Tinkerforge/kicad-libraries/3d/Batteries/battery_retainer_small.fcstd

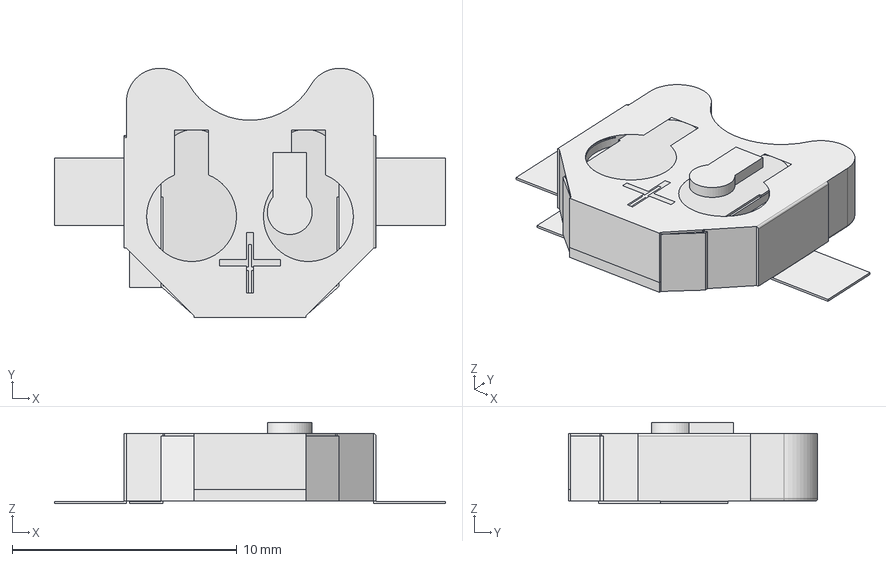
[picture p1: CAD file, 2018-07-31]
3d/Batteries/battery_retainer_small.fcstd
17.4 x 11.1 x 3.62 mm
battery
battery001
