Tinkerforge/kicad-libraries/3d/Buttons_Switches/DIP_SW_2LPST.step

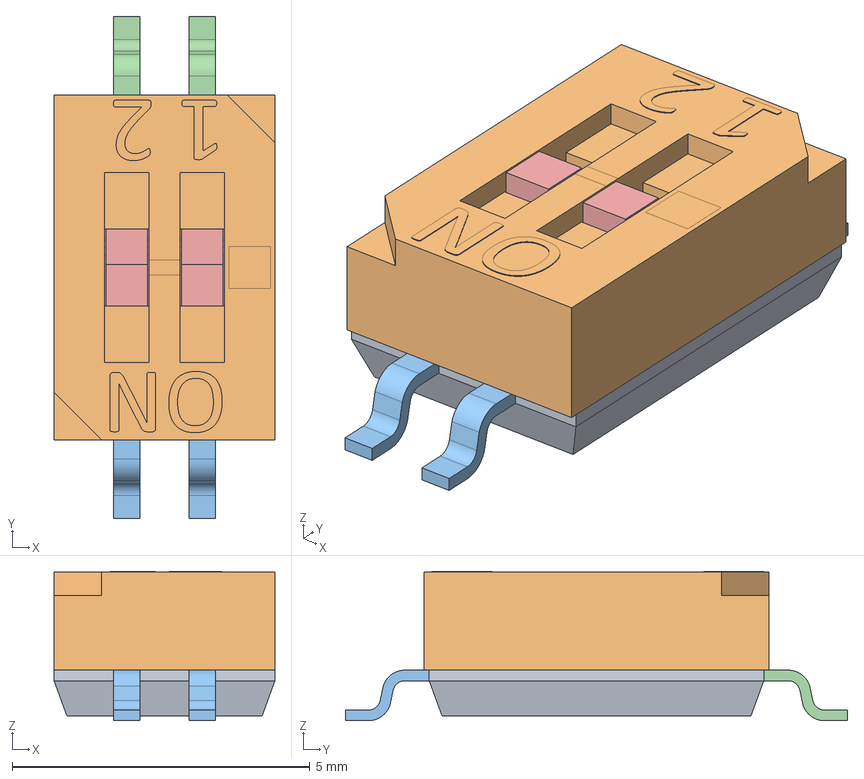
[picture p2: CAD file, 2025-08-05]
3d/Buttons_Switches/DIP_SW_2LPST.step
3.71 x 8.43 x 2.51 mm
