Tinkerforge/kicad-libraries/3d/Capacitors_SMD/ELNA_DSK.step

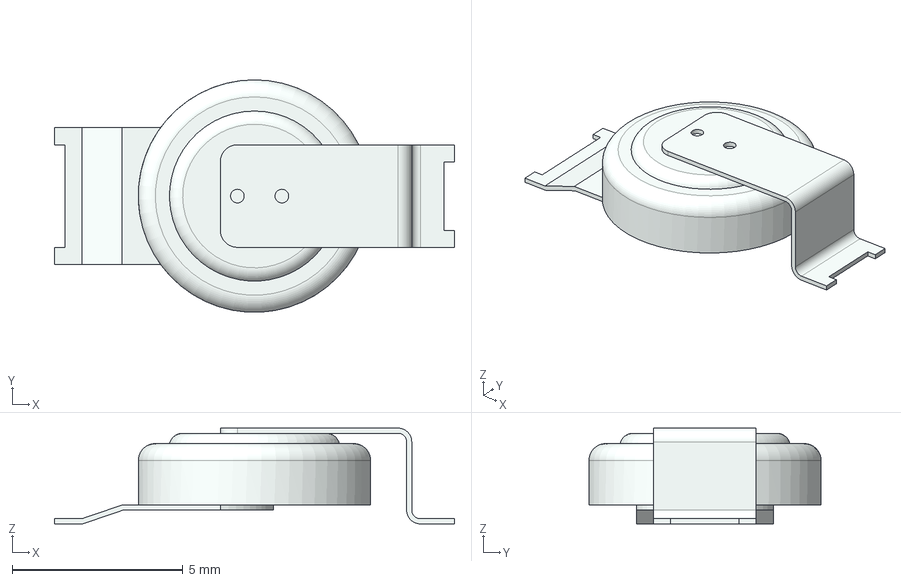
[picture p3: CAD file, 2019-04-26]
3d/Capacitors_SMD/ELNA_DSK.step
11.7 x 6.80 x 2.80 mm
