Tinkerforge/kicad-libraries/3d/Capacitors_Tantalum_SMD/Tantalum_Case-T_EIA-3528-12.step

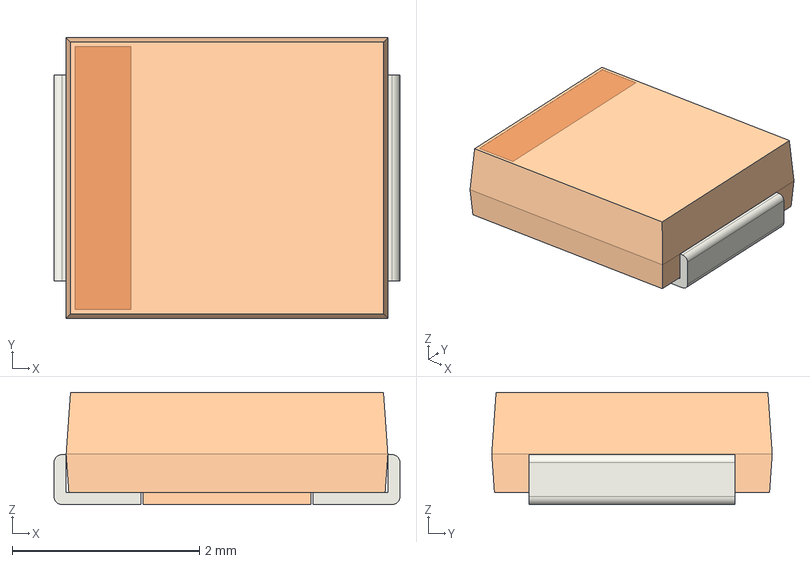
[picture p4: CAD file, 2017-03-24]
3d/Capacitors_Tantalum_SMD/Tantalum_Case-T_EIA-3528-12.step
3.70 x 3.00 x 1.20 mm
