Tinkerforge/kicad-libraries/3d/Connectors/TBLH10_350_05.step

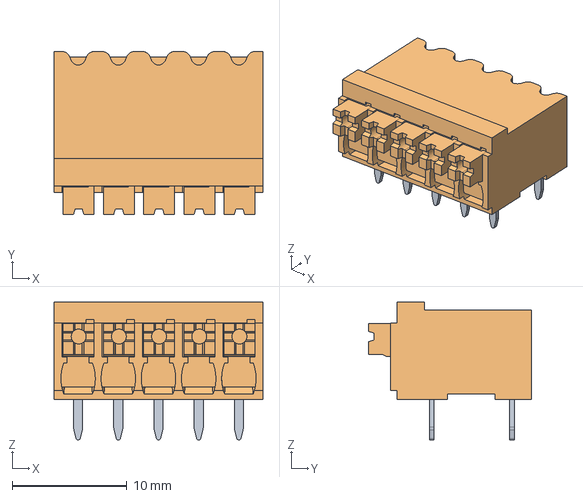
[picture p5: CAD file, 2025-08-05]
3d/Connectors/TBLH10_350_05.step
18.2 x 14.2 x 12.0 mm
