Tinkerforge/kicad-libraries/3d/Fuses/Fuse_Holder_5x20_HOR.step

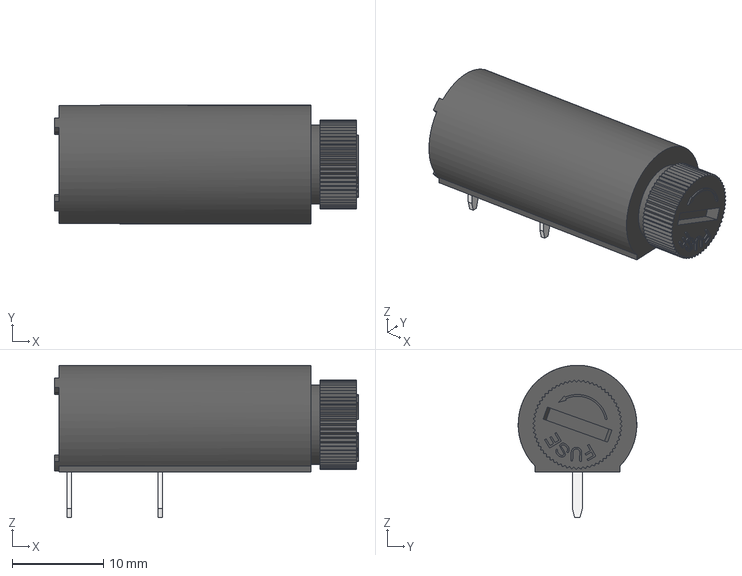
[picture p6: CAD file, 2023-06-30]
3d/Fuses/Fuse_Holder_5x20_HOR.step
33.3 x 13.0 x 16.7 mm
