Tinkerforge/kicad-libraries/3d/Housing_BGA/TFBGA-336_14x14mm.step

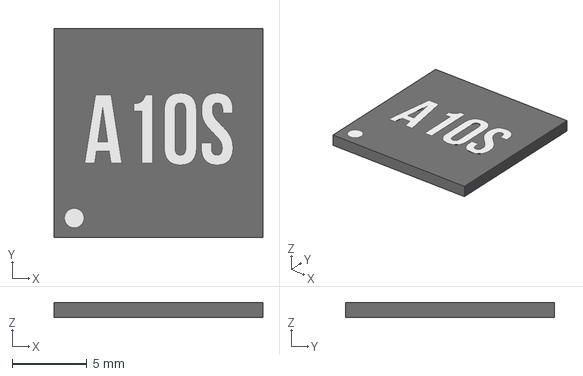
[picture p7: CAD file, 2017-07-27]
3d/Housing_BGA/TFBGA-336_14x14mm.step
14.0 x 14.0 x 1.01 mm
