Tinkerforge/kicad-libraries/3d/Housing_SO/SOP4.step

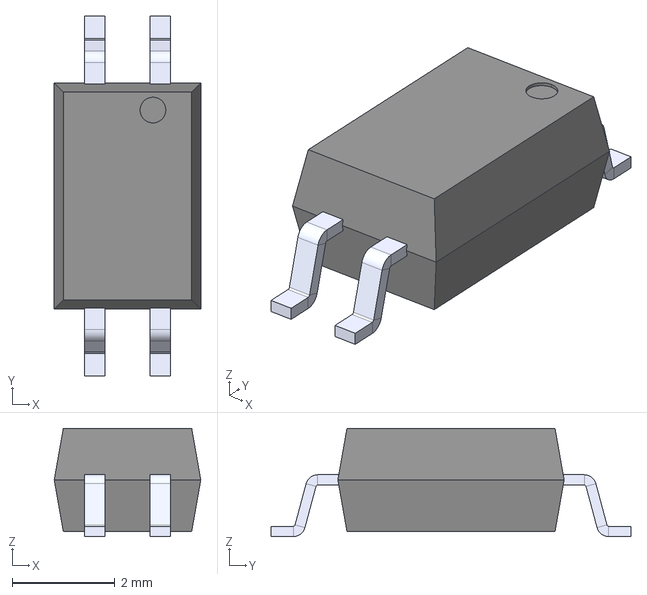
[picture p8: CAD file, 2023-06-30]
3d/Housing_SO/SOP4.step
2.85 x 7.00 x 2.10 mm
