Tinkerforge/kicad-libraries/3d/Housing_SOT_SOD/SSOT-6.step

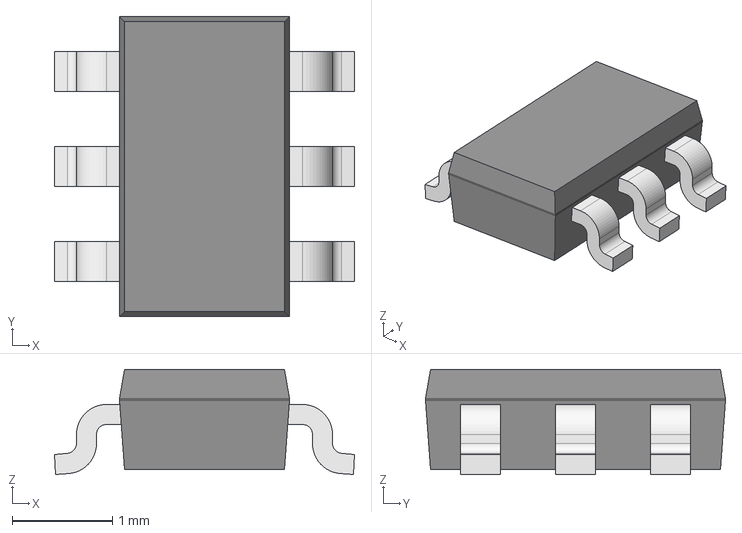
[picture p9: CAD file, 2017-08-04]
3d/Housing_SOT_SOD/SSOT-6.step
3.00 x 3.00 x 1.05 mm
