Tinkerforge/kicad-libraries/3d/Housing_special/ESP32-WROVER-E.step

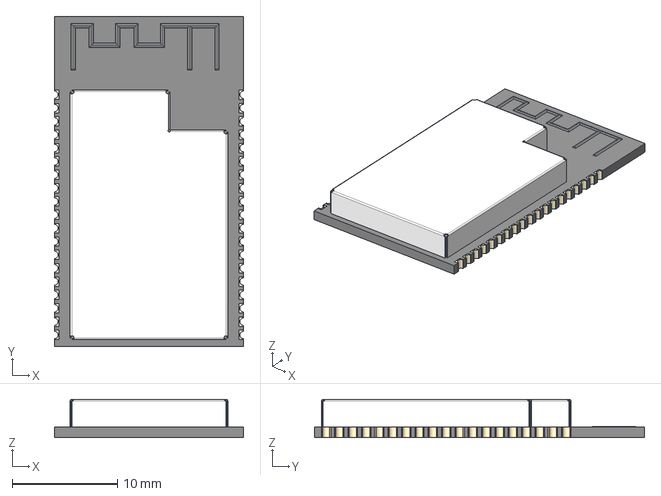
[picture p10: CAD file, 2022-04-01]
3d/Housing_special/ESP32-WROVER-E.step
18.0 x 31.4 x 3.65 mm
