Tinkerforge/kicad-libraries/3d/Housing_SSOP/SSO-8.step

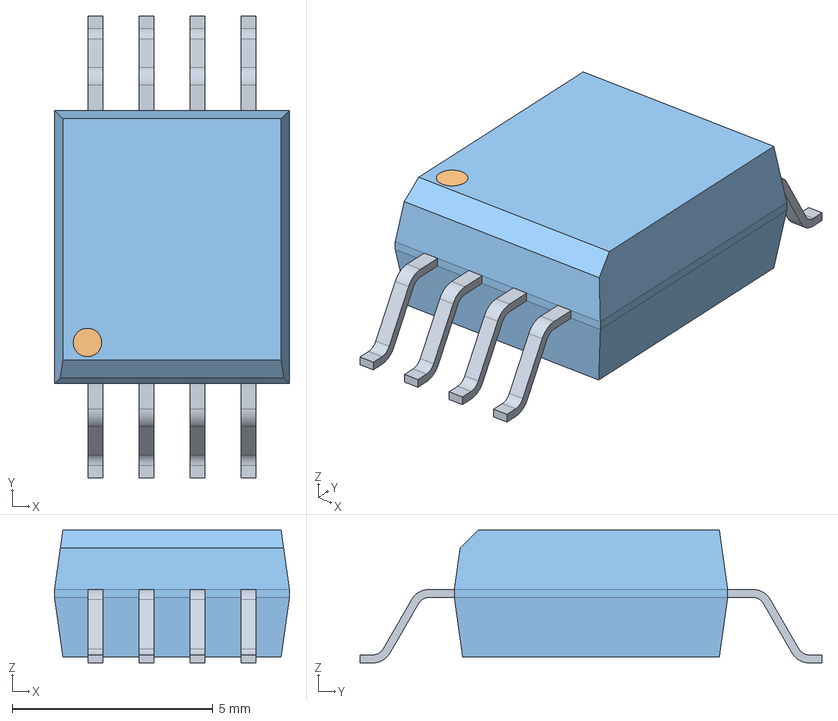
[picture p11: CAD file, 2026-03-05]
3d/Housing_SSOP/SSO-8.step
5.85 x 11.5 x 3.31 mm
