Tinkerforge/kicad-libraries/3d/Housings_DFN_QFN/LFCS8-3x3.step

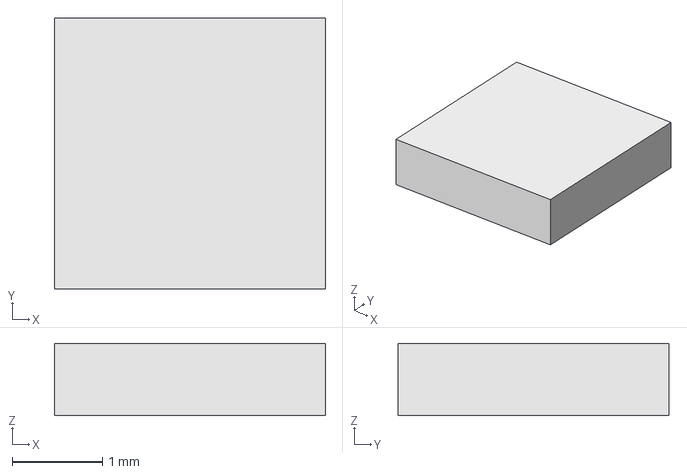
[picture p12: CAD file, 2019-11-07]
3d/Housings_DFN_QFN/LFCS8-3x3.step
3.00 x 3.00 x 0.8 mm
