Tinkerforge/kicad-libraries/3d/Housings_DIP/PDIP-8.step

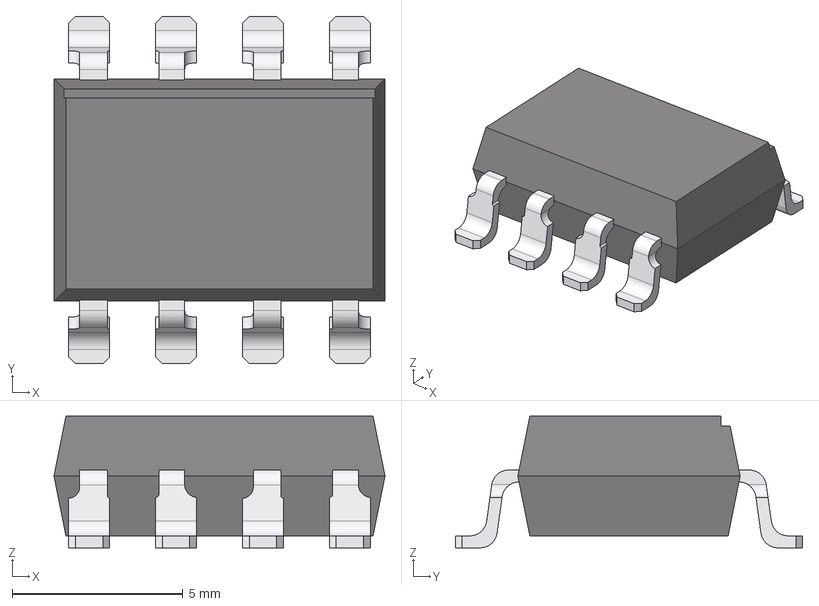
[picture p13: CAD file, 2023-02-17]
3d/Housings_DIP/PDIP-8.step
9.68 x 10.2 x 3.85 mm
