Tinkerforge/kicad-libraries/3d/Housings_DO/SMB.step

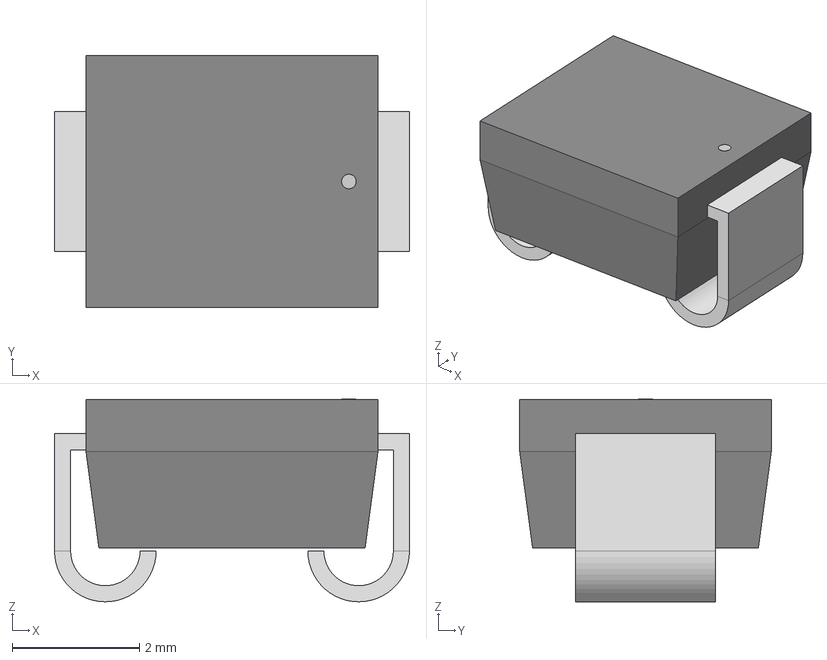
[picture p14: CAD file, 2019-11-05]
3d/Housings_DO/SMB.step
5.59 x 3.96 x 3.19 mm
