Tinkerforge/kicad-libraries/3d/Housings_QFP/LQFP-52-1EP_10x10mm_Pitch0.65mm.step

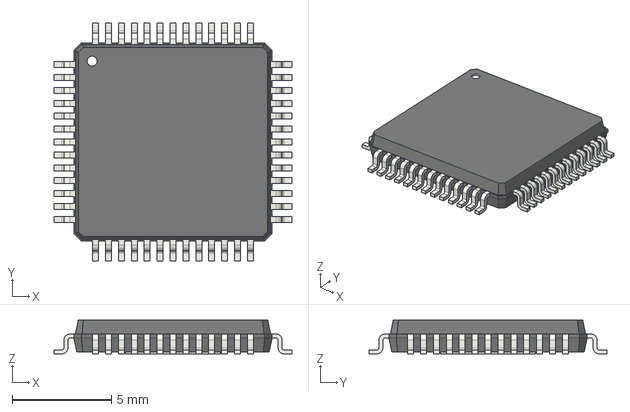
[picture p15: CAD file, 2017-03-24]
3d/Housings_QFP/LQFP-52-1EP_10x10mm_Pitch0.65mm.step
12.0 x 12.0 x 1.70 mm
