Tinkerforge/kicad-libraries/3d/Housings_SC/SC-70-5.step

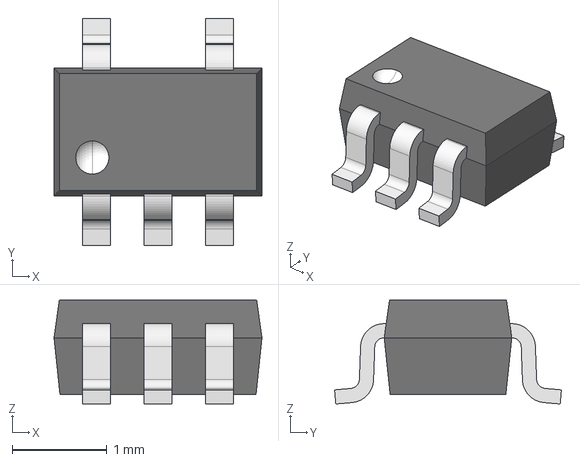
[picture p16: CAD file, 2017-10-23]
3d/Housings_SC/SC-70-5.step
2.20 x 2.40 x 1.10 mm
