Tinkerforge/kicad-libraries/3d/Housings_SOIC/SOIC-16_7.5x10.3mm_Pitch1.27mm.step

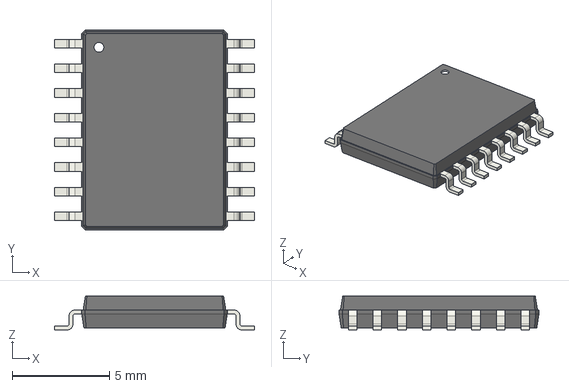
[picture p17: CAD file, 2017-03-24]
3d/Housings_SOIC/SOIC-16_7.5x10.3mm_Pitch1.27mm.step
10.3 x 10.3 x 1.75 mm
