Tinkerforge/kicad-libraries/3d/Housings_TO/TO-220AC.step

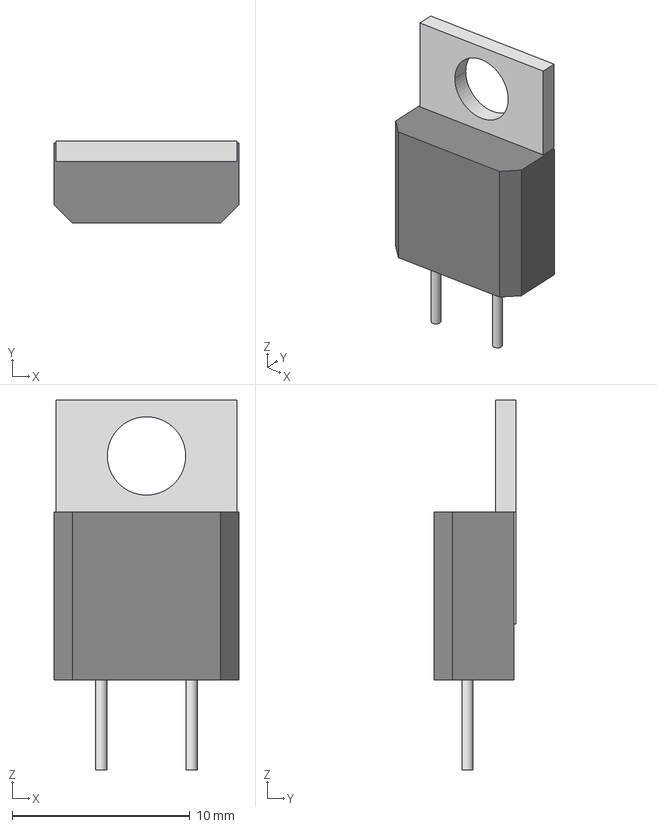
[picture p18: CAD file, 2024-02-02]
3d/Housings_TO/TO-220AC.step
10.4 x 4.60 x 20.8 mm
