Tinkerforge/kicad-libraries/3d/Inductors/WE-TFC.step

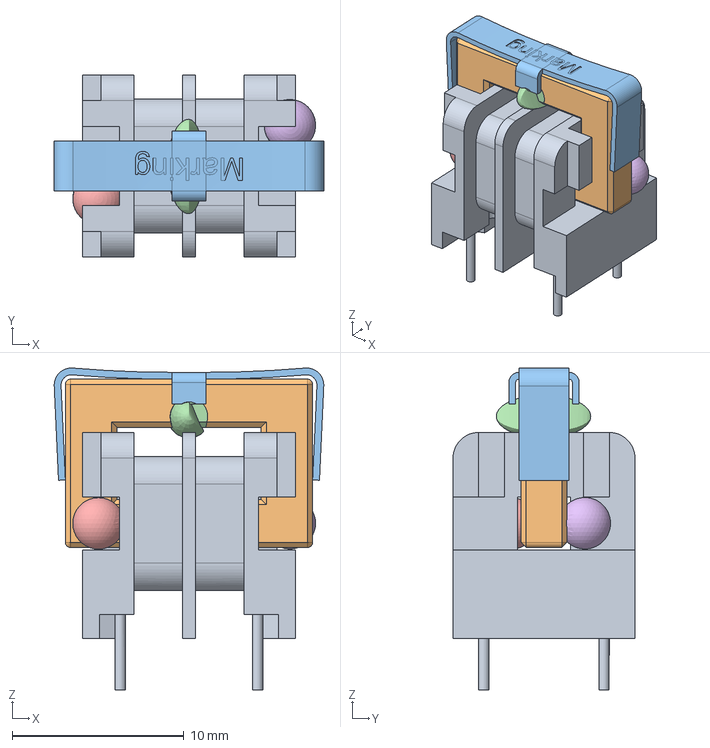
[picture p19: CAD file, 2026-10-27]
3d/Inductors/WE-TFC.step
15.7 x 10.6 x 18.8 mm
