Tinkerforge/kicad-libraries/3d/LED_SMD/LED-C-XR2S1.step

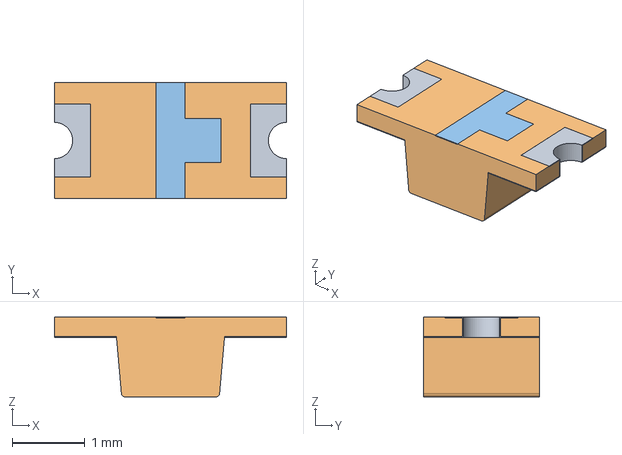
[picture p20: CAD file, 2026-03-06]
3d/LED_SMD/LED-C-XR2S1.step
3.20 x 1.60 x 1.10 mm
