Tinkerforge/kicad-libraries/3d/Oscillators_SMD/AB26TRQ.step

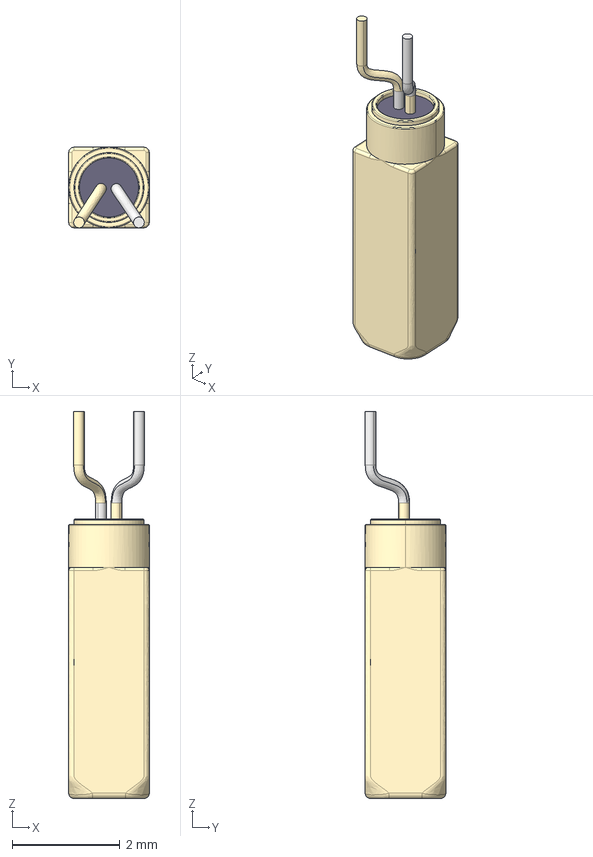
[picture p21: CAD file, 2018-01-22]
3d/Oscillators_SMD/AB26TRQ.step
1.50 x 1.50 x 7.20 mm
