Tinkerforge/kicad-libraries/3d/PG-USON-10-2.step

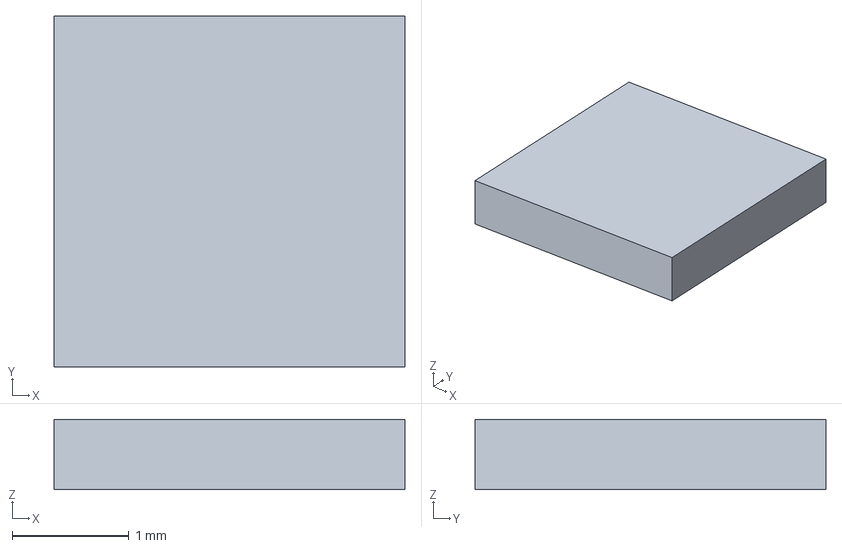
[picture p22: CAD file, 2026-03-05]
3d/PG-USON-10-2.step
3.00 x 3.00 x 0.6 mm
