Tinkerforge/kicad-libraries/3d/Pin_Header/pin-array_3x5.step

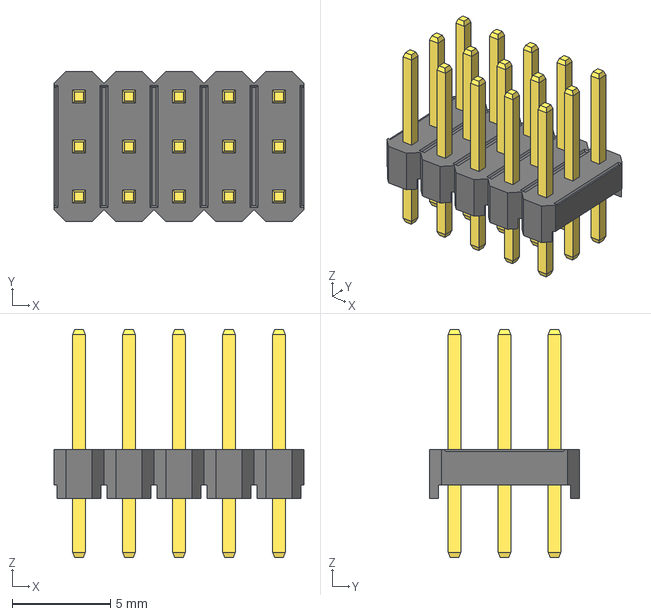
[picture p23: CAD file, 2021-03-15]
3d/Pin_Header/pin-array_3x5.step
12.7 x 7.62 x 11.6 mm
