Tinkerforge/kicad-libraries/3d/Potentiometers/F6005N.step

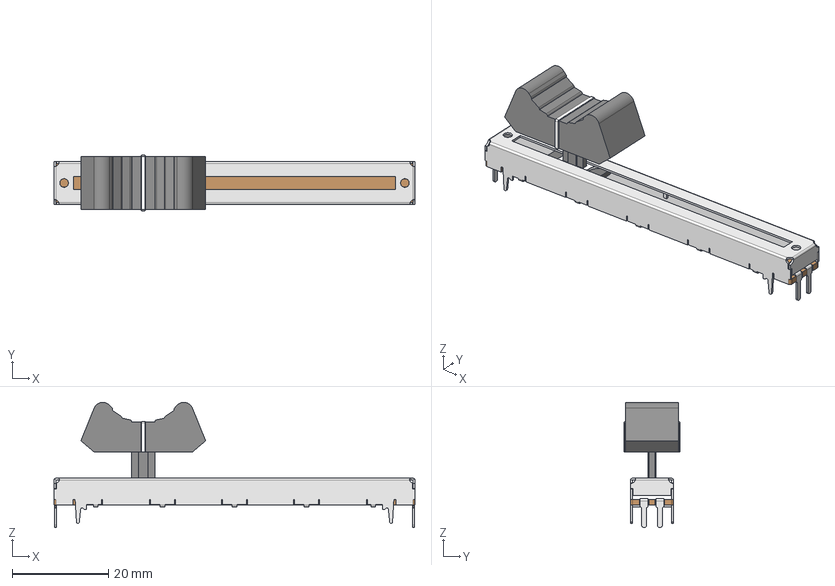
[picture p24: CAD file, 2019-05-09]
3d/Potentiometers/F6005N.step
75.2 x 11.6 x 26.1 mm
