Tinkerforge/kicad-libraries/3d/Resistors_SMD/R_4x1206.step

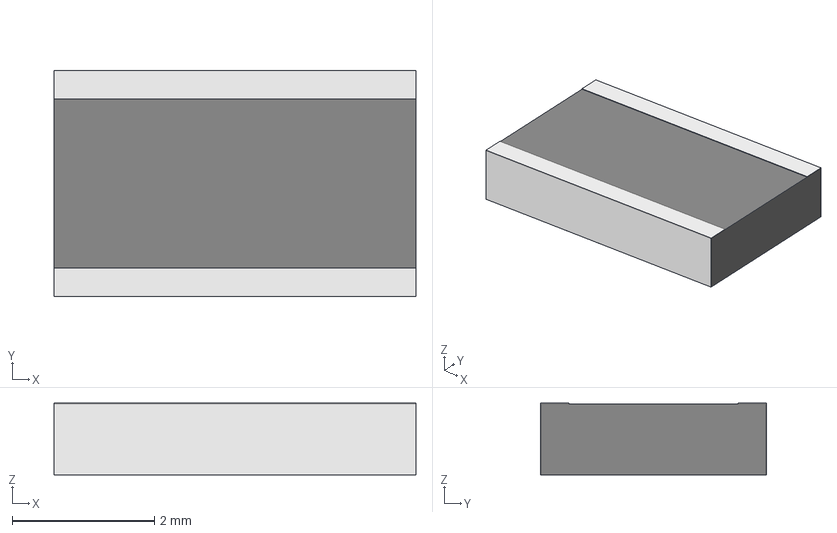
[picture p25: CAD file, 2017-07-31]
3d/Resistors_SMD/R_4x1206.step
5.10 x 3.18 x 1.01 mm
