Tinkerforge/kicad-libraries/3d/Sensors_Detectors/PA1616D.step

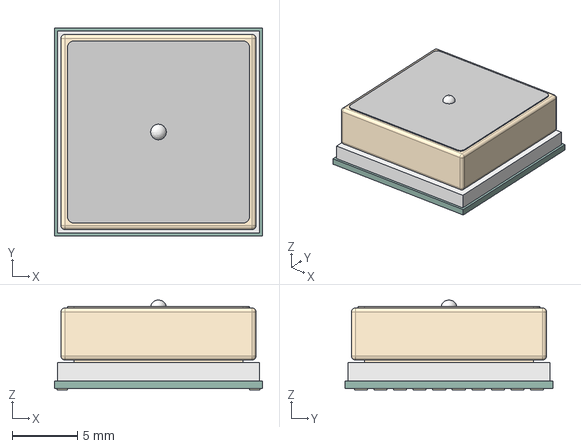
[picture p26: CAD file, 2022-07-01]
3d/Sensors_Detectors/PA1616D.step
16.0 x 16.0 x 6.90 mm
