Tinkerforge/kicad-libraries/3d/unsorted/MYBSP_PoE.step

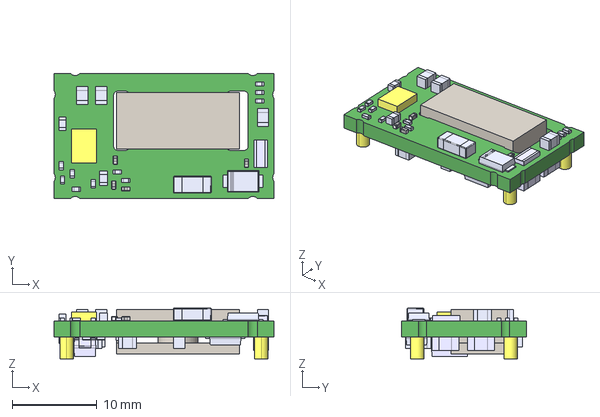
[picture p27: CAD file, 2026-10-27]
3d/unsorted/MYBSP_PoE.step
26.0 x 14.8 x 6.00 mm
