Tinkerforge/kicad-libraries/3d/Batteries/battery_retainer_2998.step

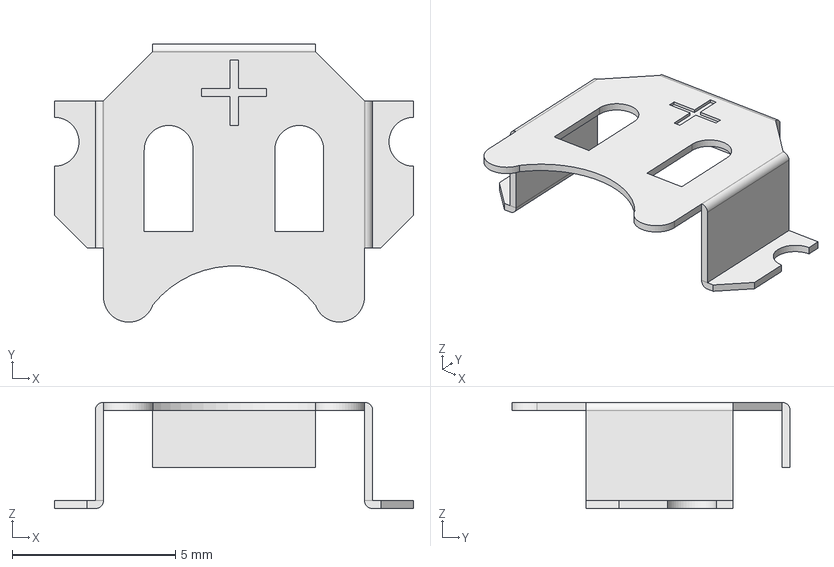
[picture p28: CAD file, 2018-01-30]
3d/Batteries/battery_retainer_2998.step
11.0 x 8.53 x 3.25 mm
