Tinkerforge/kicad-libraries/3d/Buttons_Switches/SW_DIP_5_THT_90.step

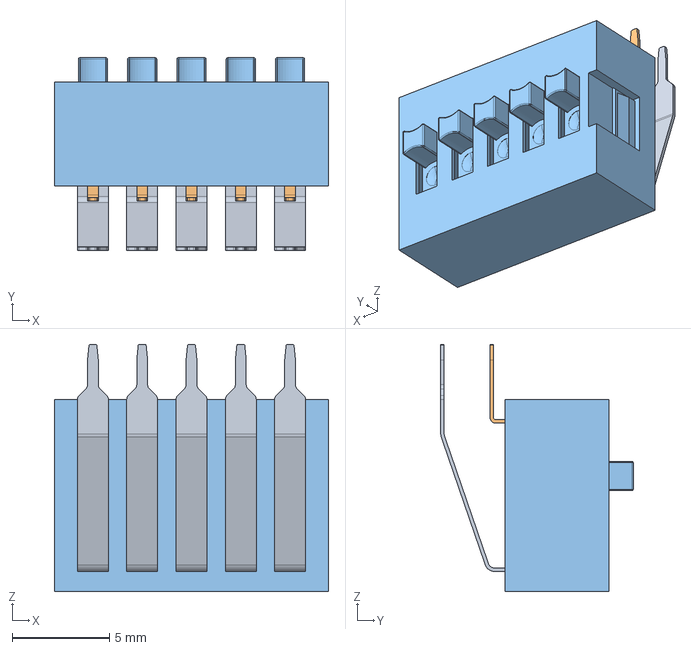
[picture p29: CAD file, 2025-07-31]
3d/Buttons_Switches/SW_DIP_5_THT_90.step
14.1 x 9.92 x 12.7 mm
