Tinkerforge/kicad-libraries/3d/Capacitors_SMD/C_0805P.step

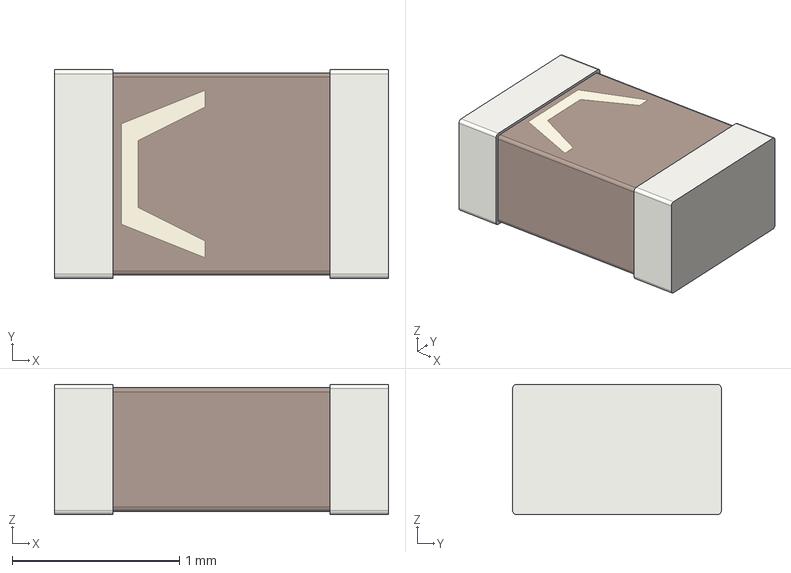
[picture p30: CAD file, 2017-08-03]
3d/Capacitors_SMD/C_0805P.step
2.00 x 1.25 x 0.78 mm
