Tinkerforge/kicad-libraries/3d/Capacitors_Tantalum_SMD/Tantalum_Case-E_EIA-7260-38.step

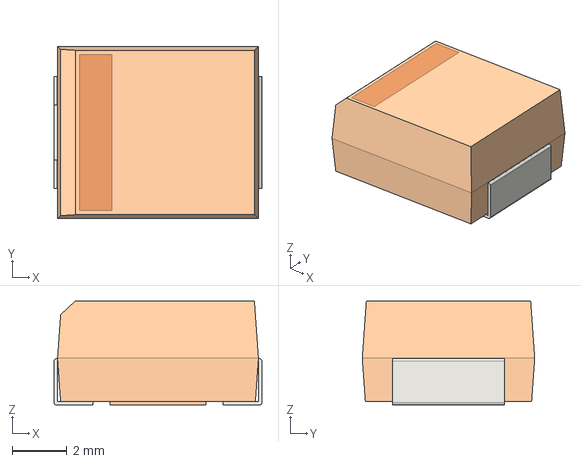
[picture p31: CAD file, 2017-03-24]
3d/Capacitors_Tantalum_SMD/Tantalum_Case-E_EIA-7260-38.step
7.60 x 6.30 x 3.80 mm
