Tinkerforge/kicad-libraries/3d/Connectors/BH06B-PASK.step

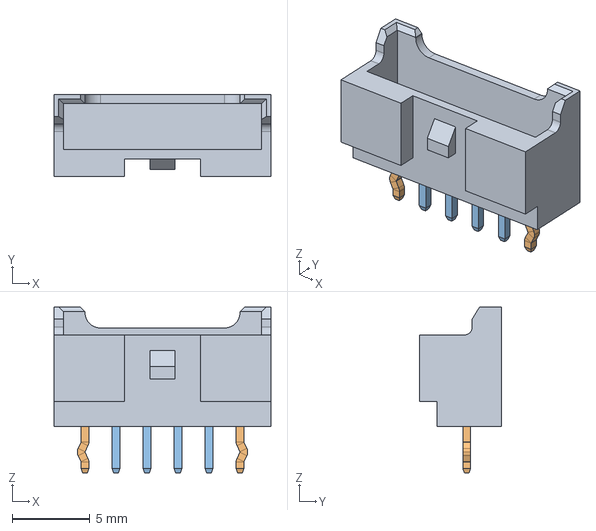
[picture p32: CAD file, 2025-04-14]
3d/Connectors/BH06B-PASK.step
14.0 x 5.30 x 10.7 mm
