Tinkerforge/kicad-libraries/3d/Fuses/0PTF0078P.step

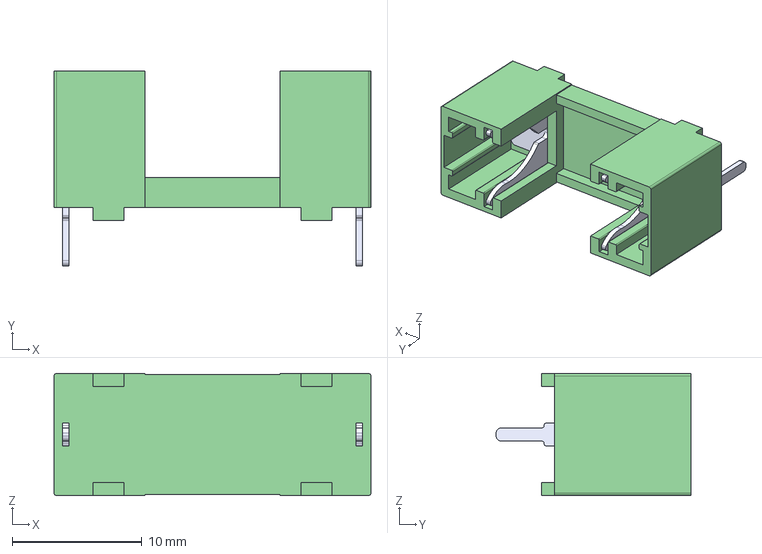
[picture p33: CAD file, 2023-02-17]
3d/Fuses/0PTF0078P.step
24.4 x 15.0 x 9.40 mm
