Tinkerforge/kicad-libraries/3d/Housing_BGA/FBGA-96_14x9mm.step

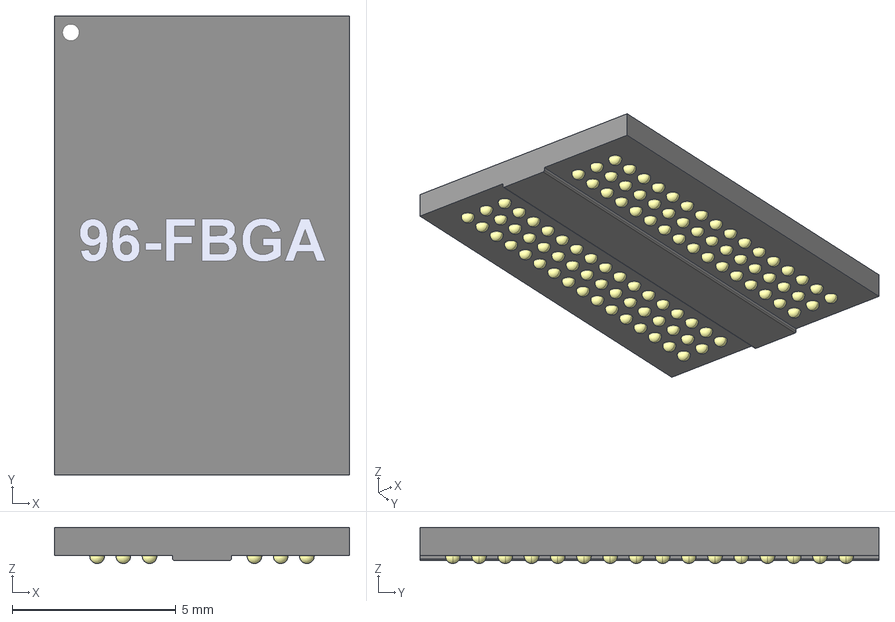
[picture p34: CAD file, 2017-07-11]
3d/Housing_BGA/FBGA-96_14x9mm.step
9.00 x 14.0 x 1.10 mm
