Tinkerforge/kicad-libraries/3d/Housing_SO/SON_5x6mm.step

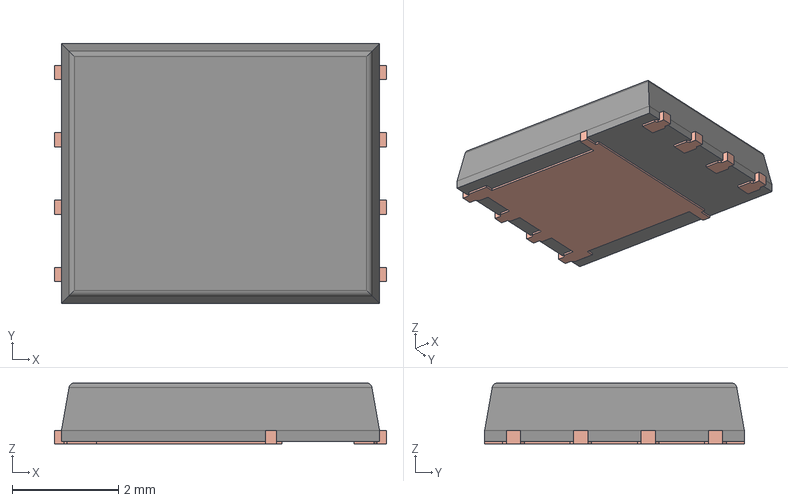
[picture p35: CAD file, 2020-01-24]
3d/Housing_SO/SON_5x6mm.step
6.26 x 4.90 x 1.15 mm
