Tinkerforge/kicad-libraries/3d/Housing_SOT_SOD/SOT-363.step

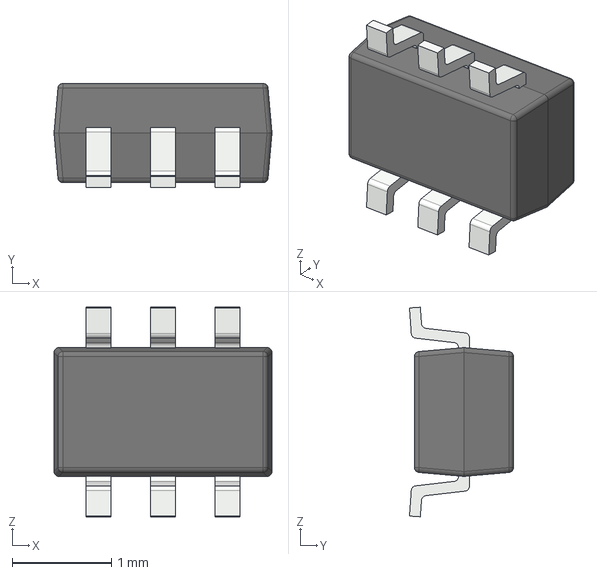
[picture p36: CAD file, 2017-07-11]
3d/Housing_SOT_SOD/SOT-363.step
2.20 x 1.05 x 2.12 mm
