Tinkerforge/kicad-libraries/3d/Housing_special/BL654.step

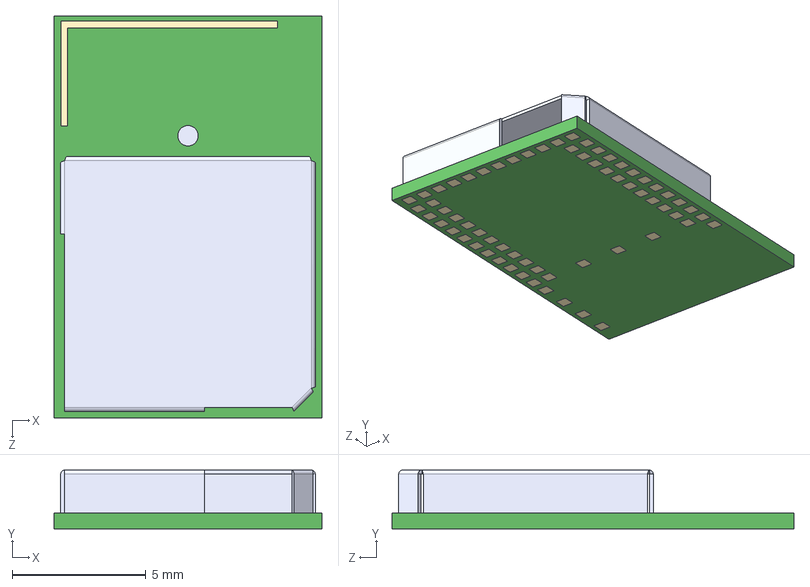
[picture p37: CAD file, 2021-01-25]
3d/Housing_special/BL654.step
10.0 x 2.20 x 15.0 mm
