Tinkerforge/kicad-libraries/3d/Housing_SSOP/HTSSOP28-DRV.step

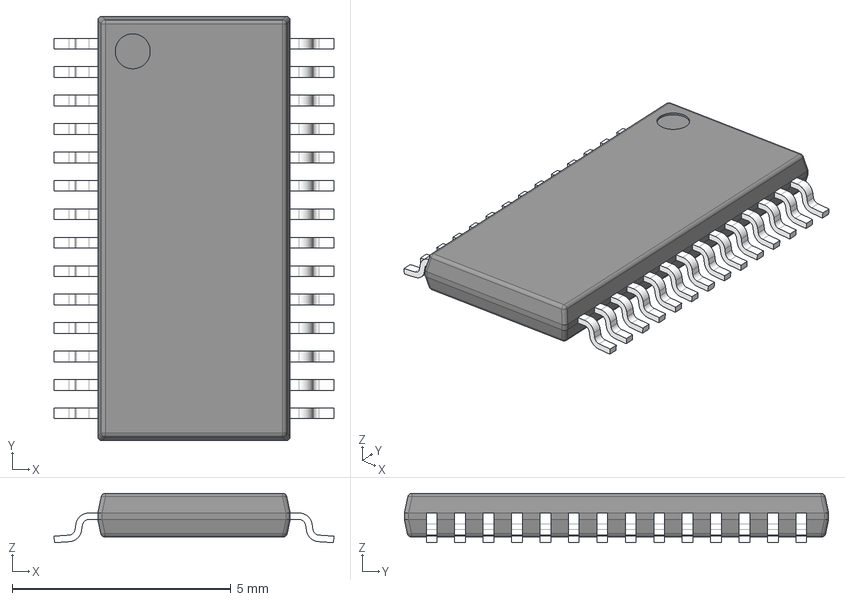
[picture p38: CAD file, 2023-02-17]
3d/Housing_SSOP/HTSSOP28-DRV.step
6.40 x 9.70 x 1.13 mm
BODY-TSSOP
LEAD-TSSOP x 28
PIN1
DAP
