Tinkerforge/kicad-libraries/3d/Housings_DFN_QFN/SIM-CHIP.step

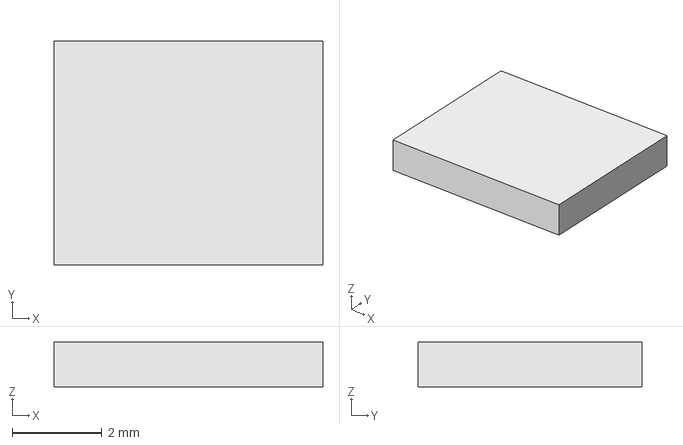
[picture p39: CAD file, 2019-11-07]
3d/Housings_DFN_QFN/SIM-CHIP.step
6.00 x 5.00 x 1.00 mm
