Tinkerforge/kicad-libraries/3d/Housings_DIP/DIP-4-AD_SMD.step

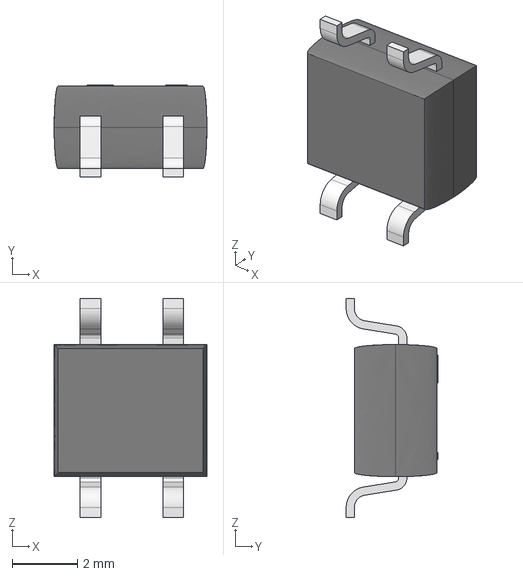
[picture p40: CAD file, 2017-08-04]
3d/Housings_DIP/DIP-4-AD_SMD.step
4.70 x 2.82 x 6.73 mm
