Tinkerforge/kicad-libraries/3d/Housings_DO/SMC.step

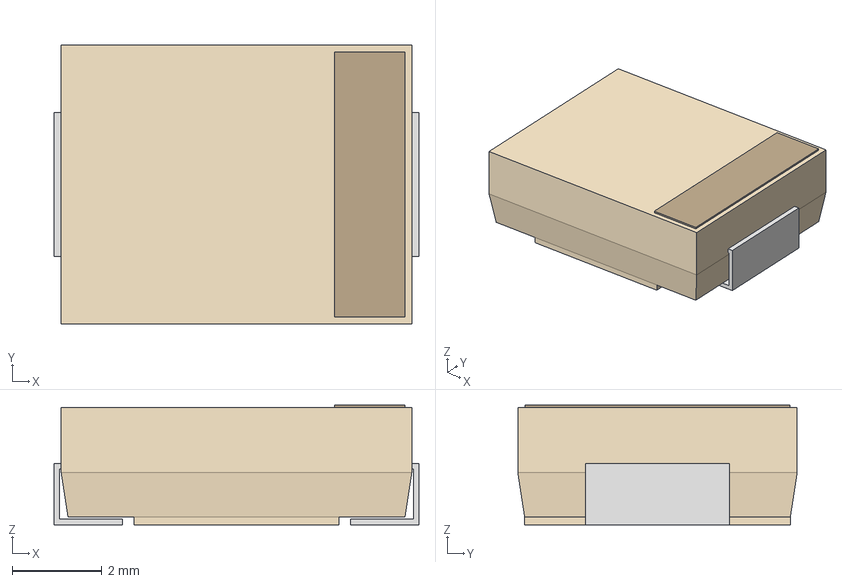
[picture p41: CAD file, 2019-11-05]
3d/Housings_DO/SMC.step
8.13 x 6.22 x 2.67 mm
