Tinkerforge/kicad-libraries/3d/Housings_QFP/LQFP-48_7x7mm_Pitch0.5mm.step

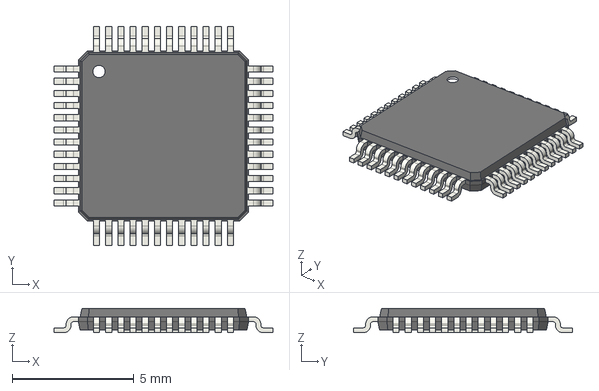
[picture p42: CAD file, 2017-03-24]
3d/Housings_QFP/LQFP-48_7x7mm_Pitch0.5mm.step
9.00 x 9.00 x 1.00 mm
