Tinkerforge/kicad-libraries/3d/Housings_TO/TO263-7.step

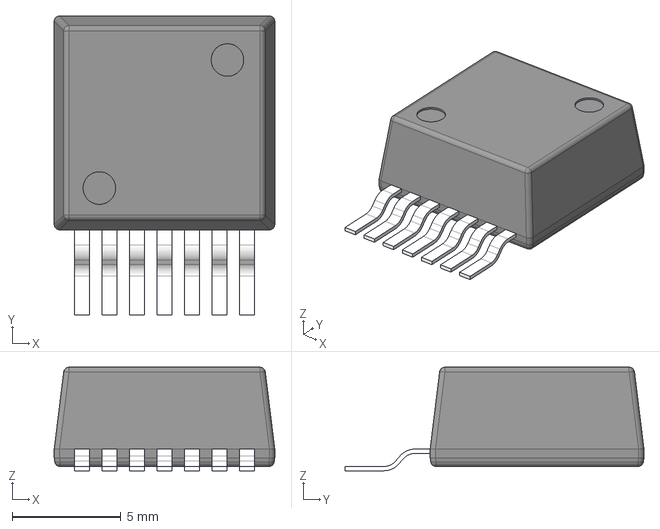
[picture p45: CAD file, 2019-11-05]
3d/Housings_TO/TO263-7.step
10.2 x 13.8 x 4.77 mm
