Tinkerforge/kicad-libraries/3d/Inductors/WE-PD.step

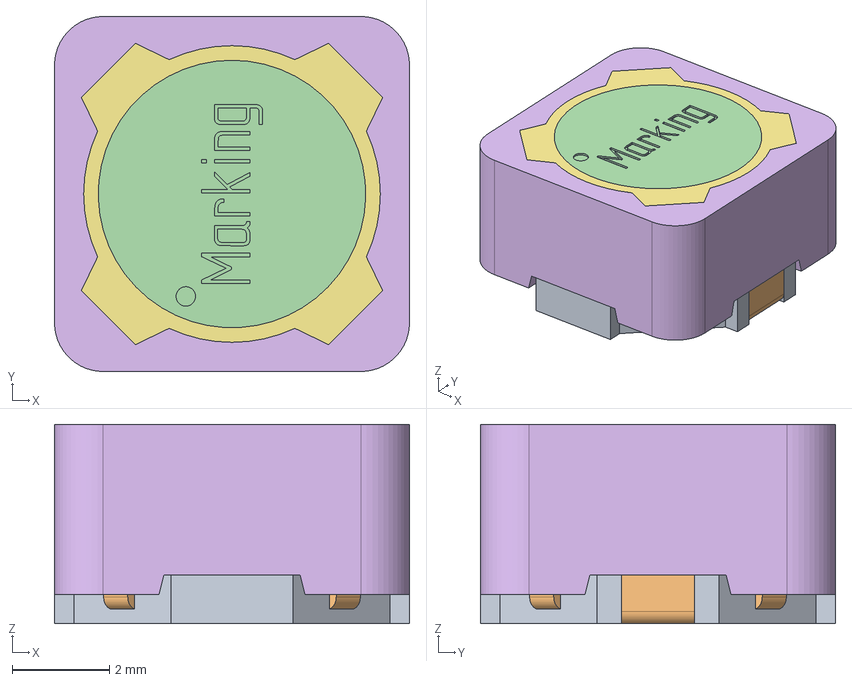
[picture p46: CAD file, 2025-07-31]
3d/Inductors/WE-PD.step
7.30 x 7.30 x 4.10 mm
