Tinkerforge/kicad-libraries/3d/LED_SMD/RGB-LED-EVL-23-23B.step

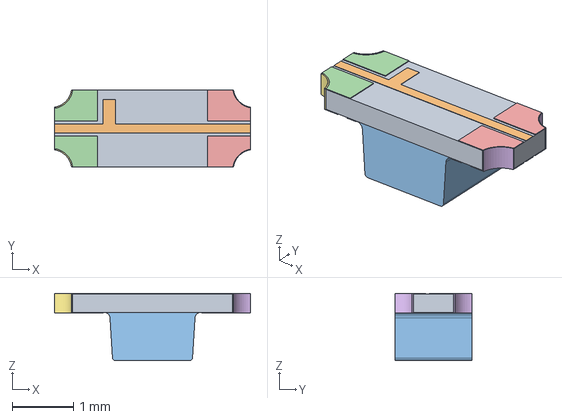
[picture p47: CAD file, 2021-01-29]
3d/LED_SMD/RGB-LED-EVL-23-23B.step
3.20 x 1.25 x 1.10 mm
