Tinkerforge/kicad-libraries/3d/MTJ_88ARX1_FSM_LG.step

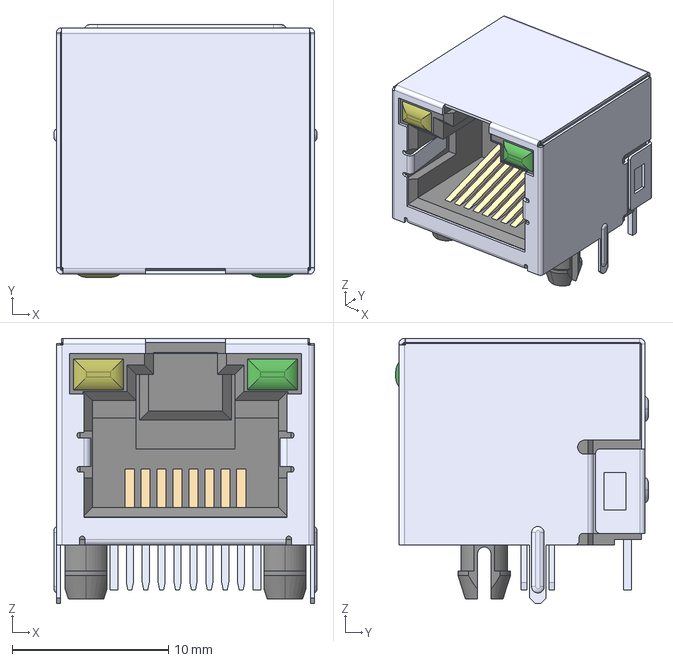
[picture p48: CAD file, 2024-09-24]
3d/MTJ_88ARX1_FSM_LG.step
16.8 x 16.1 x 16.9 mm
