Tinkerforge/kicad-libraries/3d/Oscillators_SMD/5032.step

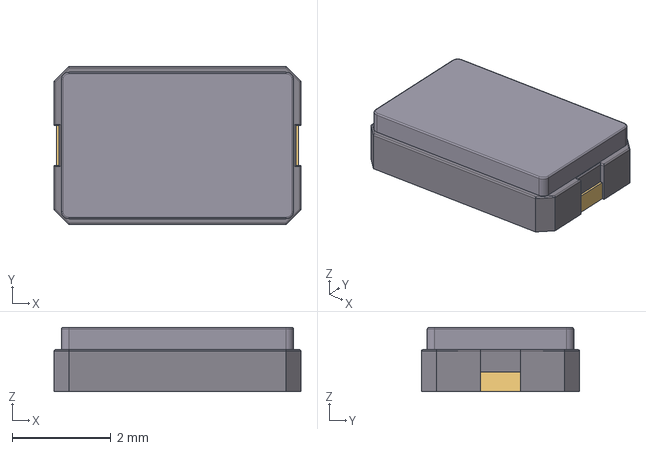
[picture p49: CAD file, 2017-11-06]
3d/Oscillators_SMD/5032.step
5.00 x 3.20 x 1.30 mm
