Tinkerforge/kicad-libraries/3d/Pin_Header/Pin_Header_Straight_2x05_Pitch1.27mm.step

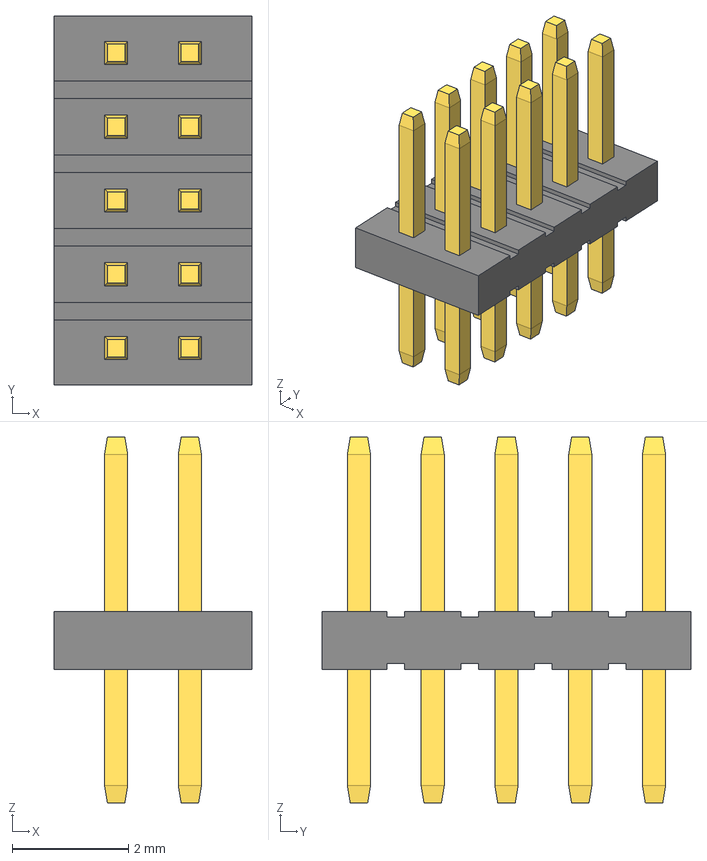
[picture p50: CAD file, 2020-01-29]
3d/Pin_Header/Pin_Header_Straight_2x05_Pitch1.27mm.step
3.40 x 6.35 x 6.30 mm
