Tinkerforge/kicad-libraries/3d/Potentiometers/F6005N Knop.fcstd

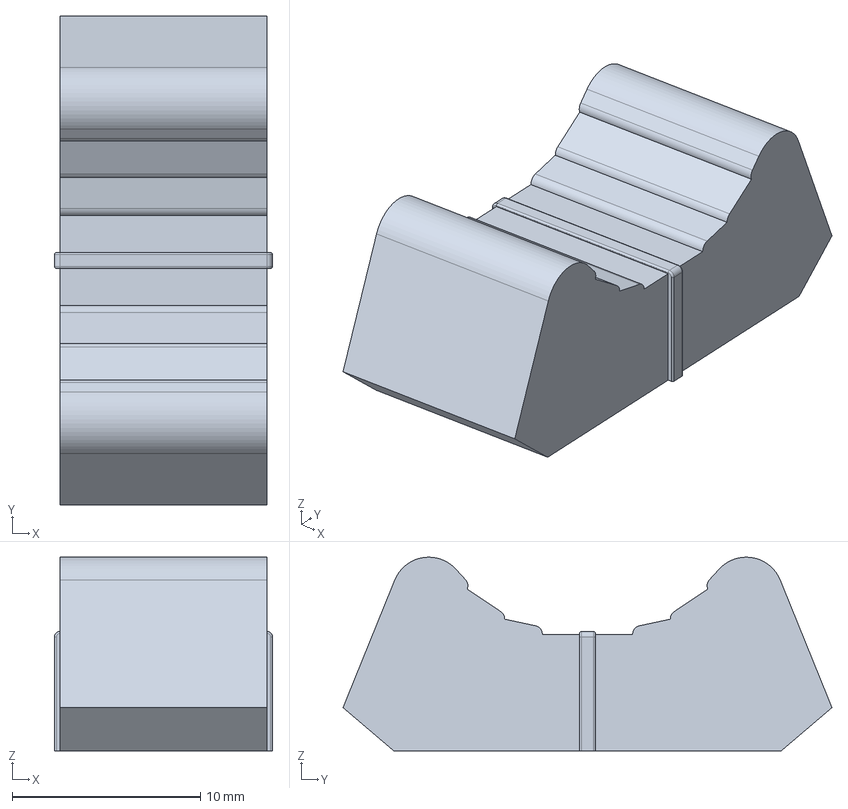
[picture p51: CAD file, 2018-07-31]
3d/Potentiometers/F6005N Knop.fcstd
11.6 x 26.0 x 10.3 mm
