Tinkerforge/kicad-libraries/3d/Resistors_SMD/R_4x0402_2.fcstd

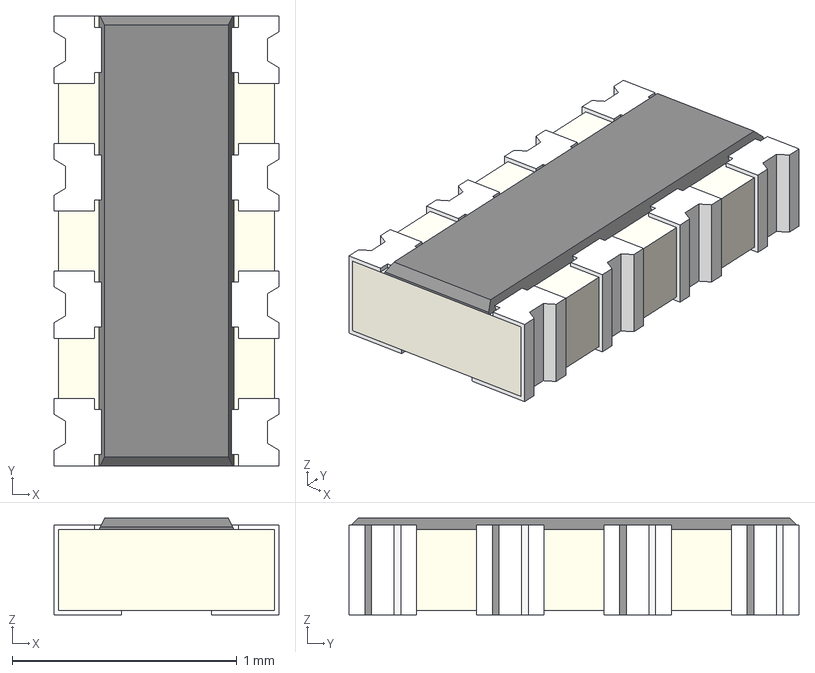
[picture p52: CAD file, 2017-06-16]
3d/Resistors_SMD/R_4x0402_2.fcstd
1.00 x 2.00 x 0.43 mm
