Tinkerforge/kicad-libraries/3d/Sensors_Detectors/4641-X900.step

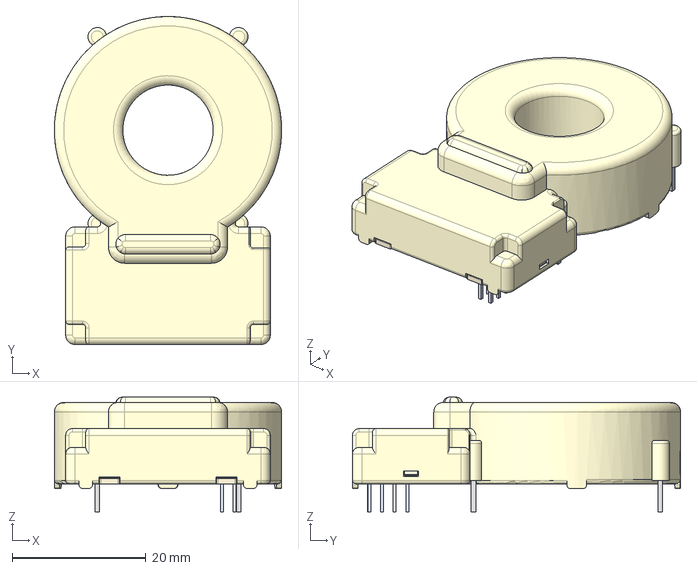
[picture p53: CAD file, 2021-02-23]
3d/Sensors_Detectors/4641-X900.step
34.0 x 49.0 x 17.2 mm
