Tinkerforge/kicad-libraries/3d/unsorted/TPSM84209.step

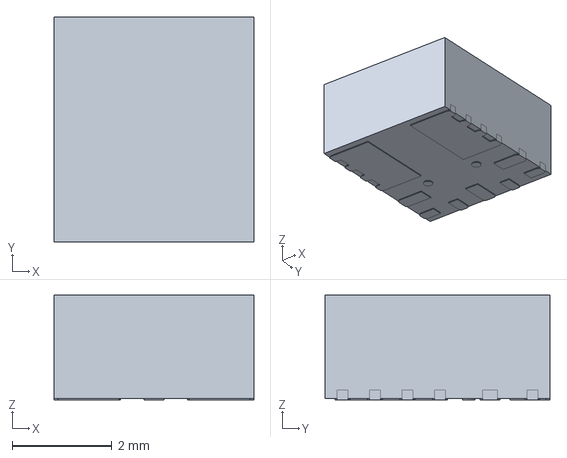
[picture p54: CAD file, 2026-03-05]
3d/unsorted/TPSM84209.step
4.00 x 4.50 x 2.10 mm
