Tinkerforge/kicad-libraries/3d/Batteries/battery_retainer.step

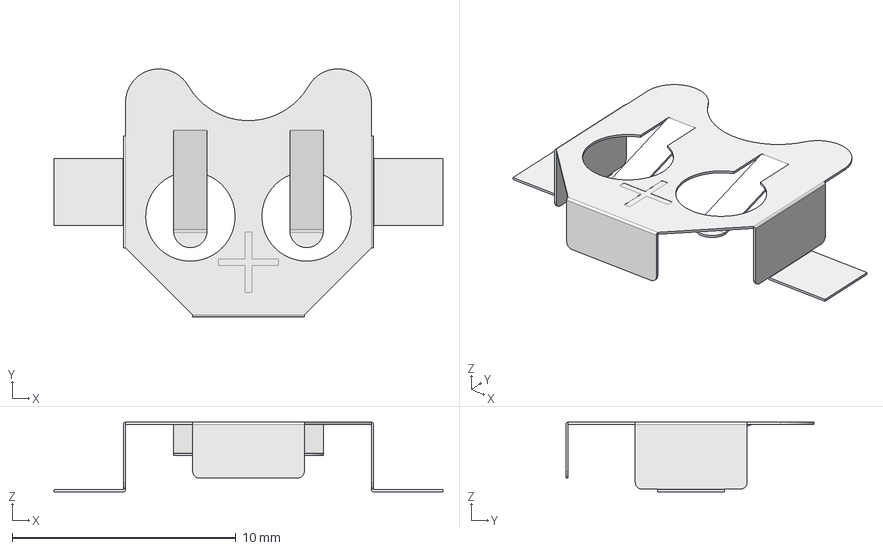
[picture p55: CAD file, 2017-04-28]
3d/Batteries/battery_retainer.step
17.4 x 11.1 x 3.12 mm
