Tinkerforge/kicad-libraries/3d/Buttons_Switches/SW_DIP_4_THT_90.step

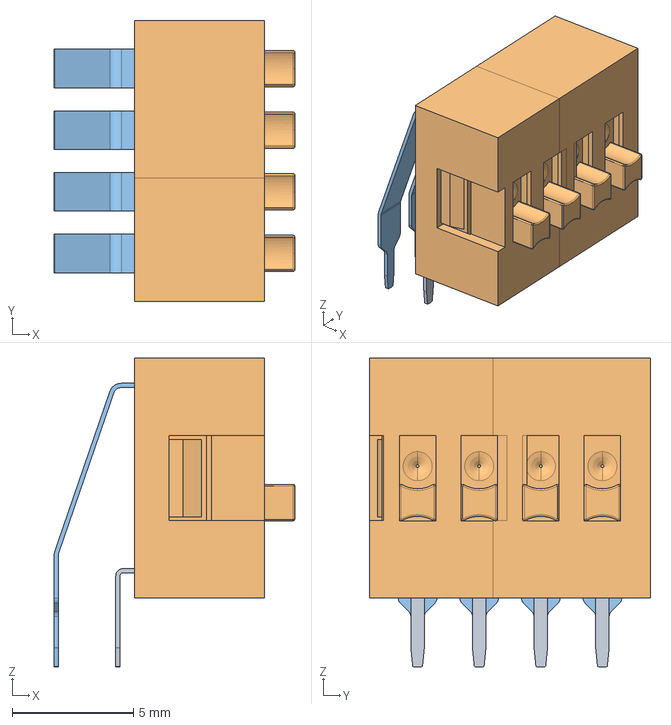
[picture p56: CAD file, 2023-06-30]
3d/Buttons_Switches/SW_DIP_4_THT_90.step
9.92 x 11.6 x 12.7 mm
DIP1
DIP002
