Tinkerforge/kicad-libraries/3d/Capacitors_SMD/ELKO 330.fcstd

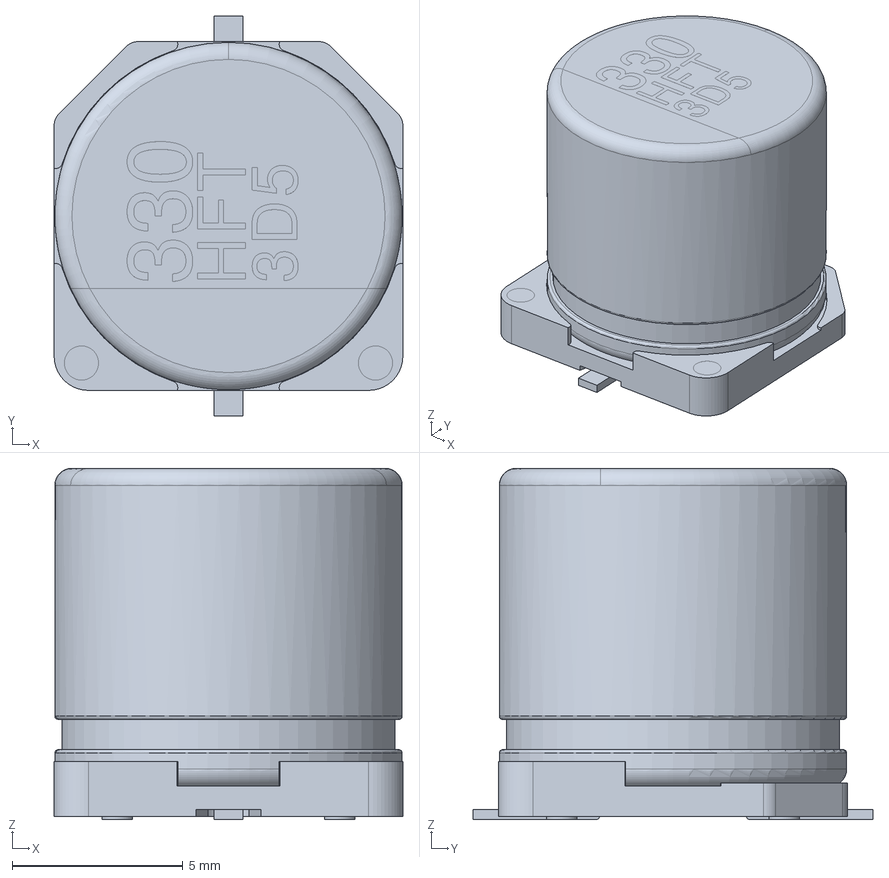
[picture p57: CAD file, 2017-07-11]
3d/Capacitors_SMD/ELKO 330.fcstd
10.2 x 11.7 x 10.3 mm
