Tinkerforge/kicad-libraries/3d/Capacitors_Tantalum_SMD/Tantalum_Case-X_EIA-7343-43.step

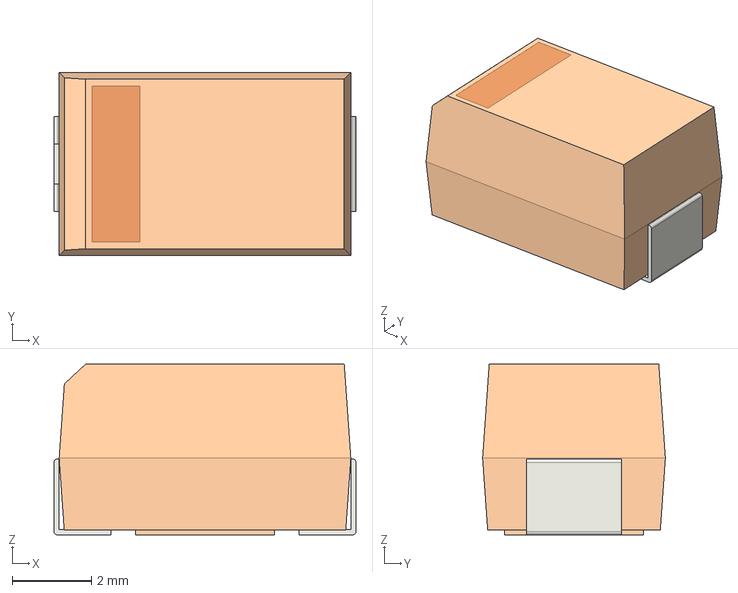
[picture p58: CAD file, 2017-03-24]
3d/Capacitors_Tantalum_SMD/Tantalum_Case-X_EIA-7343-43.step
7.60 x 4.60 x 4.30 mm
