Tinkerforge/kicad-libraries/3d/Capacitors_wired/WE-WCAP-WTX2-P15-1.step

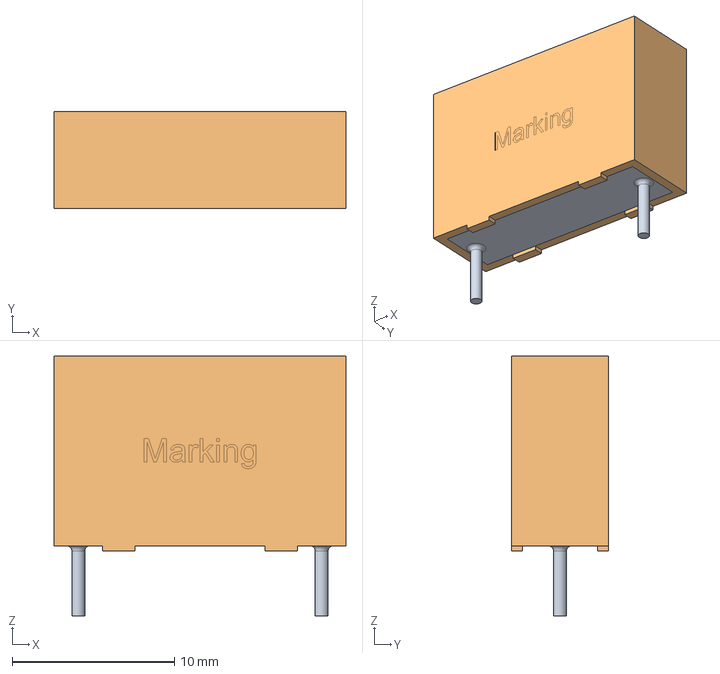
[picture p59: CAD file, 2023-12-01]
3d/Capacitors_wired/WE-WCAP-WTX2-P15-1.step
18.0 x 6.00 x 16.0 mm
