Tinkerforge/kicad-libraries/3d/Connectors/JST-PH-6-THT.step

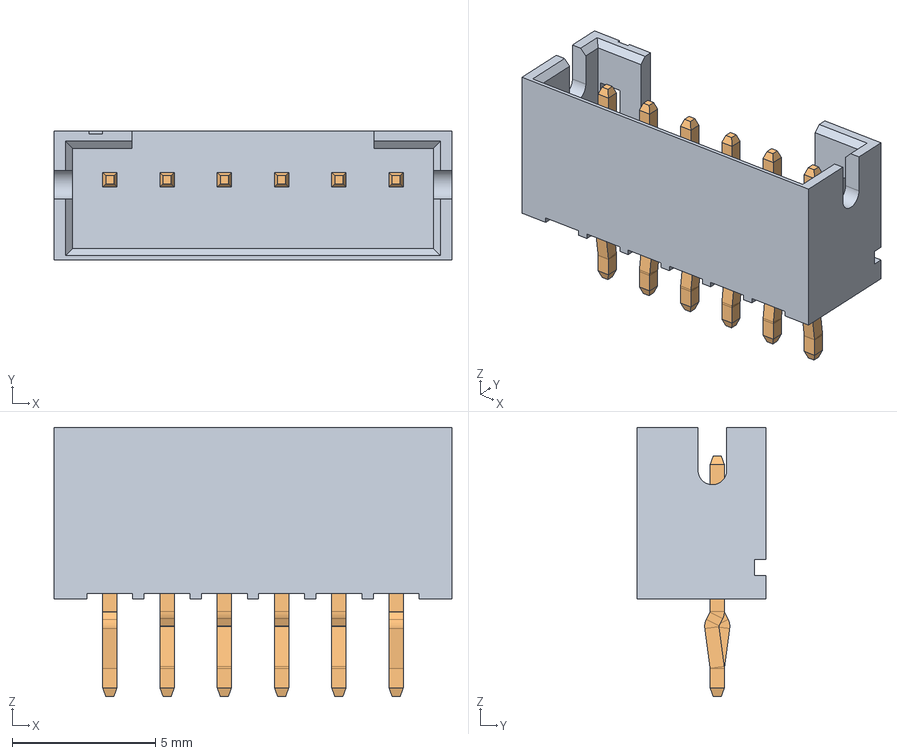
[picture p60: CAD file, 2025-01-22]
3d/Connectors/JST-PH-6-THT.step
13.9 x 4.50 x 9.40 mm
