Tinkerforge/kicad-libraries/3d/Connectors_TF/PE_Hook.step

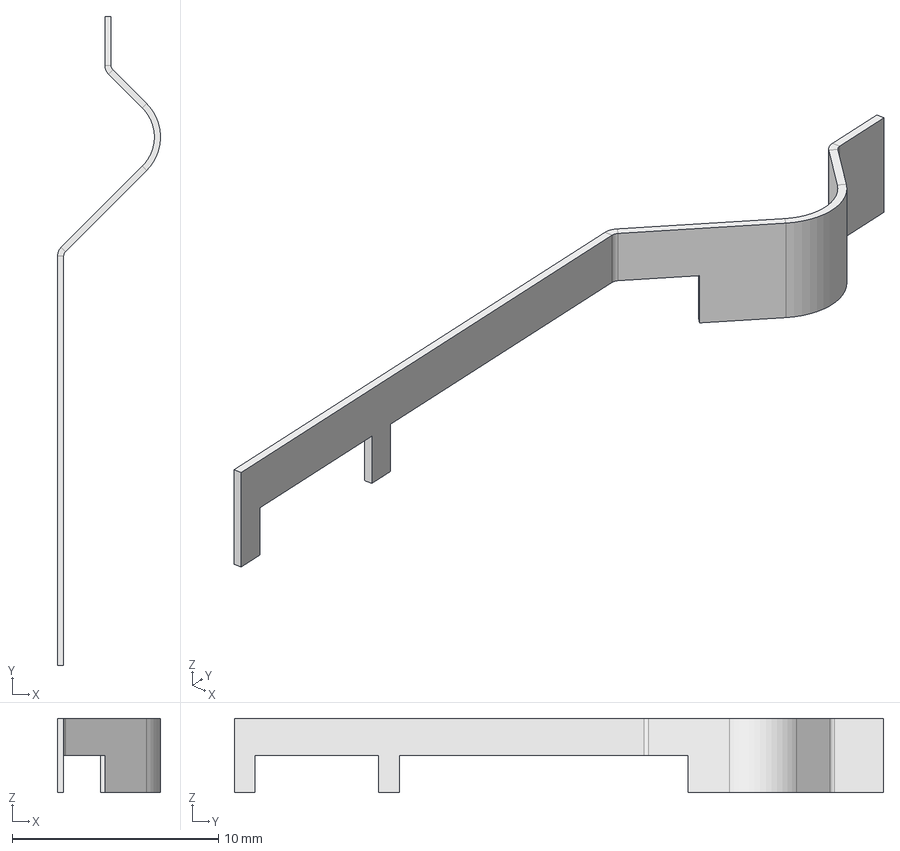
[picture p61: CAD file, 2020-03-11]
3d/Connectors_TF/PE_Hook.step
5.00 x 31.5 x 3.60 mm
