Tinkerforge/kicad-libraries/3d/Fuses/MRF.step

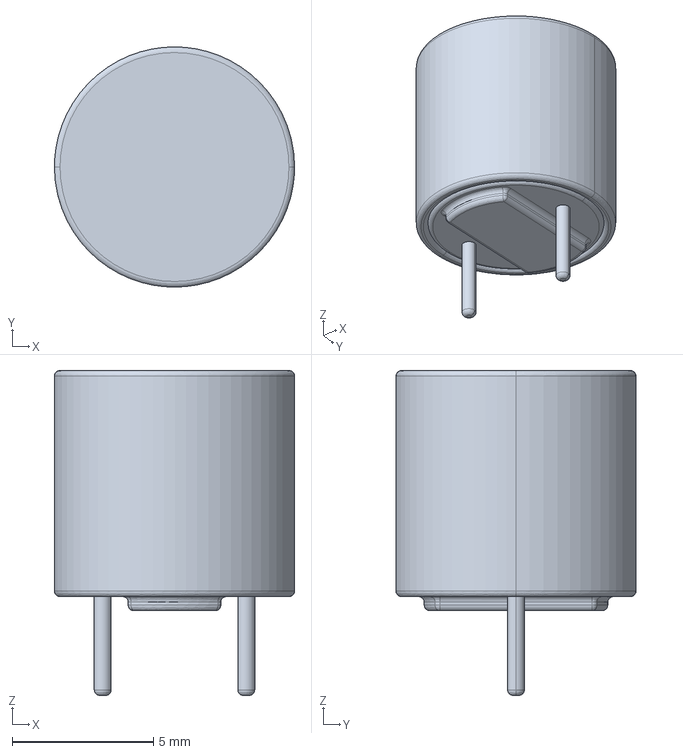
[picture p62: CAD file, 2020-08-06]
3d/Fuses/MRF.step
8.50 x 8.50 x 11.5 mm
