Tinkerforge/kicad-libraries/3d/Housing_SO/CPC1907B.step

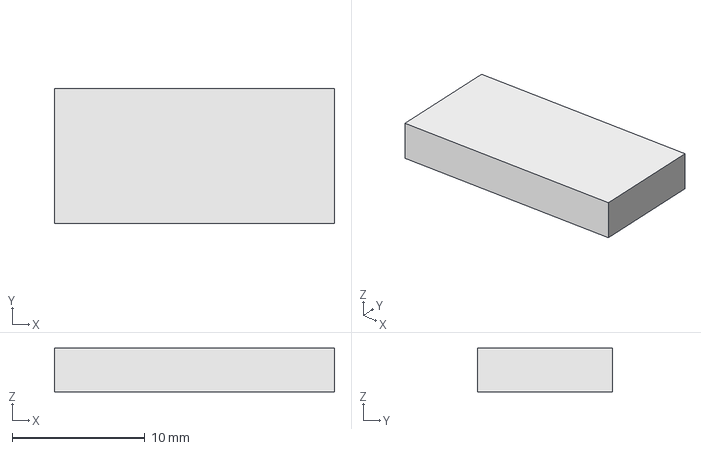
[picture p63: CAD file, 2019-11-05]
3d/Housing_SO/CPC1907B.step
21.1 x 10.2 x 3.30 mm
