Tinkerforge/kicad-libraries/3d/Housing_SOT_SOD/SOT-23.step

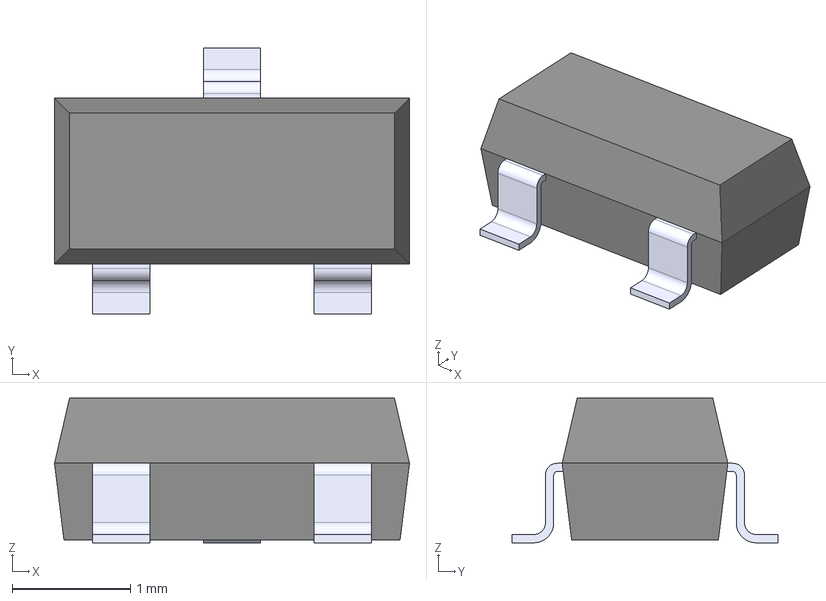
[picture p64: CAD file, 2017-04-19]
3d/Housing_SOT_SOD/SOT-23.step
3.00 x 2.25 x 1.22 mm
