Tinkerforge/kicad-libraries/3d/Housing_special/PEM1S.step

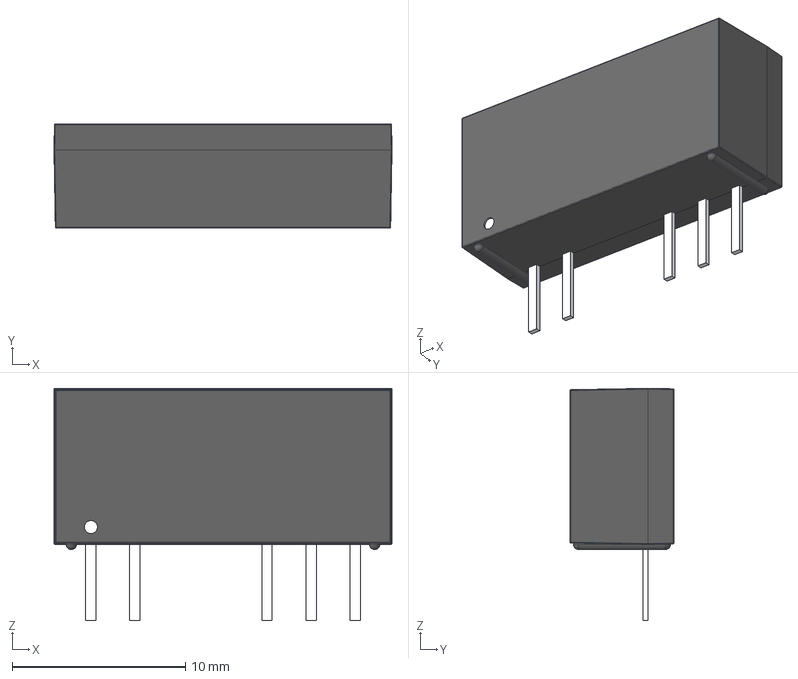
[picture p65: CAD file, 2020-04-03]
3d/Housing_special/PEM1S.step
19.5 x 6.00 x 13.4 mm
