Tinkerforge/kicad-libraries/3d/Housing_SSOP/VSSOP-10.step

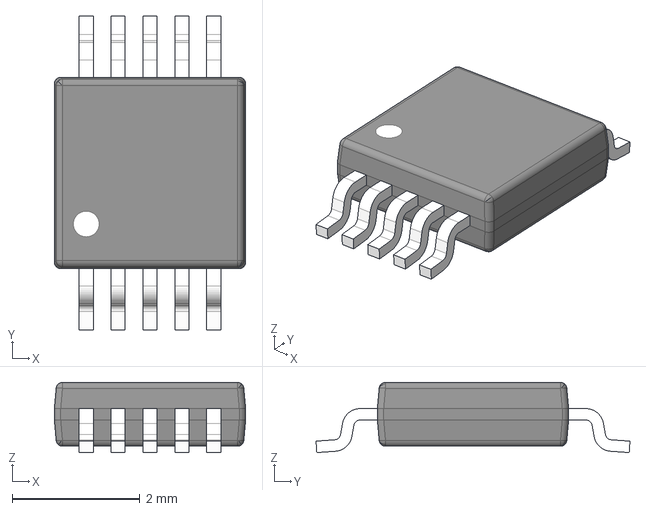
[picture p66: CAD file, 2018-05-28]
3d/Housing_SSOP/VSSOP-10.step
3.00 x 4.93 x 1.10 mm
