Tinkerforge/kicad-libraries/3d/Housings_DFN_QFN/XMC 1300.step

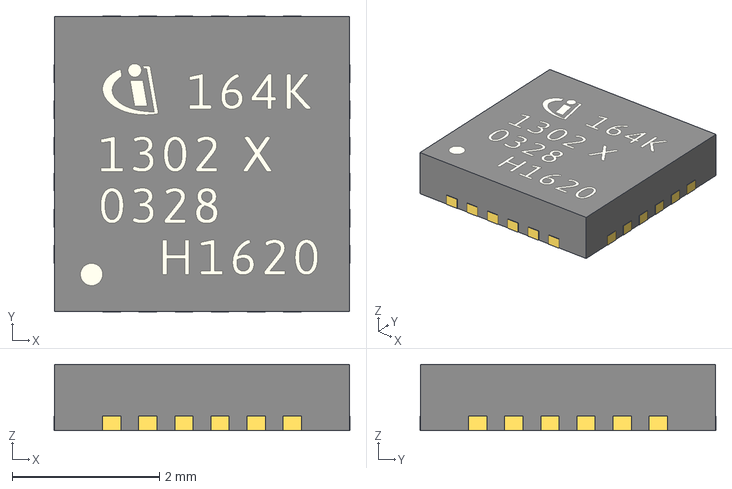
[picture p67: CAD file, 2019-05-13]
3d/Housings_DFN_QFN/XMC 1300.step
4.02 x 4.02 x 0.901 mm
