Tinkerforge/kicad-libraries/3d/Housings_DIP/DIP-16_SMD.step

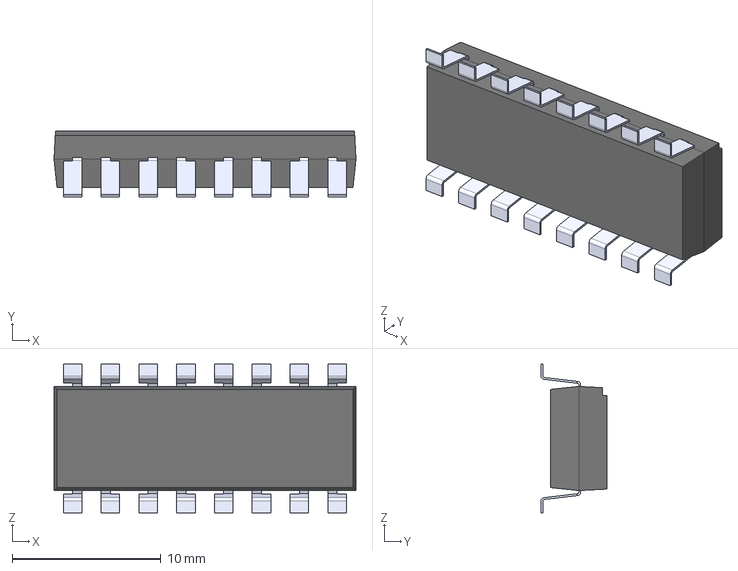
[picture p68: CAD file, 2017-07-28]
3d/Housings_DIP/DIP-16_SMD.step
20.3 x 4.45 x 10.0 mm
