Tinkerforge/kicad-libraries/3d/Housings_DO/DO-214AC.step

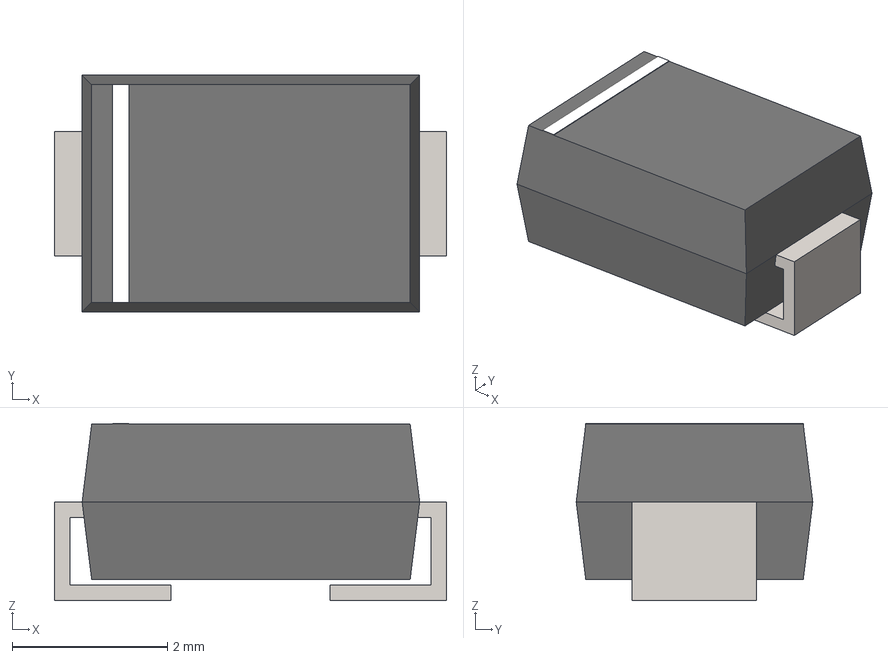
[picture p69: CAD file, 2017-05-05]
3d/Housings_DO/DO-214AC.step
5.05 x 3.05 x 2.28 mm
