Tinkerforge/kicad-libraries/3d/Housings_LGA/NRF9160-SIBA-R.FCStd

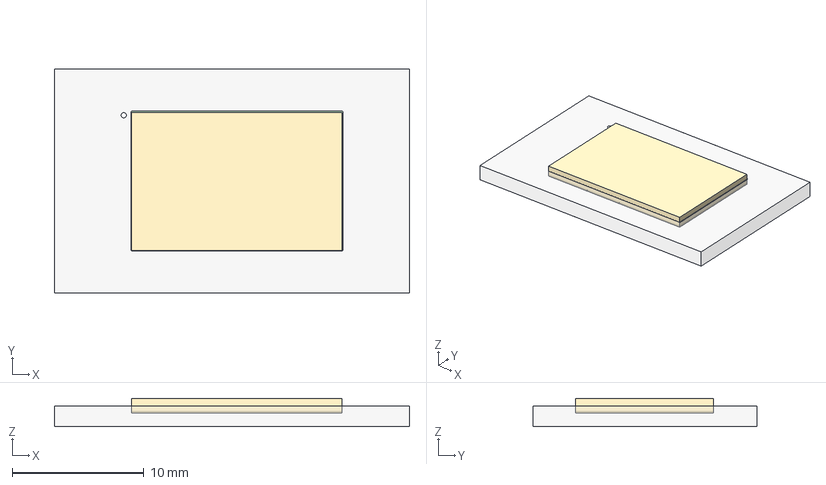
[picture p70: CAD file, 2019-08-30]
3d/Housings_LGA/NRF9160-SIBA-R.FCStd
27.0 x 17.0 x 2.14 mm
FFab
FrontSilk
TopPads
Pcb
NRF9160-SIBA-R
