Tinkerforge/kicad-libraries/3d/Housings_QFP/LQFP-32_7x7mm_Pitch0.8mm.step

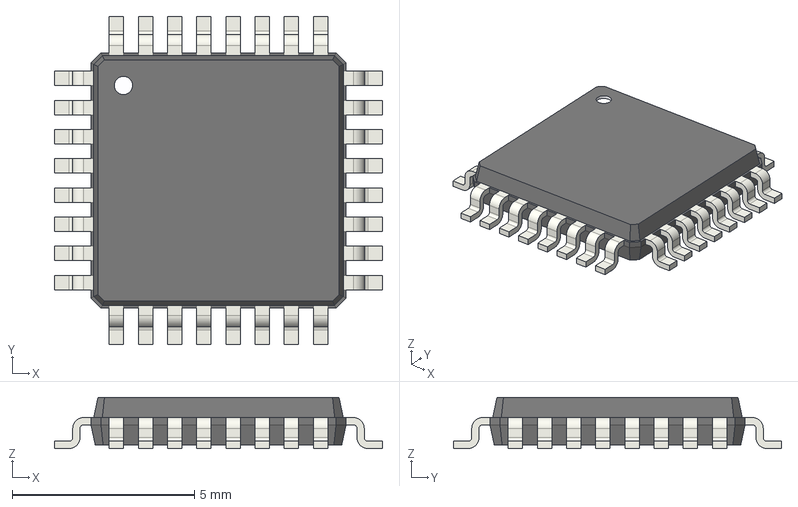
[picture p71: CAD file, 2017-03-24]
3d/Housings_QFP/LQFP-32_7x7mm_Pitch0.8mm.step
9.00 x 9.00 x 1.40 mm
