Tinkerforge/kicad-libraries/3d/Housings_SC/SC-70.step

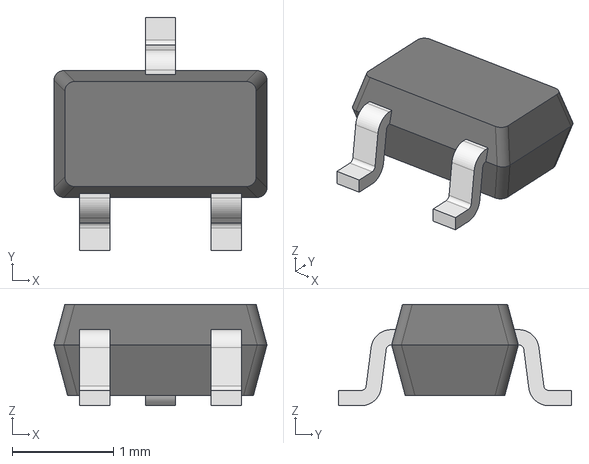
[picture p72: CAD file, 2017-10-23]
3d/Housings_SC/SC-70.step
2.10 x 2.30 x 1.00 mm
