Tinkerforge/kicad-libraries/3d/Housings_SOIC/SOIC-14_3.9x8.7mm_Pitch1.27mm.step

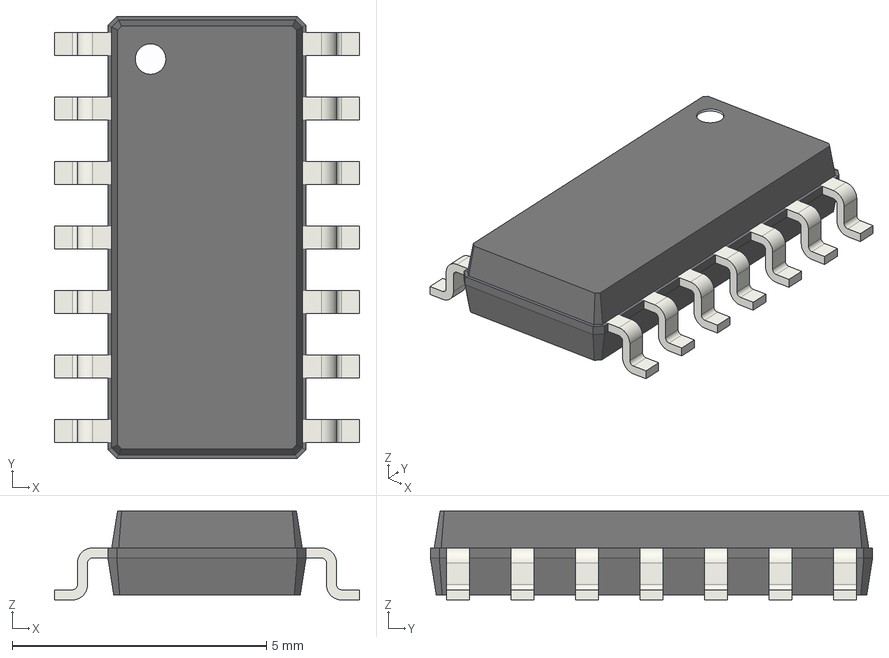
[picture p73: CAD file, 2017-03-24]
3d/Housings_SOIC/SOIC-14_3.9x8.7mm_Pitch1.27mm.step
6.00 x 8.70 x 1.75 mm
