Tinkerforge/kicad-libraries/3d/Inductors/WE-6065.step

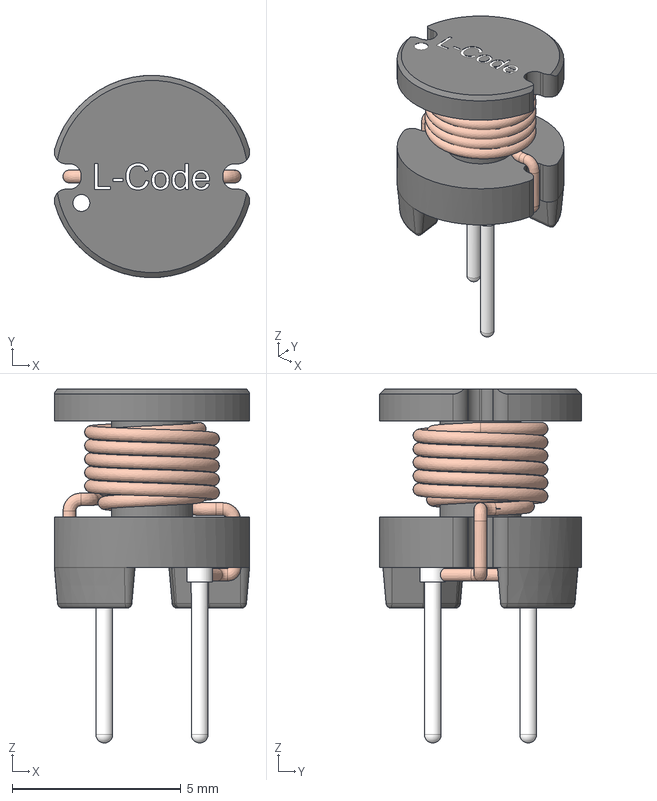
[picture p74: CAD file, 2023-10-27]
3d/Inductors/WE-6065.step
5.80 x 6.00 x 10.5 mm
