Tinkerforge/kicad-libraries/3d/LED_SMD/LED_RGB_LP.step

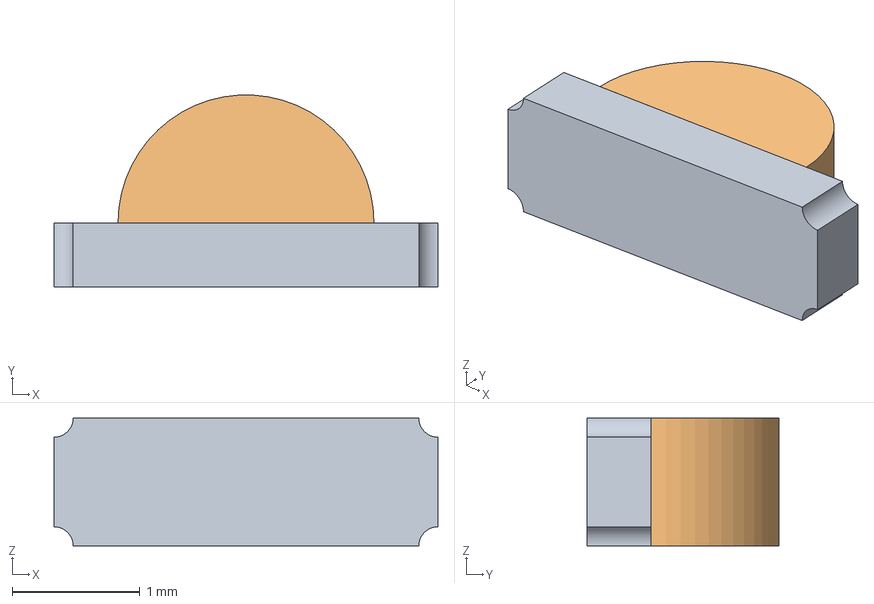
[picture p75: CAD file, 2019-12-23]
3d/LED_SMD/LED_RGB_LP.step
3.00 x 1.50 x 1.00 mm
