Tinkerforge/kicad-libraries/3d/Oscillators_SMD/HC49_US.step

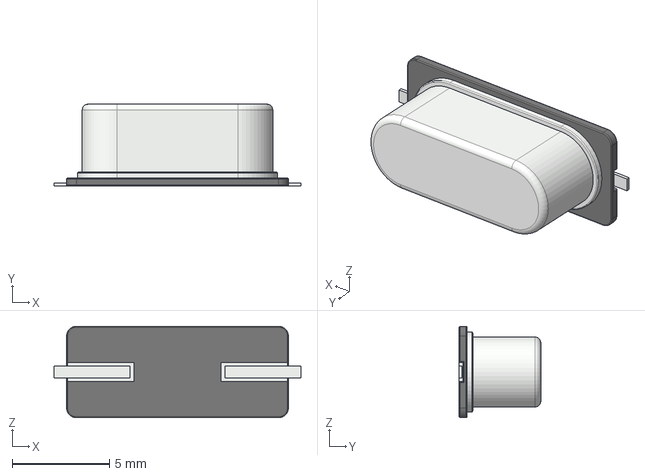
[picture p76: CAD file, 2017-07-31]
3d/Oscillators_SMD/HC49_US.step
12.7 x 4.20 x 4.70 mm
