Tinkerforge/kicad-libraries/3d/Potentiometers/cap_rotary_encoder.step

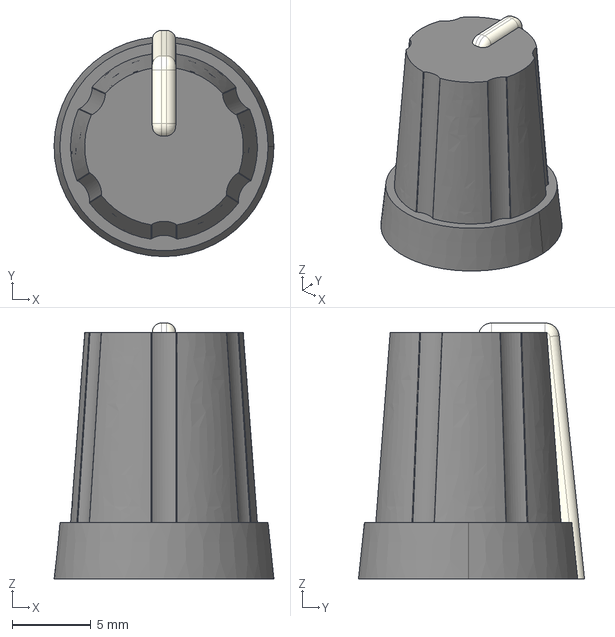
[picture p77: CAD file, 2018-07-06]
3d/Potentiometers/cap_rotary_encoder.step
14.0 x 14.4 x 16.3 mm
