Tinkerforge/kicad-libraries/3d/Resistors_SMD/R_4x0402.step

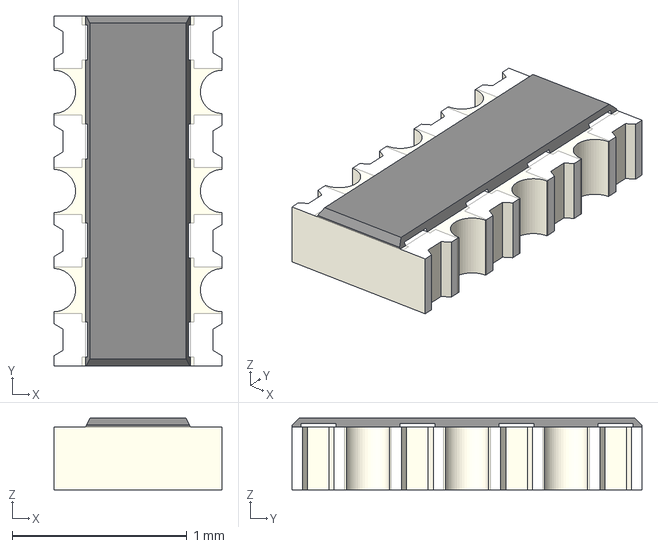
[picture p78: CAD file, 2017-06-16]
3d/Resistors_SMD/R_4x0402.step
0.96 x 2.00 x 0.41 mm
