Tinkerforge/kicad-libraries/3d/Sensors_Detectors/VL53L1.step

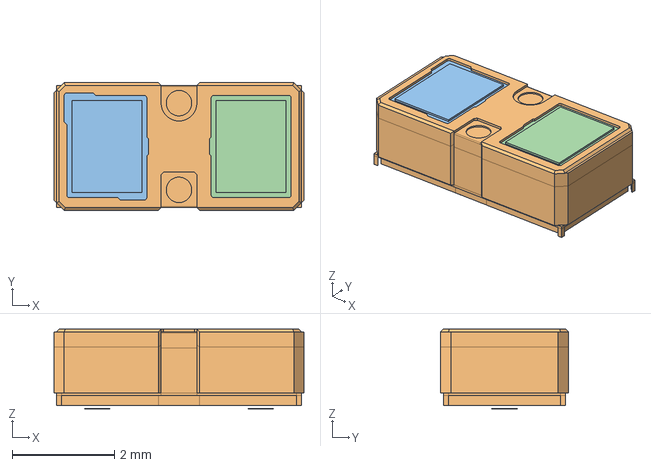
[picture p79: CAD file, 2020-06-22]
3d/Sensors_Detectors/VL53L1.step
4.90 x 2.50 x 1.56 mm
