Tinkerforge/kicad-libraries/3d/unsorted/DSK.step

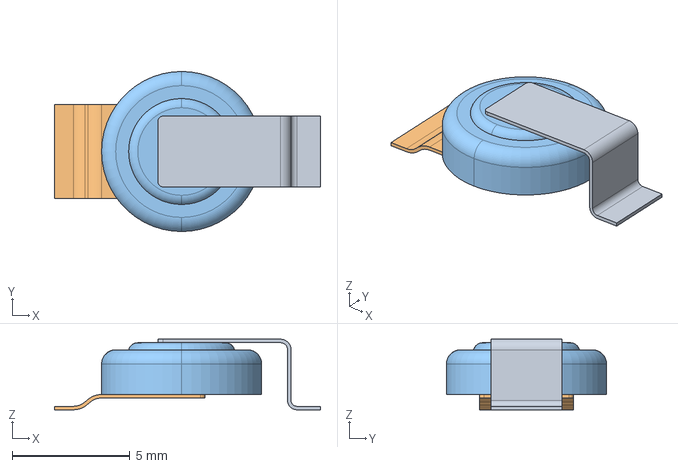
[picture p80: CAD file, 2026-03-05]
3d/unsorted/DSK.step
11.3 x 6.80 x 3.00 mm
