Tinkerforge/kicad-libraries/3d/Buttons_Switches/CS_4_22YA.step

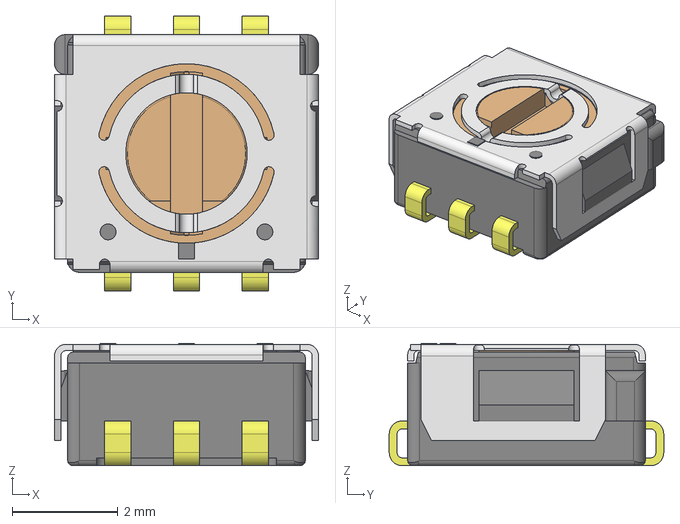
[picture p81: CAD file, 2021-01-07]
3d/Buttons_Switches/CS_4_22YA.step
5.00 x 5.20 x 2.32 mm
