Tinkerforge/kicad-libraries/3d/Capacitors_SMD/ELKO 220.fcstd

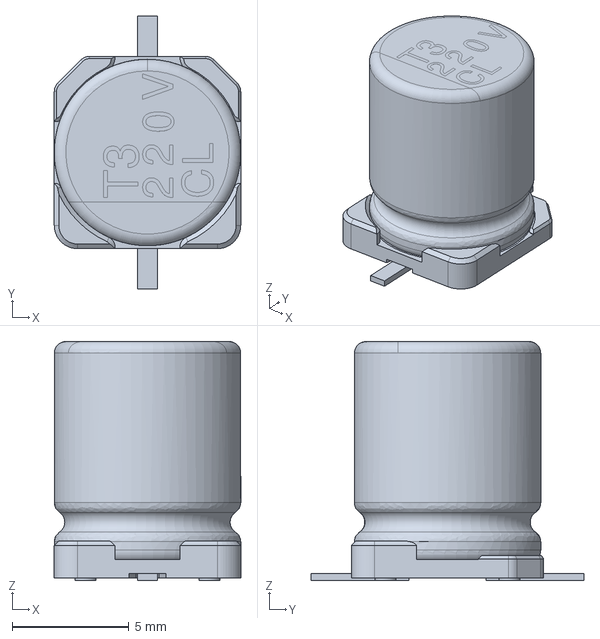
[picture p82: CAD file, 2017-07-11]
3d/Capacitors_SMD/ELKO 220.fcstd
8.00 x 11.7 x 10.3 mm
