Tinkerforge/kicad-libraries/3d/Capacitors_Tantalum_SMD/Tantalum_Case-A_EIA-3216-18.step

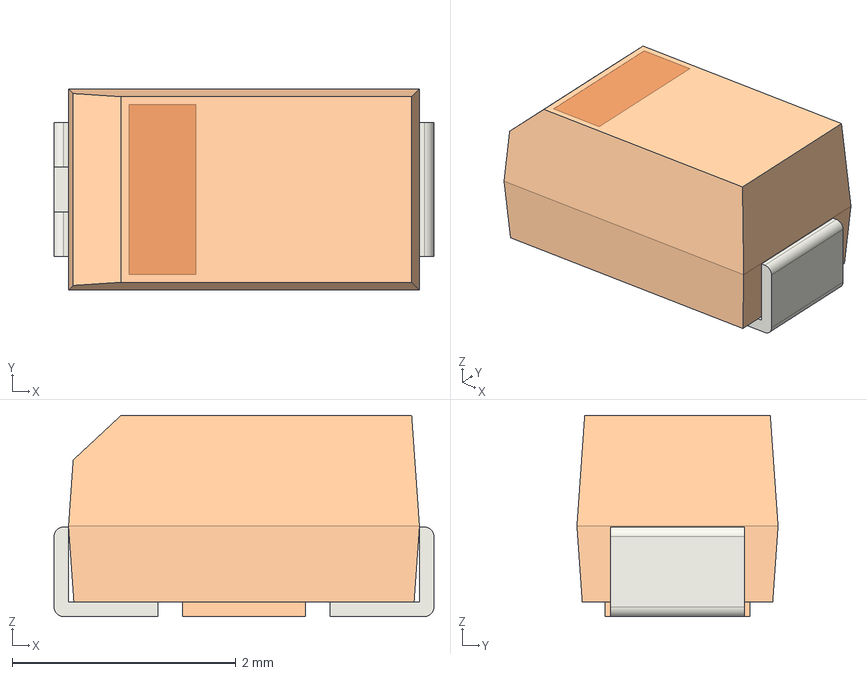
[picture p83: CAD file, 2017-03-24]
3d/Capacitors_Tantalum_SMD/Tantalum_Case-A_EIA-3216-18.step
3.40 x 1.80 x 1.80 mm
