Tinkerforge/kicad-libraries/3d/Capacitors_wired/WE-WCAP-WTX2-P15.FCStd

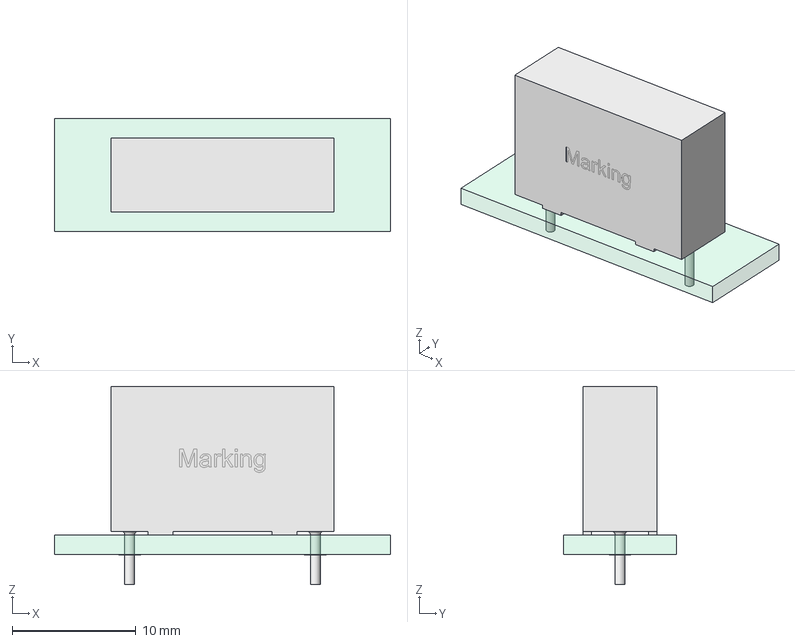
[picture p84: CAD file, 2023-12-01]
3d/Capacitors_wired/WE-WCAP-WTX2-P15.FCStd
27.2 x 9.15 x 16.0 mm
topPads
btmPads
TH-Drills
PCB
WE-WCAP-WTX2-P15-1
