Tinkerforge/kicad-libraries/3d/Connectors_TF/btb_btm.step

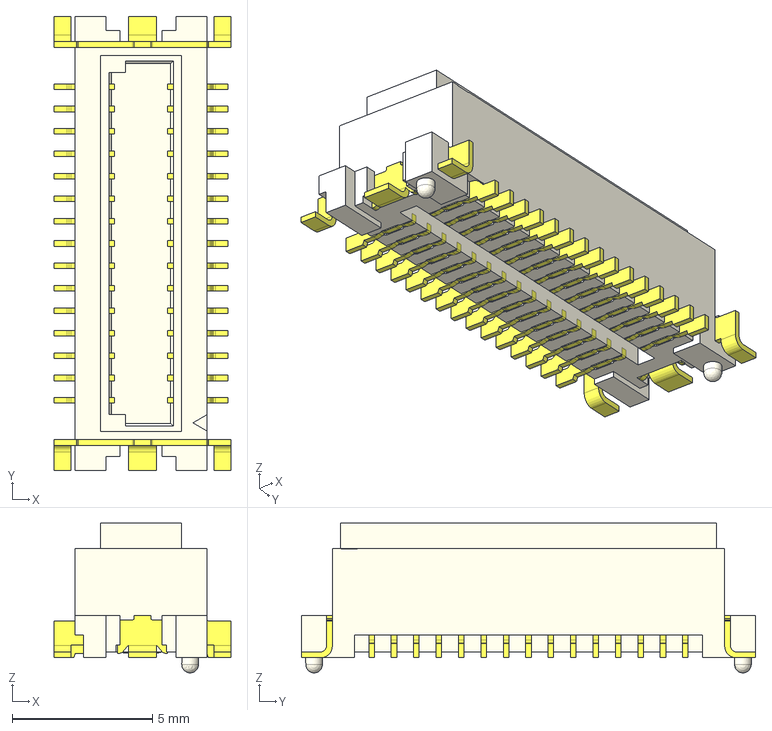
[picture p85: CAD file, 2019-04-24]
3d/Connectors_TF/btb_btm.step
6.30 x 16.2 x 5.35 mm
