Tinkerforge/kicad-libraries/3d/Fuses/OMNI-BLOK.step

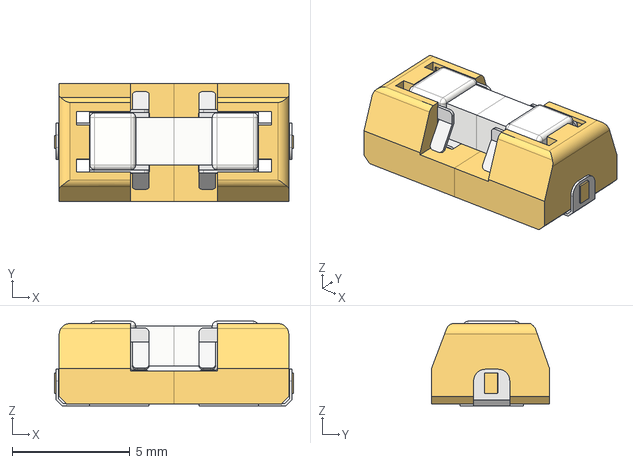
[picture p86: CAD file, 2020-07-30]
3d/Fuses/OMNI-BLOK.step
10.1 x 5.00 x 3.59 mm
