Tinkerforge/kicad-libraries/3d/Housing_SO/SO-16.step

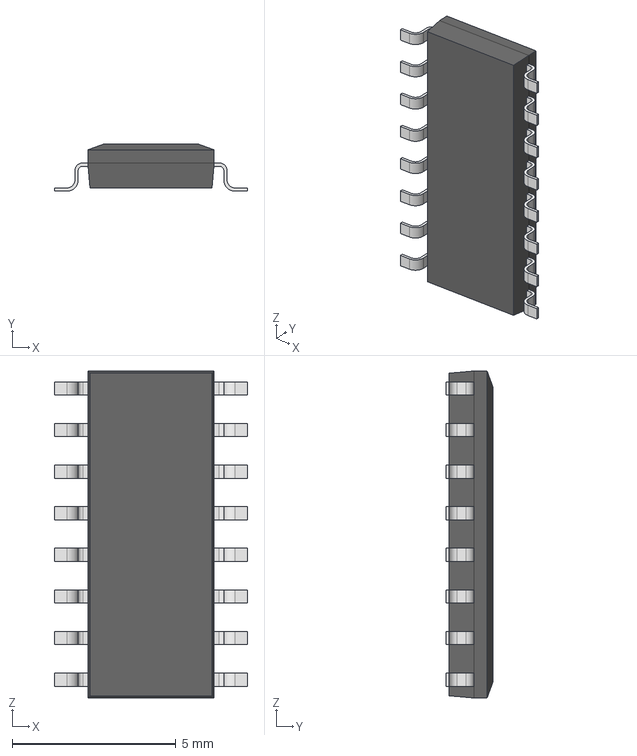
[picture p87: CAD file, 2018-05-28]
3d/Housing_SO/SO-16.step
5.91 x 1.45 x 9.98 mm
