Tinkerforge/kicad-libraries/3d/Housing_SOT_SOD/SOT-23-6.step

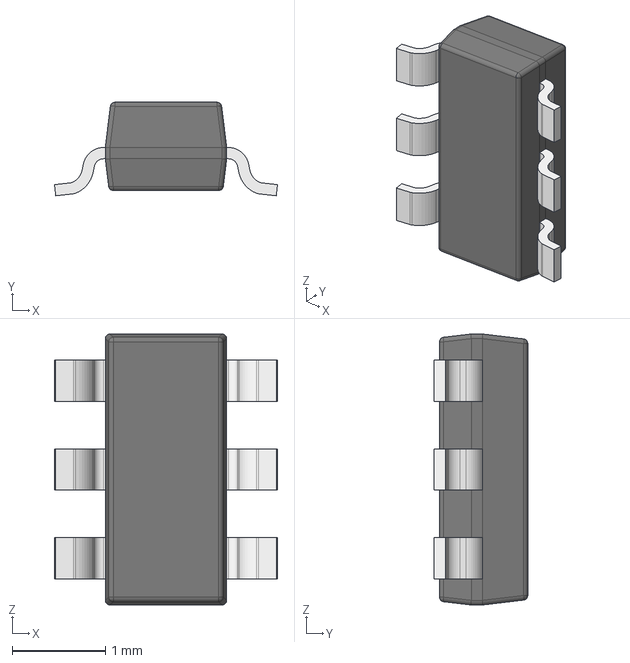
[picture p88: CAD file, 2017-04-19]
3d/Housing_SOT_SOD/SOT-23-6.step
2.39 x 1.00 x 2.90 mm
