Tinkerforge/kicad-libraries/3d/Housing_special/Atmel_ATSAM34C.fcstd

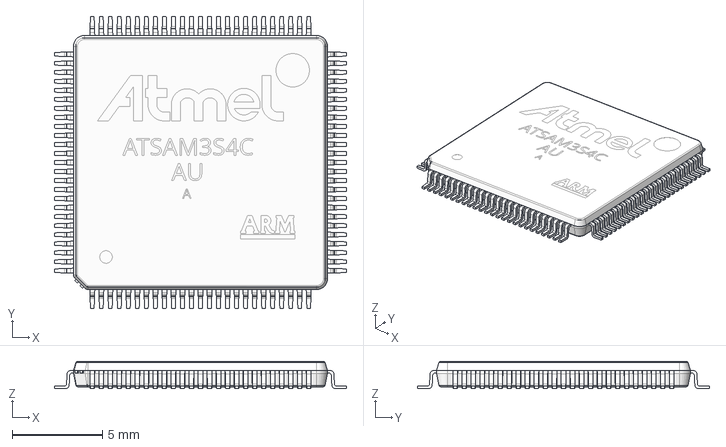
[picture p89: CAD file, 2017-08-02]
3d/Housing_special/Atmel_ATSAM34C.fcstd
16.1 x 16.1 x 1.50 mm
