Tinkerforge/kicad-libraries/3d/Housing_SSOP/SOP-20.step

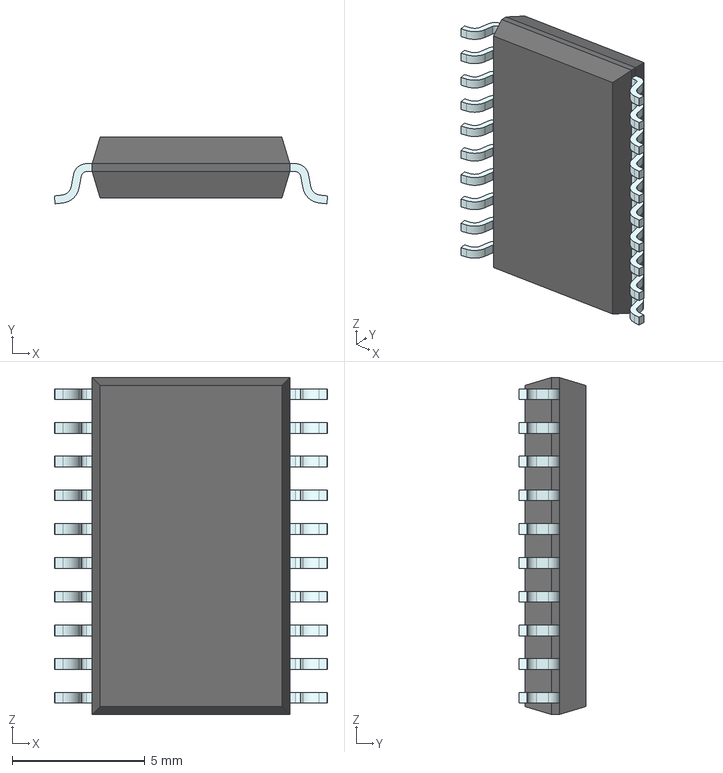
[picture p90: CAD file, 2017-11-06]
3d/Housing_SSOP/SOP-20.step
10.3 x 2.52 x 12.7 mm
