Tinkerforge/kicad-libraries/3d/Housings_LGA/LGA-12_2x2mm.step

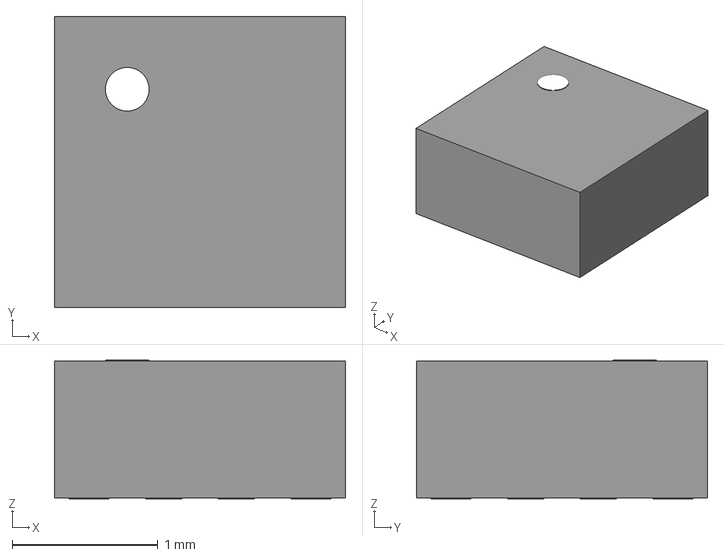
[picture p91: CAD file, 2018-06-25]
3d/Housings_LGA/LGA-12_2x2mm.step
2.00 x 2.00 x 0.955 mm
