Tinkerforge/kicad-libraries/3d/Housings_SC/SC-59.step

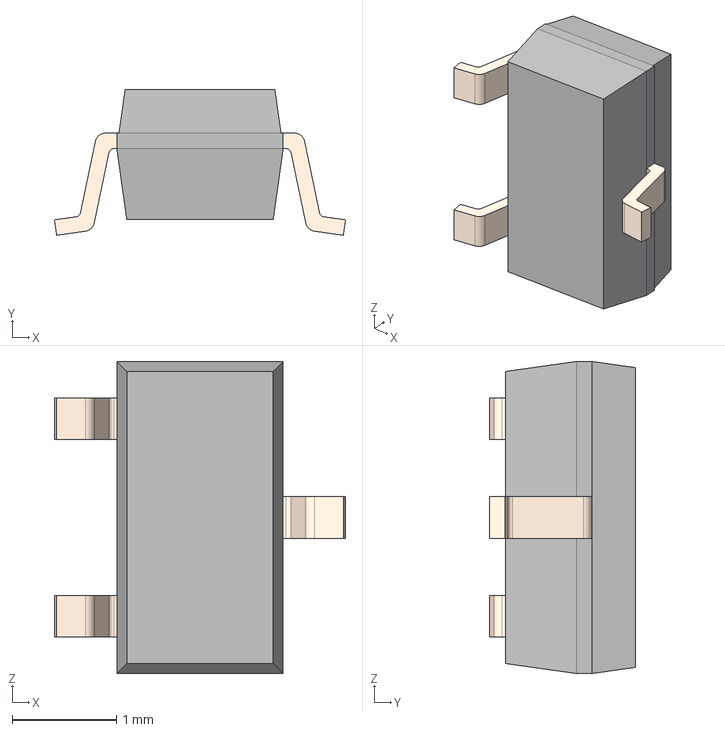
[picture p92: CAD file, 2017-08-01]
3d/Housings_SC/SC-59.step
2.80 x 1.40 x 3.00 mm
