Tinkerforge/kicad-libraries/3d/Housings_SOIC/SOIC-8_3.9x4.9mm_Pitch1.27mm.step

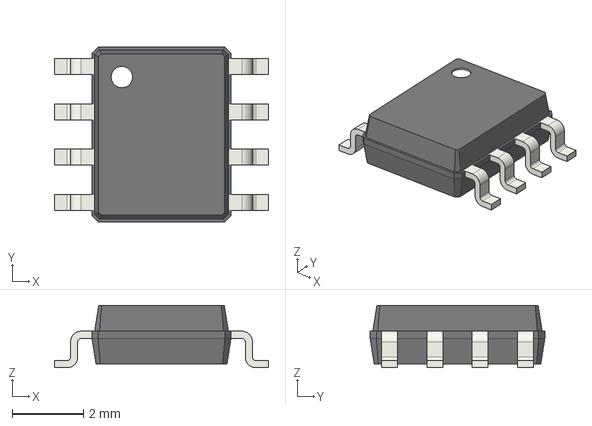
[picture p93: CAD file, 2017-03-24]
3d/Housings_SOIC/SOIC-8_3.9x4.9mm_Pitch1.27mm.step
6.00 x 4.90 x 1.75 mm
