Tinkerforge/kicad-libraries/3d/Oscillators_SMD/3225.step

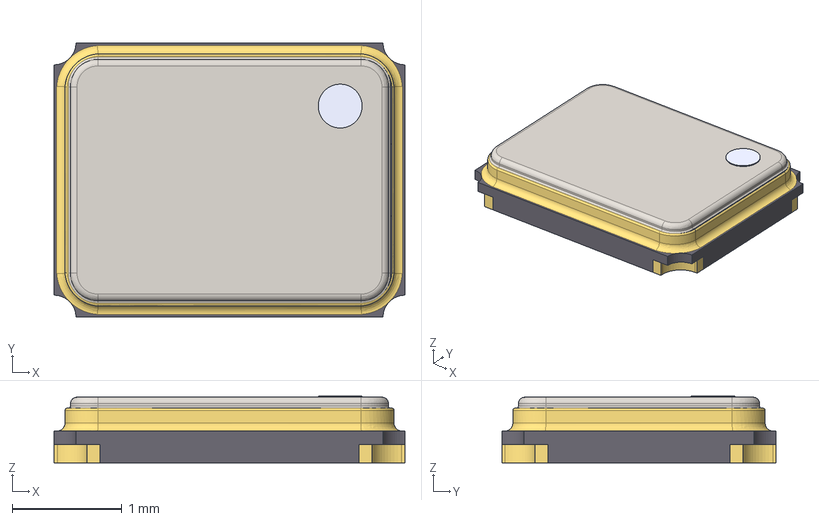
[picture p94: CAD file, 2017-03-24]
3d/Oscillators_SMD/3225.step
3.20 x 2.50 x 0.61 mm
