Tinkerforge/kicad-libraries/3d/Pin_Header/Pin_Header_Angled_2x6.step

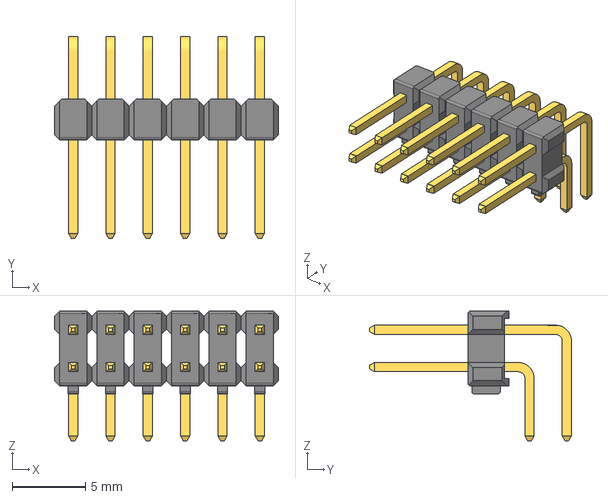
[picture p95: CAD file, 2018-07-06]
3d/Pin_Header/Pin_Header_Angled_2x6.step
15.2 x 13.7 x 8.83 mm
