Tinkerforge/kicad-libraries/3d/Potentiometers/RSA0N11M9A0J.step

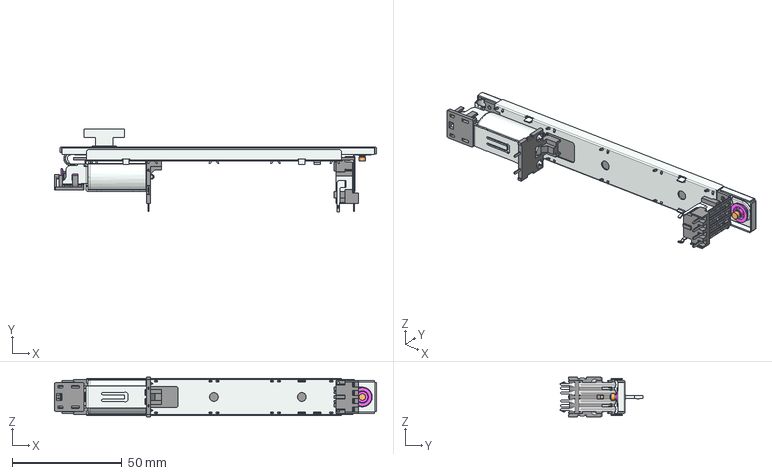
[picture p96: CAD file, 2017-11-15]
3d/Potentiometers/RSA0N11M9A0J.step
146.6 x 38.0 x 18.0 mm
