Tinkerforge/kicad-libraries/3d/Resistors_SMD/R_2512.step

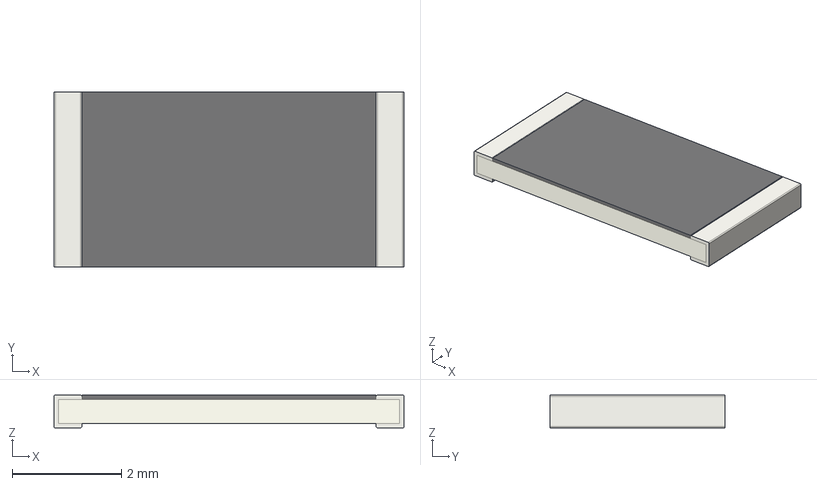
[picture p97: CAD file, 2017-03-24]
3d/Resistors_SMD/R_2512.step
6.40 x 3.20 x 0.6 mm
