Tinkerforge/kicad-libraries/3d/Sensors_Detectors/DLC-L05D-D4.step

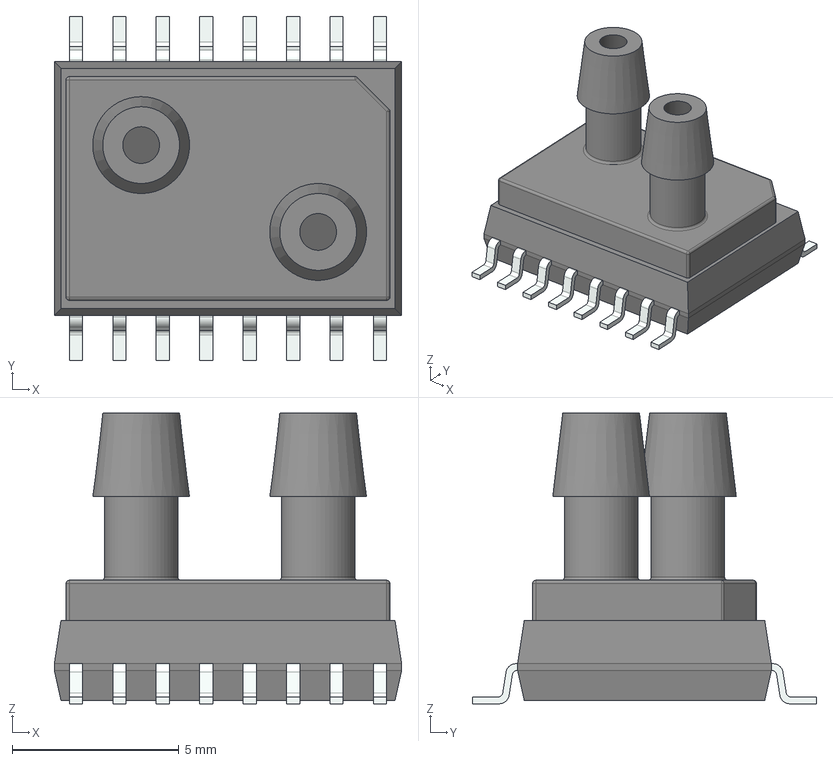
[picture p98: CAD file, 2020-01-29]
3d/Sensors_Detectors/DLC-L05D-D4.step
10.4 x 10.3 x 8.70 mm
