Tinkerforge/kicad-libraries/3d/unsorted/2036-XX-SM.step

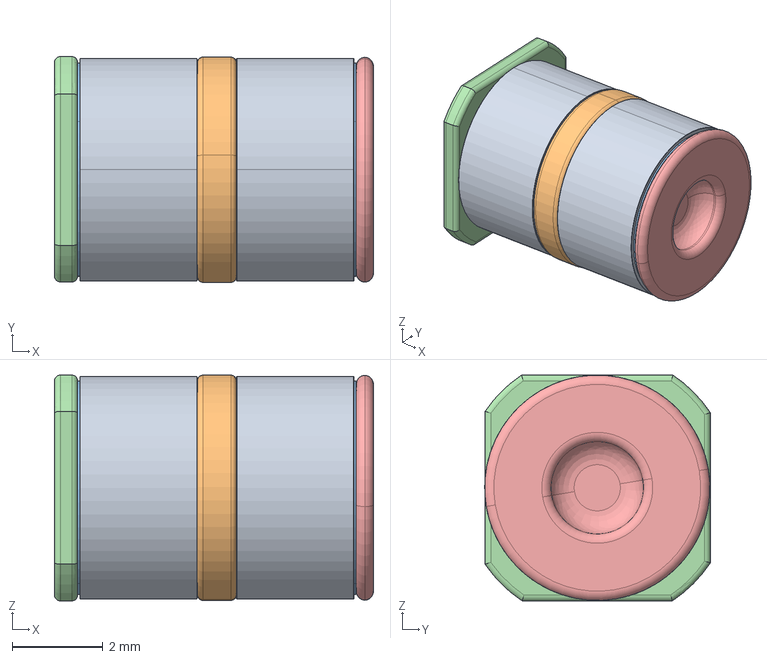
[picture p99: CAD file, 2025-04-14]
3d/unsorted/2036-XX-SM.step
7.01 x 4.96 x 4.96 mm
