Tinkerforge/kicad-libraries/3d/Capacitors_SMD/c_elec_4x5.3.step

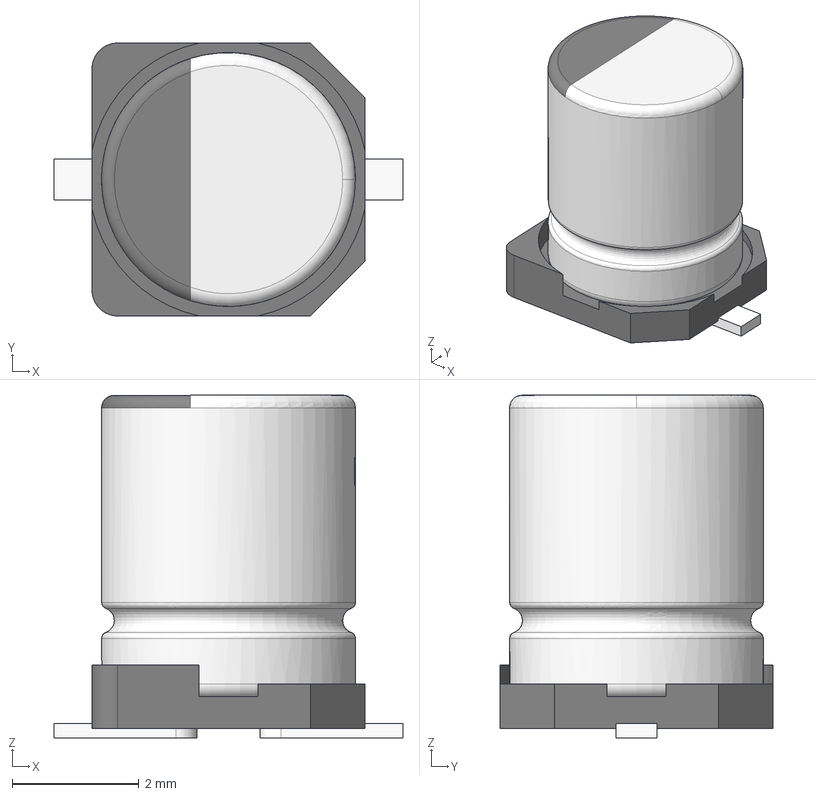
[picture p100: CAD file, 2017-04-28]
3d/Capacitors_SMD/c_elec_4x5.3.step
5.50 x 4.30 x 5.40 mm
