Tinkerforge/kicad-libraries/3d/Capacitors_Tantalum_SMD/Tantalum_Case-C_EIA-6032-28.step

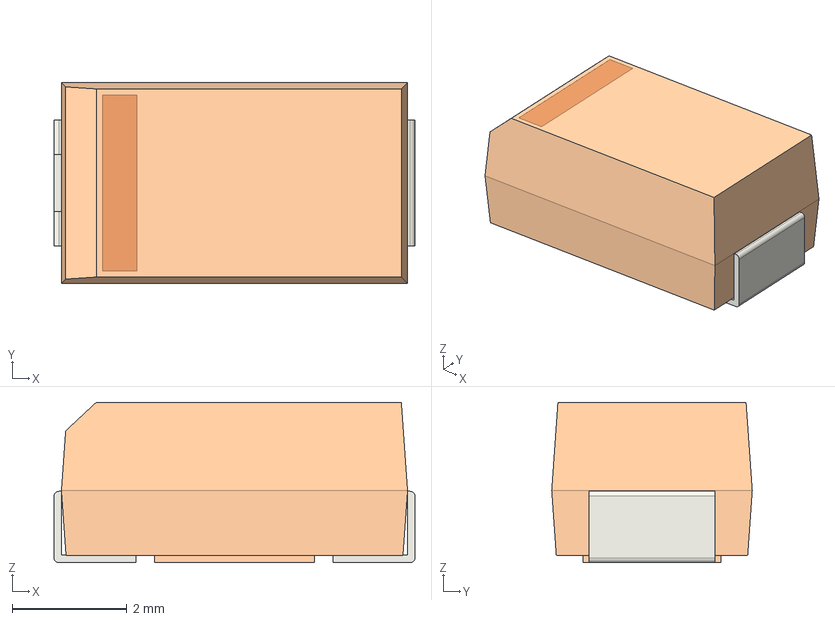
[picture p101: CAD file, 2017-03-24]
3d/Capacitors_Tantalum_SMD/Tantalum_Case-C_EIA-6032-28.step
6.30 x 3.50 x 2.80 mm
