Tinkerforge/kicad-libraries/3d/Capacitors_wired/c_elko_10x10.step

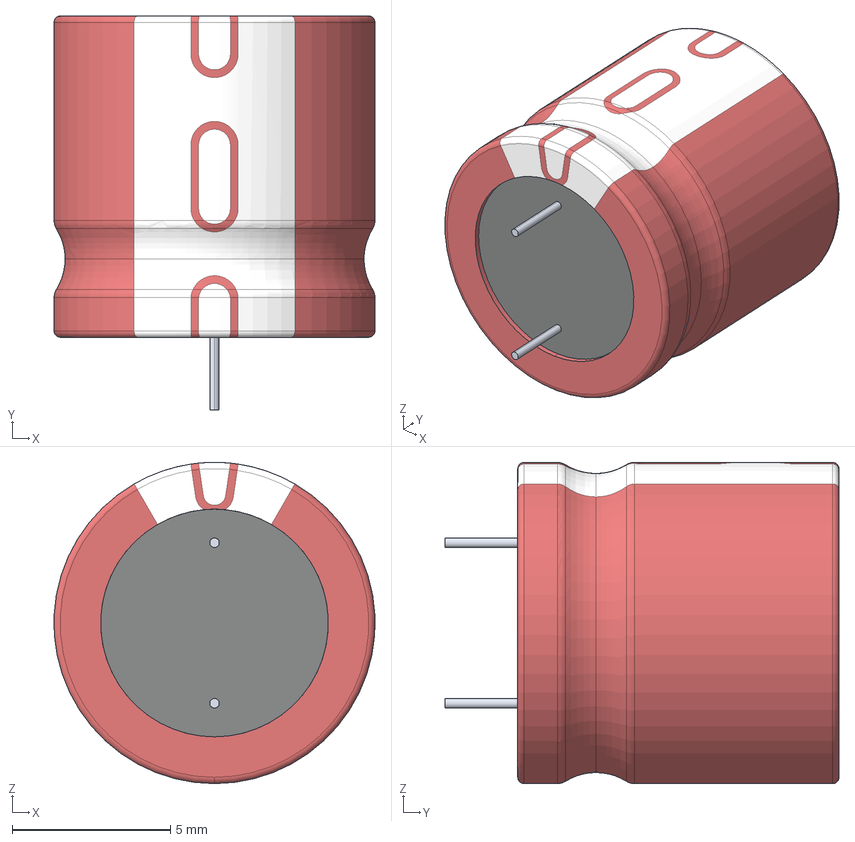
[picture p102: CAD file, 2018-05-28]
3d/Capacitors_wired/c_elko_10x10.step
10.1 x 12.5 x 10.2 mm
