Tinkerforge/kicad-libraries/3d/Connectors/OQ_2P_5mm_230V.step

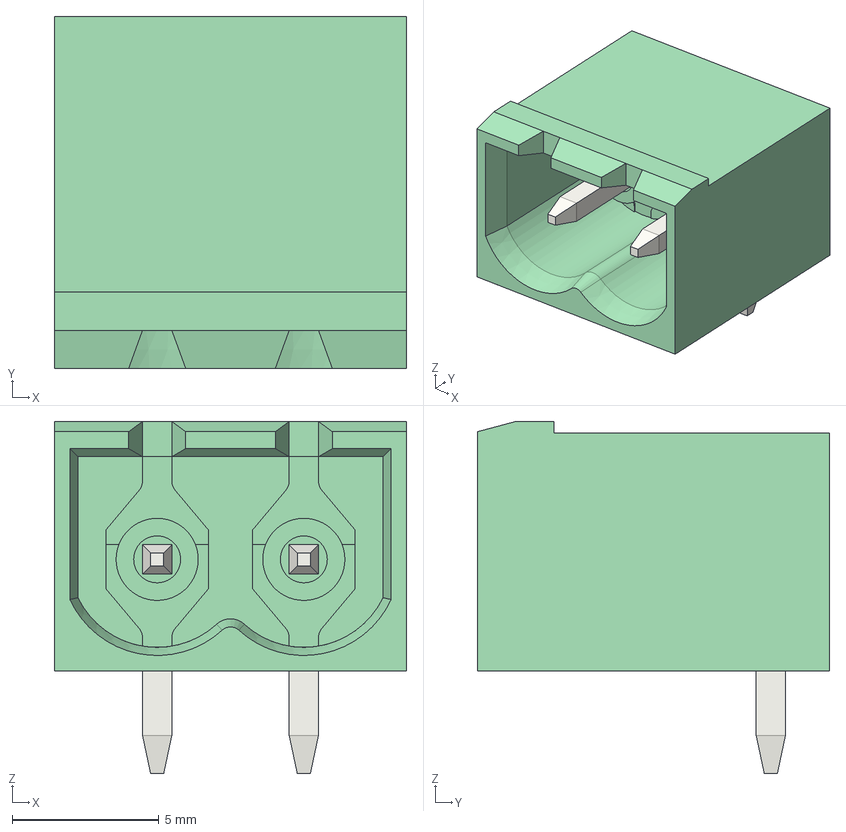
[picture p103: CAD file, 2024-06-24]
3d/Connectors/OQ_2P_5mm_230V.step
12.0 x 12.0 x 12.0 mm
