Tinkerforge/kicad-libraries/3d/Connectors_TF/btb_top.fcstd

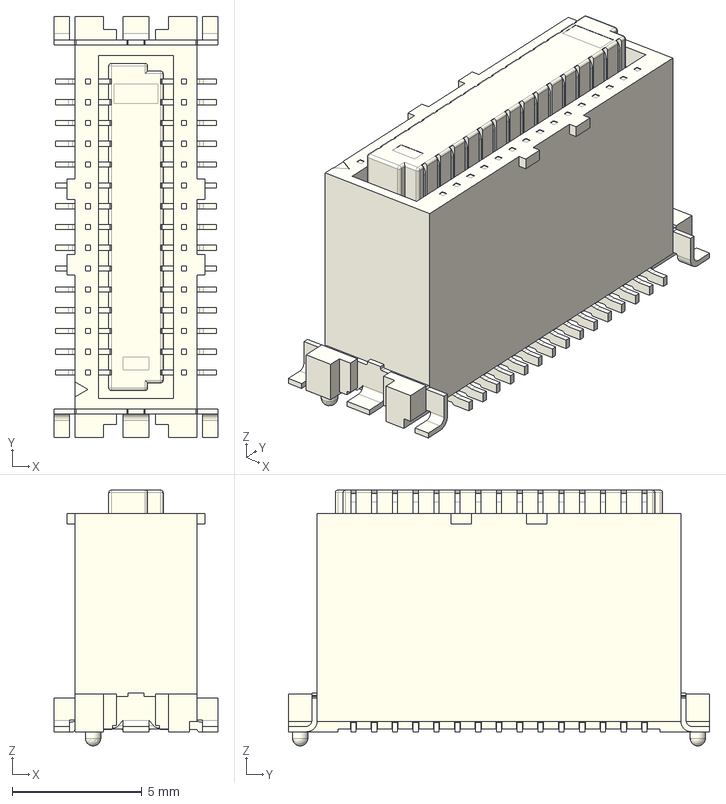
[picture p104: CAD file, 2018-07-20]
3d/Connectors_TF/btb_top.fcstd
6.30 x 16.2 x 9.85 mm
