Tinkerforge/kicad-libraries/3d/Fuses/2920-fuse.step

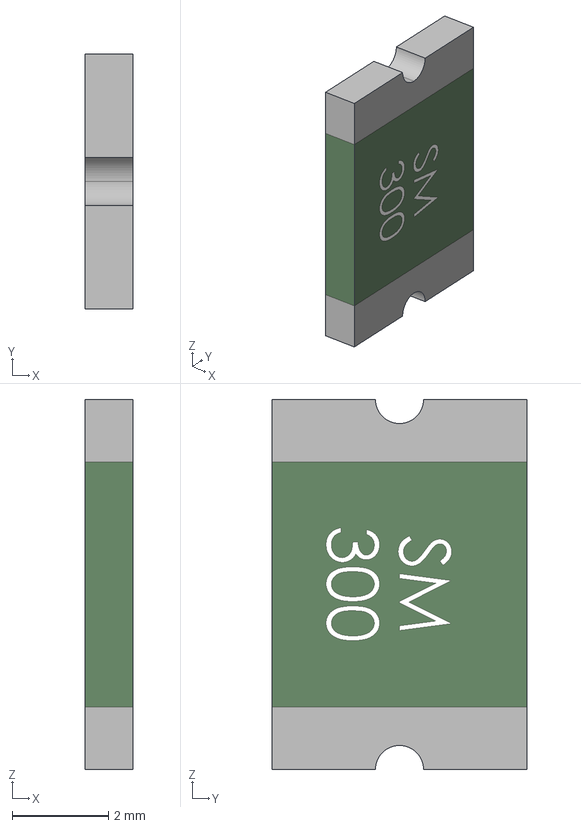
[picture p105: CAD file, 2018-05-28]
3d/Fuses/2920-fuse.step
1.00 x 5.30 x 7.70 mm
