Tinkerforge/kicad-libraries/3d/Housing_SO/SO-5.step

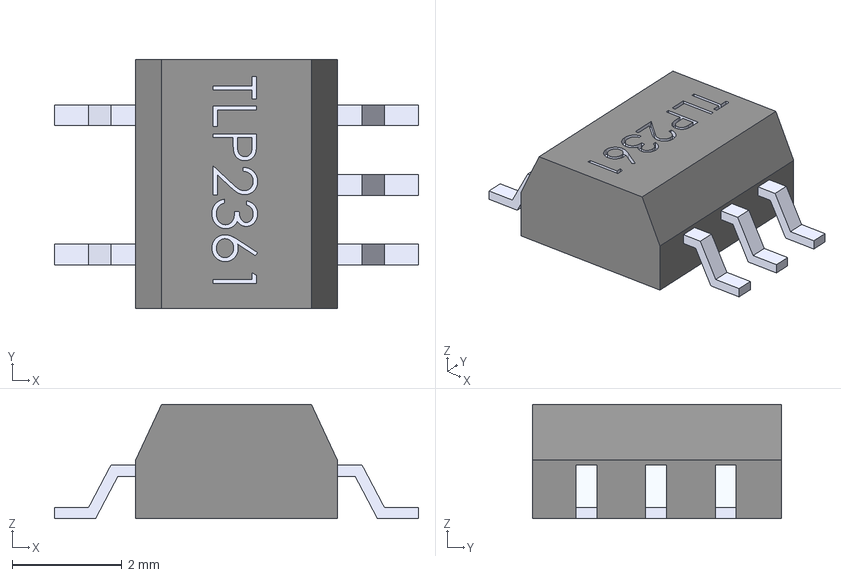
[picture p106: CAD file, 2018-04-16]
3d/Housing_SO/SO-5.step
6.64 x 4.55 x 2.08 mm
