Tinkerforge/kicad-libraries/3d/Housing_SOT_SOD/SOT-563.step

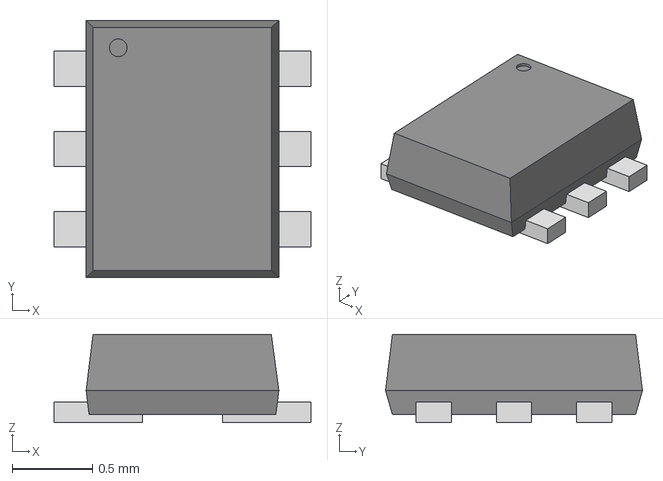
[picture p107: CAD file, 2017-03-24]
3d/Housing_SOT_SOD/SOT-563.step
1.60 x 1.60 x 0.55 mm
