Tinkerforge/kicad-libraries/3d/Housing_special/MiniMelf.step

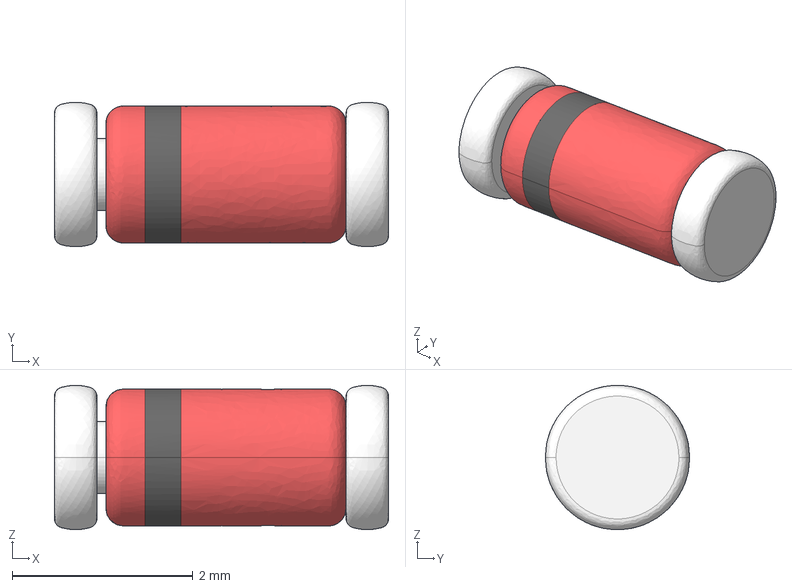
[picture p108: CAD file, 2017-03-24]
3d/Housing_special/MiniMelf.step
3.70 x 1.60 x 1.60 mm
