Tinkerforge/kicad-libraries/3d/Housing_SSOP/SSOP-4.step

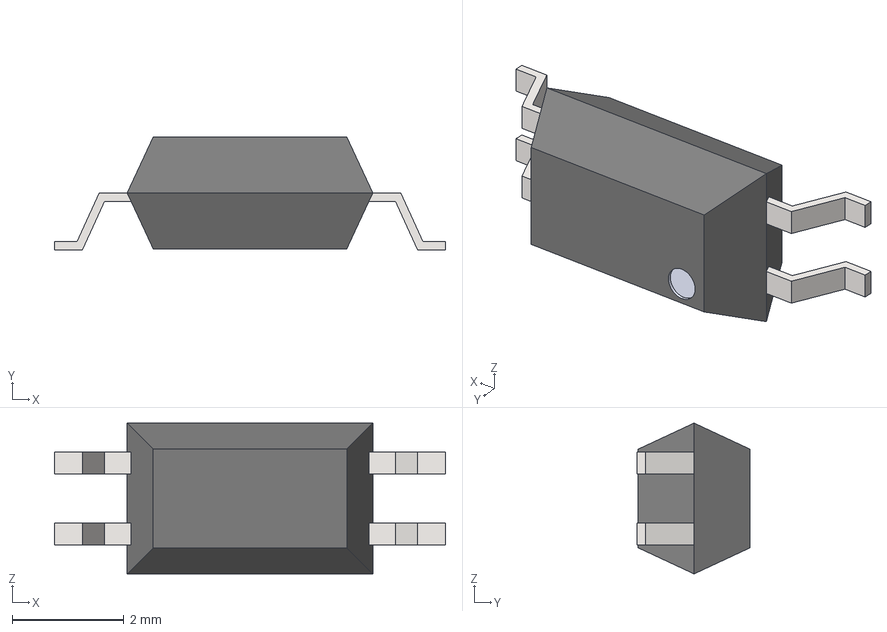
[picture p109: CAD file, 2017-07-31]
3d/Housing_SSOP/SSOP-4.step
7.00 x 2.02 x 2.70 mm
