Tinkerforge/kicad-libraries/3d/Housings_DFN_QFN/XMC 1400.step

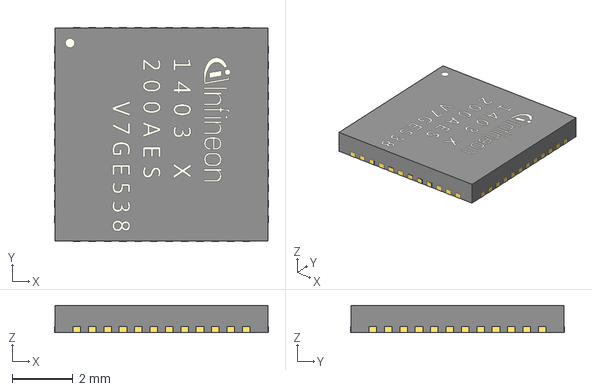
[picture p110: CAD file, 2019-05-13]
3d/Housings_DFN_QFN/XMC 1400.step
7.02 x 7.02 x 0.901 mm
