Tinkerforge/kicad-libraries/3d/Housings_LGA/LGA-16_3x3mm_Pitch0_5mm.step

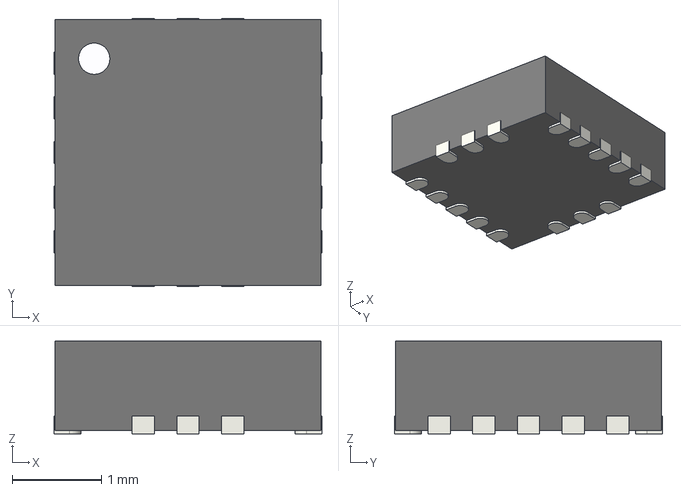
[picture p111: CAD file, 2017-04-21]
3d/Housings_LGA/LGA-16_3x3mm_Pitch0_5mm.step
3.00 x 3.00 x 1.04 mm
