Tinkerforge/kicad-libraries/3d/Housings_SOIC/SOIC-16_3.9x9.9mm_Pitch1.27mm.step

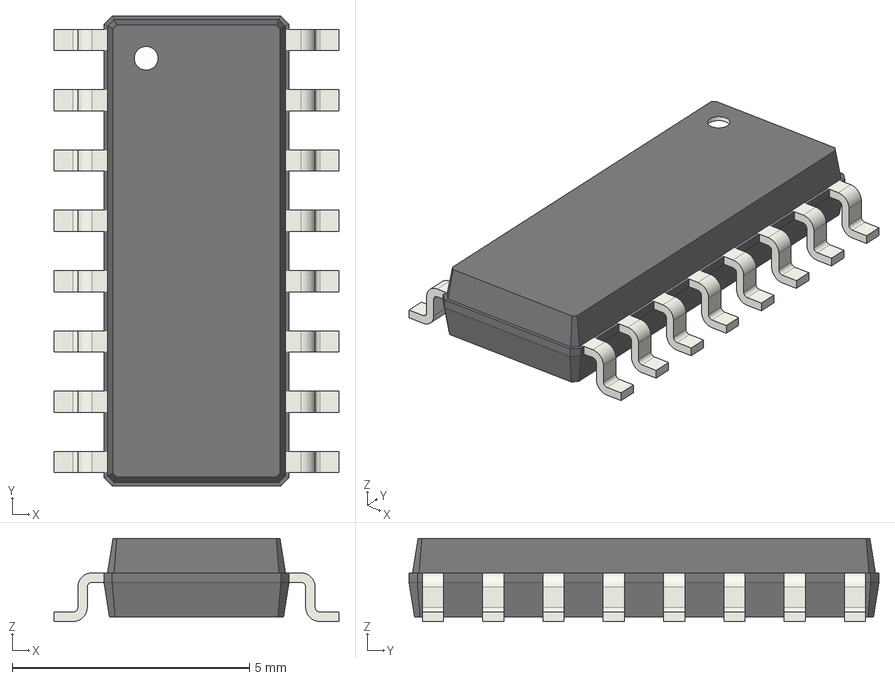
[picture p112: CAD file, 2017-03-24]
3d/Housings_SOIC/SOIC-16_3.9x9.9mm_Pitch1.27mm.step
6.00 x 9.90 x 1.75 mm
