Tinkerforge/kicad-libraries/3d/Inductors/WE-PBF.step

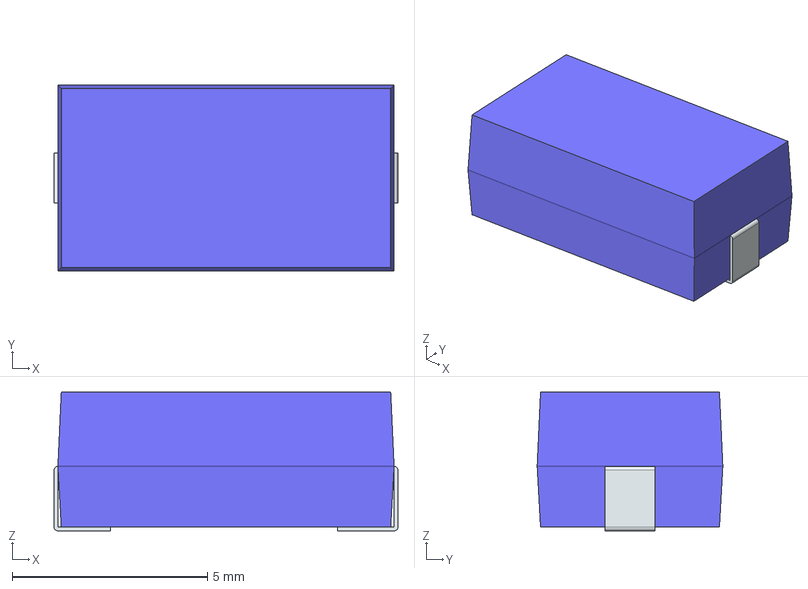
[picture p113: CAD file, 2023-02-17]
3d/Inductors/WE-PBF.step
8.80 x 4.75 x 3.55 mm
FilletPin1
FilletPin2
