Tinkerforge/kicad-libraries/3d/LED_SMD/WS2813B.step

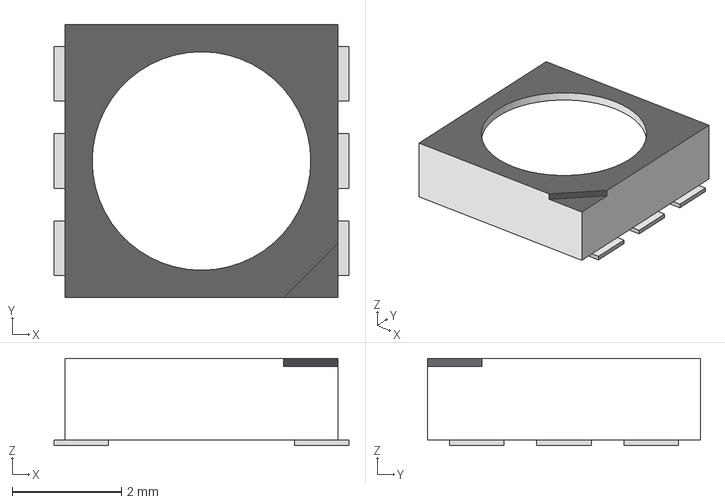
[picture p114: CAD file, 2019-02-05]
3d/LED_SMD/WS2813B.step
5.40 x 5.00 x 1.60 mm
