Tinkerforge/kicad-libraries/3d/Pin_Header/Pin_Header_Straight_Female_2x20_RaspPi.step

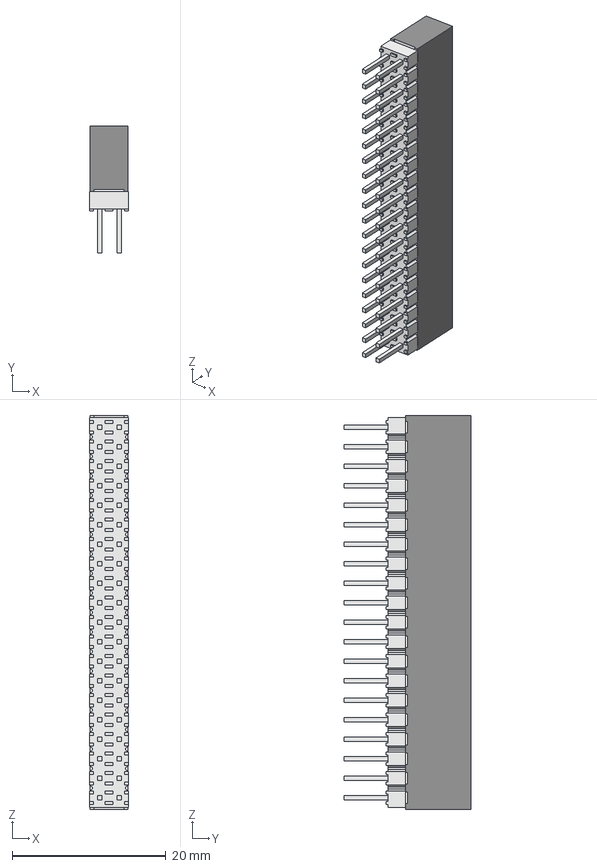
[picture p115: CAD file, 2018-04-24]
3d/Pin_Header/Pin_Header_Straight_Female_2x20_RaspPi.step
5.08 x 16.5 x 51.3 mm
