Tinkerforge/kicad-libraries/3d/Potentiometers/POT-3306W.step

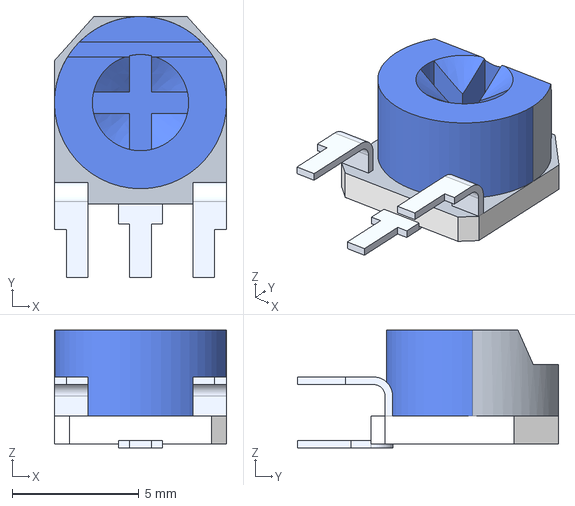
[picture p116: CAD file, 2017-11-02]
3d/Potentiometers/POT-3306W.step
6.81 x 10.3 x 4.65 mm
