Tinkerforge/kicad-libraries/3d/Resistors_SMD/R_1218.step

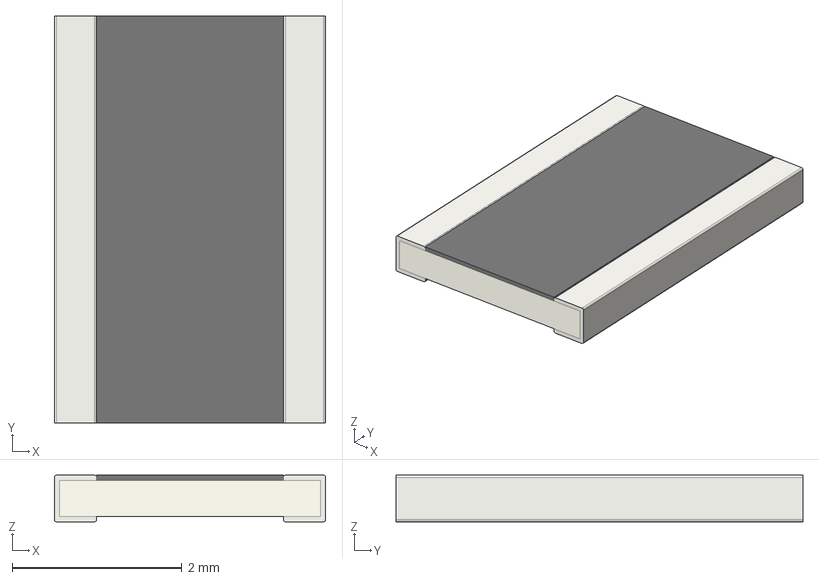
[picture p117: CAD file, 2017-03-24]
3d/Resistors_SMD/R_1218.step
3.20 x 4.80 x 0.55 mm
