Tinkerforge/kicad-libraries/3d/rotary_poti.step

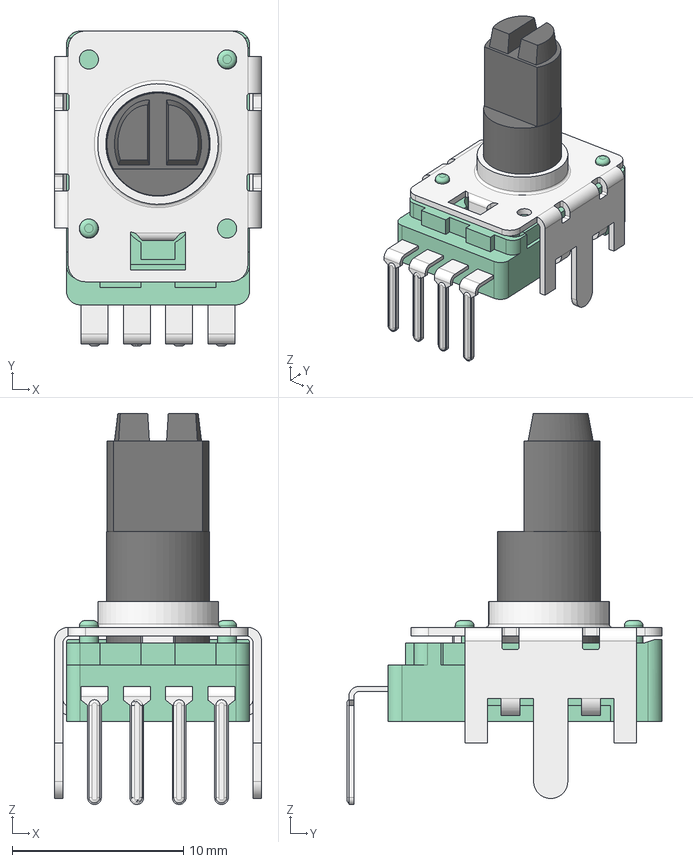
[picture p118: CAD file, 2019-08-15]
3d/rotary_poti.step
12.1 x 18.4 x 22.9 mm
