Tinkerforge/kicad-libraries/3d/Sensors_Detectors/SPH0644HM.step

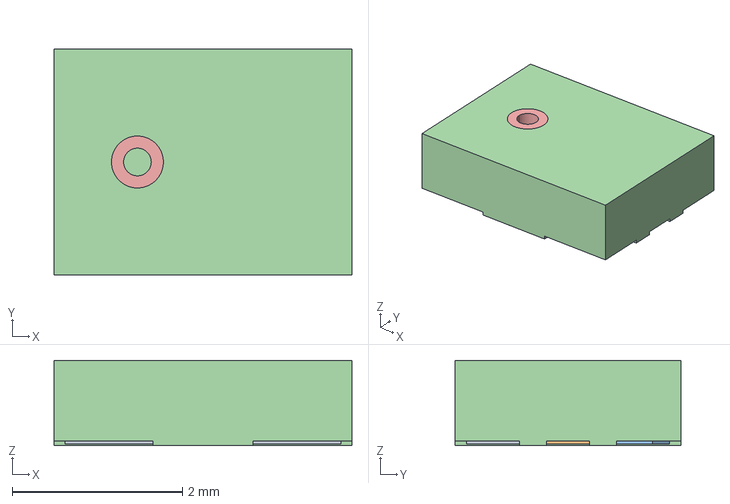
[picture p119: CAD file, 2020-01-23]
3d/Sensors_Detectors/SPH0644HM.step
3.50 x 2.65 x 1 mm
