Tinkerforge/kicad-libraries/3d/unsorted/R1S-8SMD.step

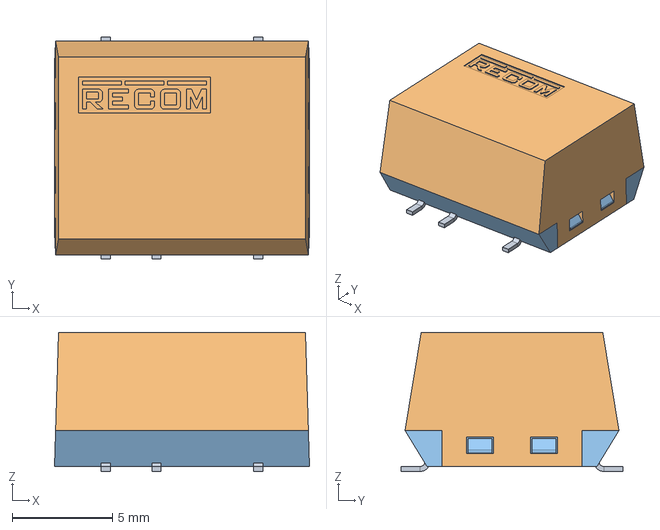
[picture p120: CAD file, 2025-01-22]
3d/unsorted/R1S-8SMD.step
12.8 x 11.1 x 6.95 mm
