Tinkerforge/kicad-libraries/3d/Buttons_Switches/B3U-1000P.step

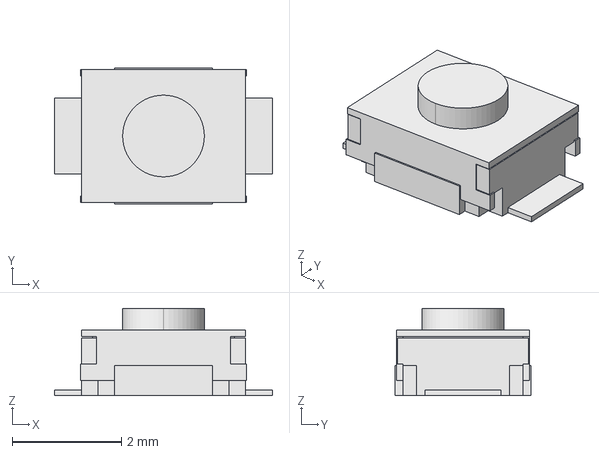
[picture p121: CAD file, 2020-09-11]
3d/Buttons_Switches/B3U-1000P.step
4.00 x 2.50 x 1.60 mm
