Tinkerforge/kicad-libraries/3d/Capacitors_SMD/c_elec_4x5.7.step

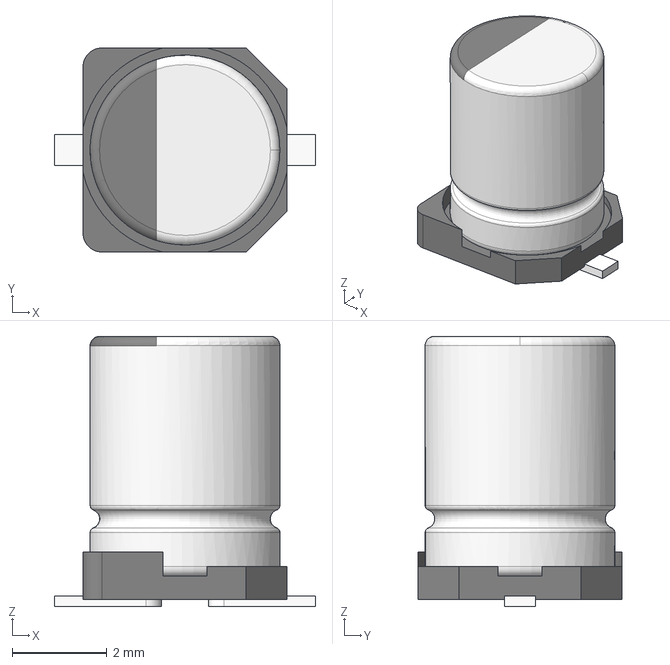
[picture p122: CAD file, 2017-04-28]
3d/Capacitors_SMD/c_elec_4x5.7.step
5.50 x 4.30 x 5.70 mm
