Tinkerforge/kicad-libraries/3d/Capacitors_Tantalum_SMD/Tantalum_Case-V_EIA-7343-20.step

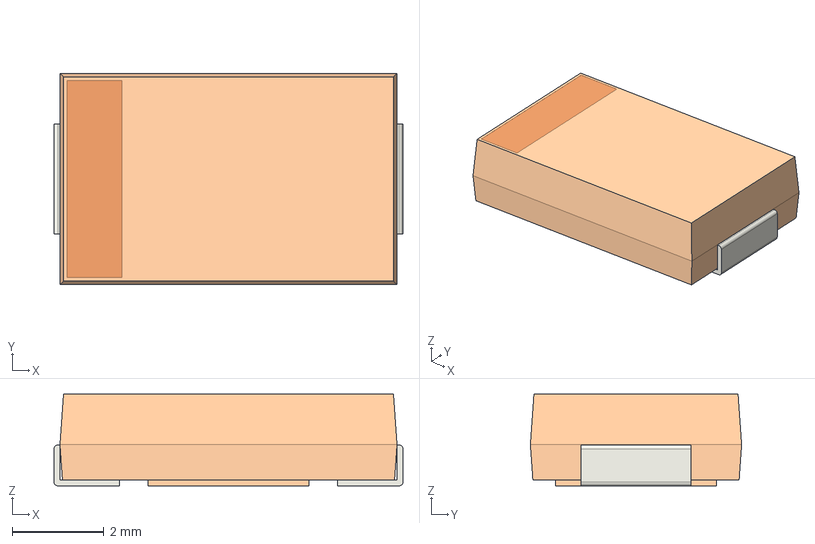
[picture p123: CAD file, 2017-03-24]
3d/Capacitors_Tantalum_SMD/Tantalum_Case-V_EIA-7343-20.step
7.60 x 4.60 x 2.00 mm
