Tinkerforge/kicad-libraries/3d/Connectors/OQ_4P_5mm_230V.step

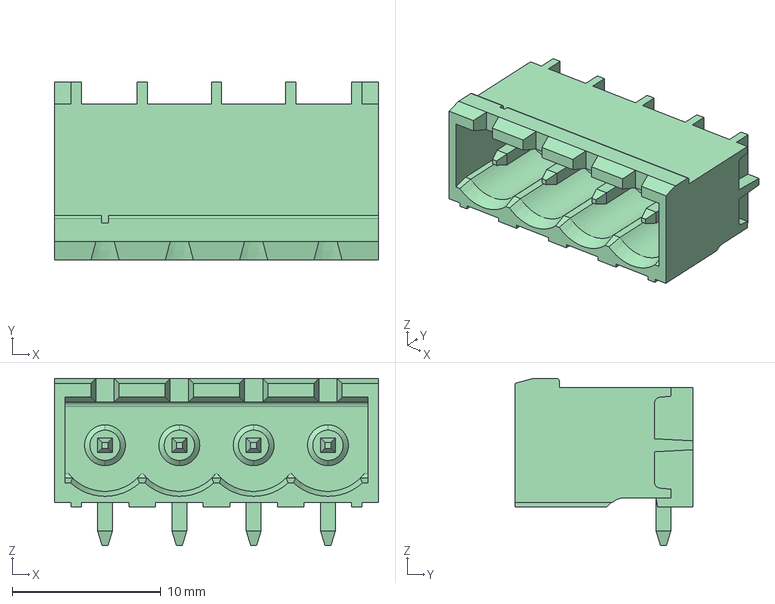
[picture p124: CAD file, 2024-06-24]
3d/Connectors/OQ_4P_5mm_230V.step
21.8 x 12.0 x 11.2 mm
