Tinkerforge/kicad-libraries/3d/Connectors_TF/BrickletConn_7pin_180.step

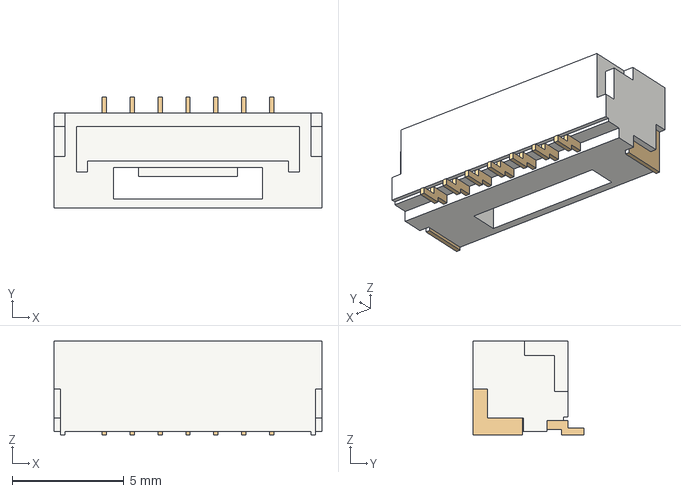
[picture p125: CAD file, 2018-07-13]
3d/Connectors_TF/BrickletConn_7pin_180.step
12.0 x 4.95 x 4.20 mm
