Tinkerforge/kicad-libraries/3d/Housing_SO/SO-8.step

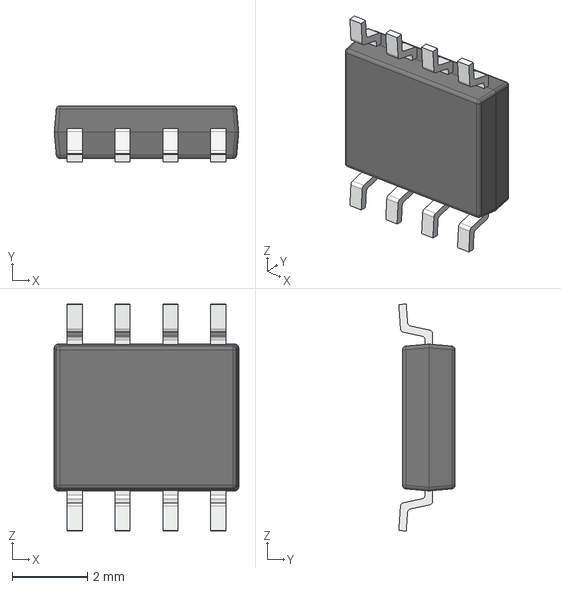
[picture p126: CAD file, 2017-05-31]
3d/Housing_SO/SO-8.step
4.90 x 1.50 x 6.03 mm
