Tinkerforge/kicad-libraries/3d/Housing_SOT_SOD/SOD323F.step

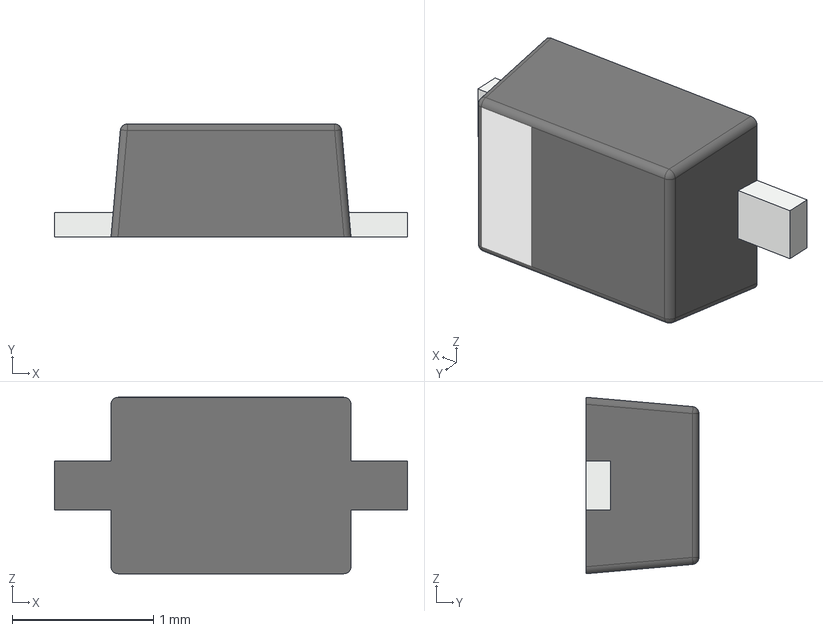
[picture p127: CAD file, 2017-03-24]
3d/Housing_SOT_SOD/SOD323F.step
2.50 x 0.8 x 1.25 mm
