Tinkerforge/kicad-libraries/3d/Housing_SSOP/SOP-4-WIDE.step

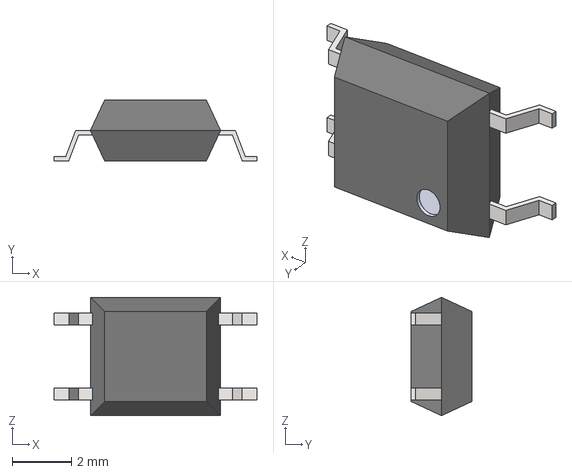
[picture p128: CAD file, 2017-07-31]
3d/Housing_SSOP/SOP-4-WIDE.step
6.86 x 2.05 x 4.00 mm
