Tinkerforge/kicad-libraries/3d/Housings_DFN_QFN/QFN-56-8x8mm_Pitch0.5mm.step

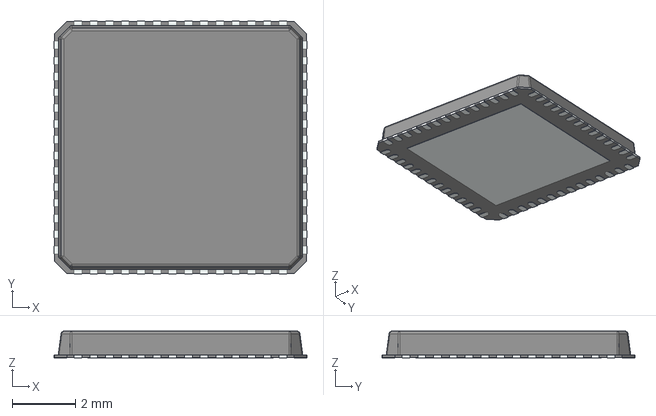
[picture p129: CAD file, 2019-04-26]
3d/Housings_DFN_QFN/QFN-56-8x8mm_Pitch0.5mm.step
8.02 x 8.02 x 0.85 mm
