Tinkerforge/kicad-libraries/3d/Housings_QFP/LQFP-44_10x10mm_Pitch0.8mm.step

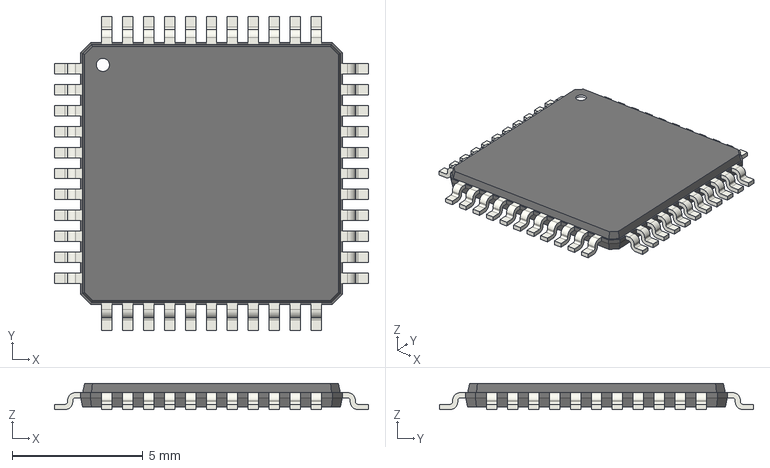
[picture p130: CAD file, 2017-03-24]
3d/Housings_QFP/LQFP-44_10x10mm_Pitch0.8mm.step
12.0 x 12.0 x 1.00 mm
