Tinkerforge/kicad-libraries/3d/Housings_SOIC/SOIC-28_7.5x17.9mm_Pitch1.27mm.step

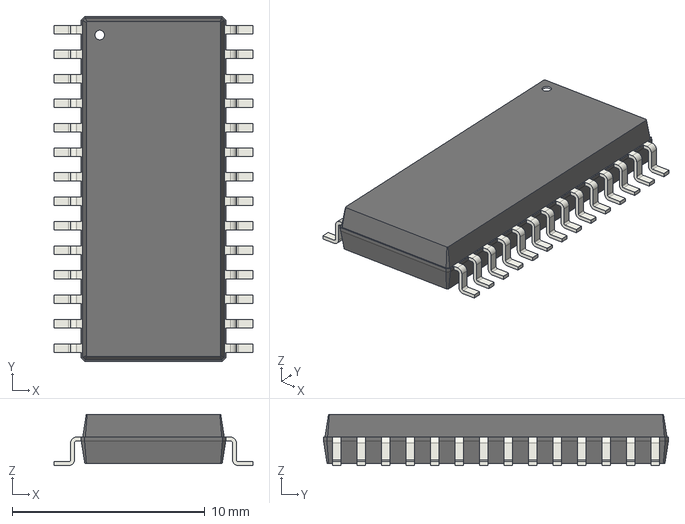
[picture p131: CAD file, 2017-03-24]
3d/Housings_SOIC/SOIC-28_7.5x17.9mm_Pitch1.27mm.step
10.3 x 17.9 x 2.65 mm
