Tinkerforge/kicad-libraries/3d/HRLV-MaxSonar.step

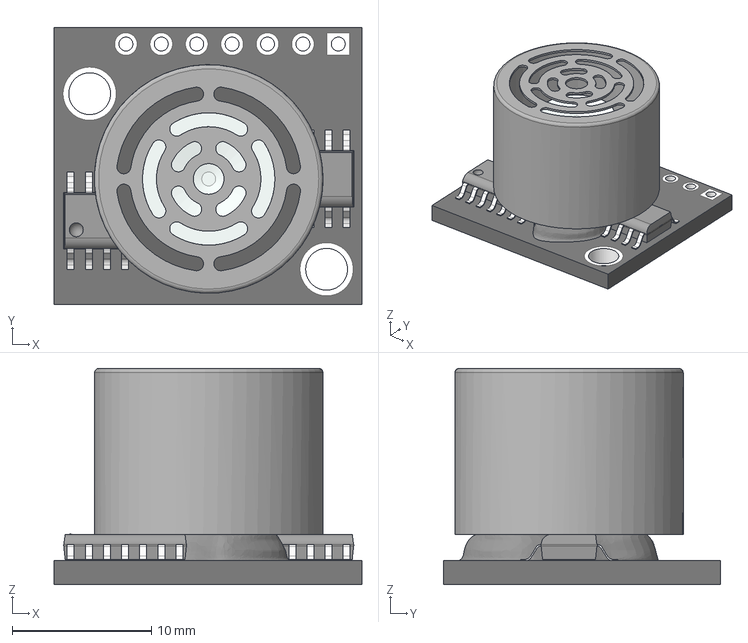
[picture p132: CAD file, 2019-07-03]
3d/HRLV-MaxSonar.step
22.1 x 19.9 x 15.5 mm
