Tinkerforge/kicad-libraries/3d/Inductors/WE-UNIT-EE13-V.step

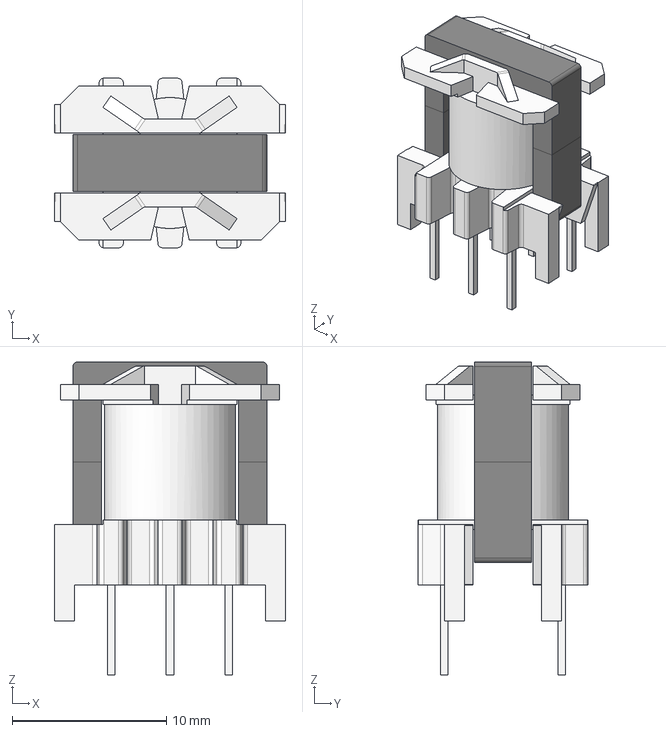
[picture p133: CAD file, 2022-01-21]
3d/Inductors/WE-UNIT-EE13-V.step
15.0 x 11.0 x 20.3 mm
