Tinkerforge/kicad-libraries/3d/LED_SMD/D1206_INV_blue.step

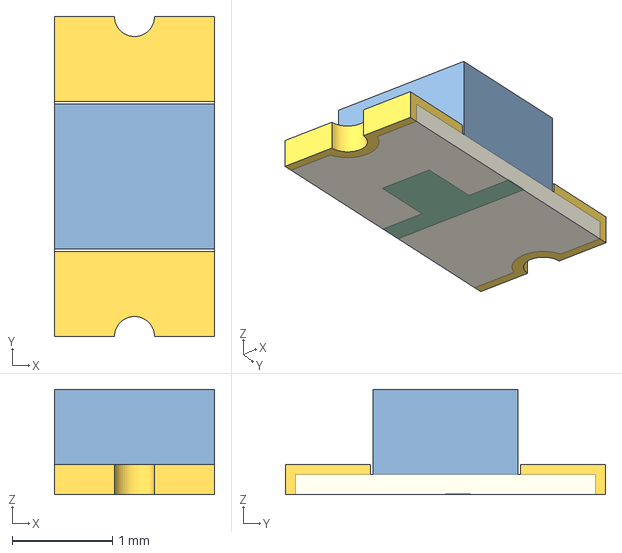
[picture p134: CAD file, 2018-03-01]
3d/LED_SMD/D1206_INV_blue.step
1.60 x 3.20 x 1.05 mm
