Tinkerforge/kicad-libraries/3d/Pin_Header/Pin_Header_Straight_Female_1x08.step

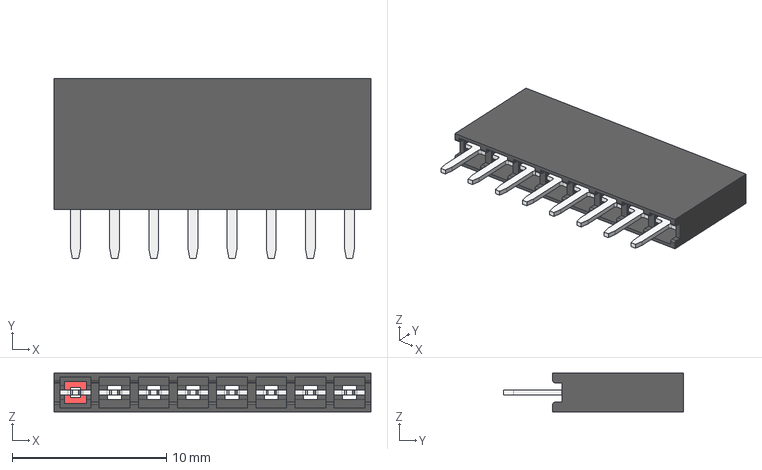
[picture p135: CAD file, 2018-03-27]
3d/Pin_Header/Pin_Header_Straight_Female_1x08.step
20.6 x 11.7 x 2.50 mm
