Tinkerforge/kicad-libraries/3d/Resistors_SMD/R_1206.step

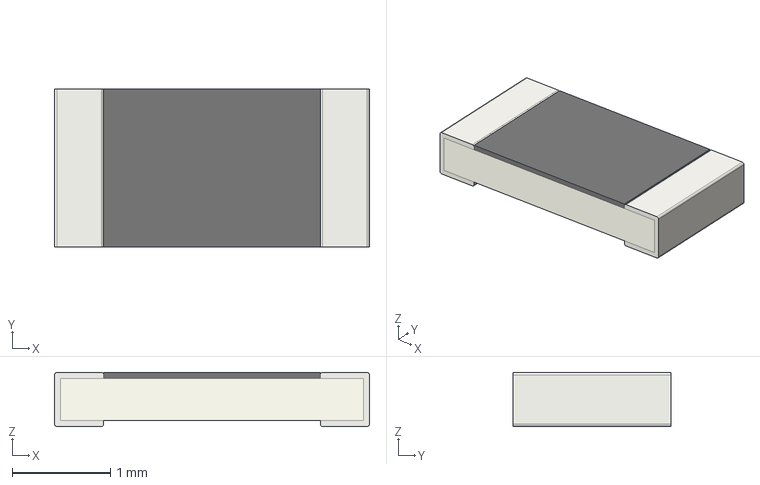
[picture p136: CAD file, 2017-03-24]
3d/Resistors_SMD/R_1206.step
3.20 x 1.60 x 0.55 mm
