Tinkerforge/kicad-libraries/3d/Sensors_Detectors/SDP810.step

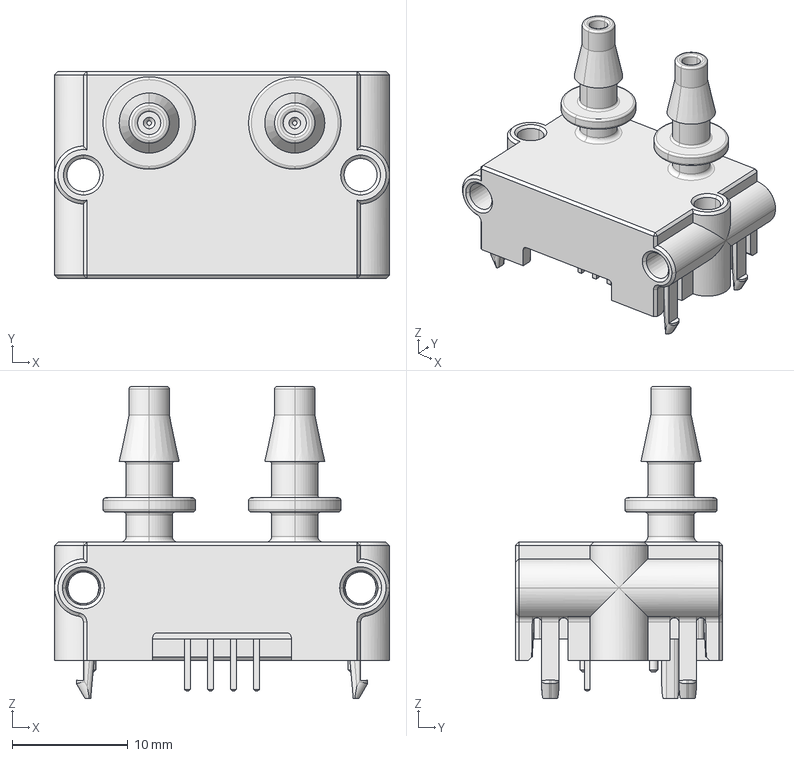
[picture p137: CAD file, 2019-09-05]
3d/Sensors_Detectors/SDP810.step
29.0 x 17.9 x 27.1 mm
