Tinkerforge/kicad-libraries/3d/Buttons_Switches/SW_06_SMD.step

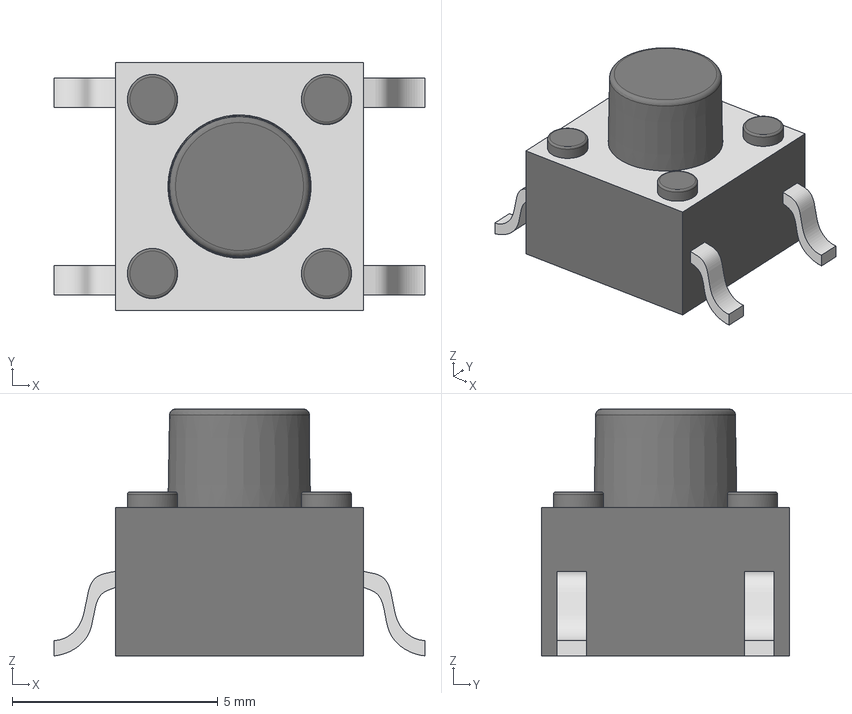
[picture p138: CAD file, 2019-11-07]
3d/Buttons_Switches/SW_06_SMD.step
9.02 x 6.03 x 6.00 mm
