Tinkerforge/kicad-libraries/3d/Capacitors_SMD/c_elec_6.3x7.7.step

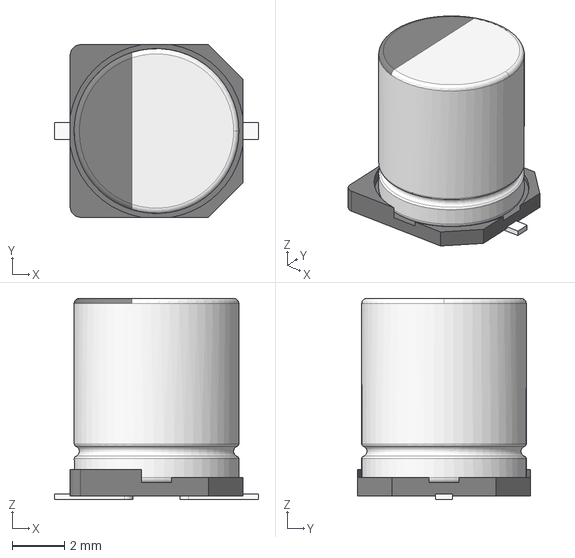
[picture p139: CAD file, 2017-04-28]
3d/Capacitors_SMD/c_elec_6.3x7.7.step
7.80 x 6.60 x 7.70 mm
