Tinkerforge/kicad-libraries/3d/Capacitors_Tantalum_SMD/Tantalum_Case-B_EIA-3528-21.step

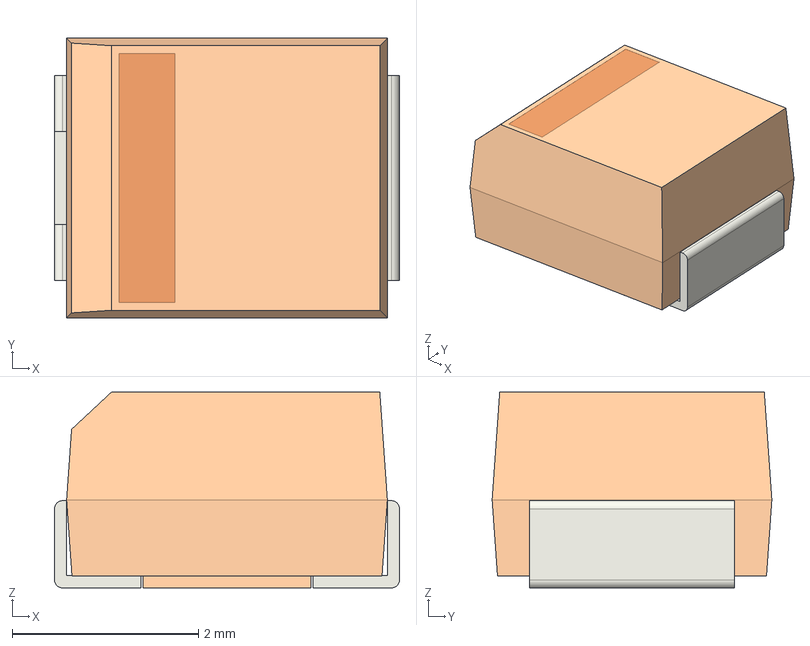
[picture p140: CAD file, 2017-03-24]
3d/Capacitors_Tantalum_SMD/Tantalum_Case-B_EIA-3528-21.step
3.70 x 3.00 x 2.10 mm
