Tinkerforge/kicad-libraries/3d/Connectors_TF/BrickletConn_7pin.step

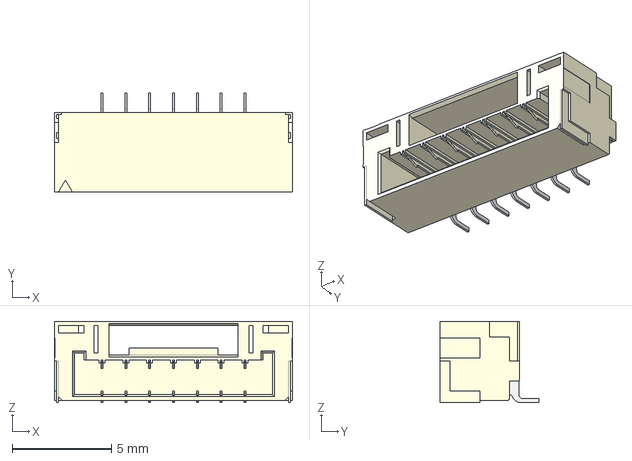
[picture p141: CAD file, 2017-11-15]
3d/Connectors_TF/BrickletConn_7pin.step
12.0 x 4.98 x 4.10 mm
