Tinkerforge/kicad-libraries/(list of files, cad)

Other CAD files:
3d/Pin_Header/JST_PH_2_Top.FCStd
3d/WE-6065.step
3d/Connectors/MTJ_88ARX1_FSM_LG.step
3d/Housings_DFN_QFN/XMC_1100.step
3d/Housings_QFP/TQFP-48_7x7mm_Pitch0.5mm.step
3d/LED_SMD/EASV3015RGBA0.step
3d/rotary_poti_knob.step
3d/Housings_QFP/LQFP-52_10x10mm_Pitch0.65mm.step
3d/Batteries/battery_retainer.fcstd
3d/Batteries/battery_retainer_2998.fcstd
3d/Buttons_Switches/AZ943-1CH-5DE-Relay.fcstd
3d/Buttons_Switches/AZ943-1CH-5DE-Relay.step
3d/Buttons_Switches/B3U-1000P.FCStd
3d/Buttons_Switches/CS-4-22YA.FCStd
3d/Buttons_Switches/DIP_SW_2LPST.FCStd
3d/Buttons_Switches/G5LE-1-Relay.fcstd
3d/Buttons_Switches/G5LE-1-Relay.step
3d/Buttons_Switches/Joystick_withButton.fcstd
3d/Buttons_Switches/Joystick_withButton.step
3d/Buttons_Switches/OS103011MS8QP1.FCStd
3d/Buttons_Switches/OS103011MS8QP1.step
3d/Buttons_Switches/RGBLED_Button.fcstd
3d/Buttons_Switches/RGB_SWITCH_AD.fcstd
3d/Buttons_Switches/RGB_SWITCH_AD.step
3d/Buttons_Switches/SW_06_SMD.FCStd
3d/Buttons_Switches/SW_DIP_4_THT_90.FCStd
3d/Buttons_Switches/SW_DIP_5_THT_90.FCStd
3d/Buttons_Switches/SW_DIP_THT_.fcstd
3d/Buttons_Switches/SW_DIP_THT_.step
3d/Buttons_Switches/TACT-6MM-HOR.step
3d/Buttons_Switches/TACT_SWITCH_12mm.fcstd
3d/Buttons_Switches/TACT_SWITCH_12mm.step
3d/Buttons_Switches/silde_switch_smd.fcstd
3d/Buttons_Switches/silde_switch_smd.step
3d/Buttons_Switches/tact_switch_bricks.fcstd
3d/Buttons_Switches/tact_switch_bricks.step
3d/Capacitors_SMD/C_0201.step
3d/Capacitors_SMD/C_0402.step
3d/Capacitors_SMD/C_0603.step
3d/Capacitors_SMD/C_0603_HandSoldering.step
3d/Capacitors_SMD/C_0805.step
3d/Capacitors_SMD/C_0805P.fcstd
3d/Capacitors_SMD/C_0805_HandSoldering.step
3d/Capacitors_SMD/C_1206.step
3d/Capacitors_SMD/C_1206_HandSoldering.step
3d/Capacitors_SMD/C_1210.step
3d/Capacitors_SMD/C_1210_HandSoldering.step
3d/Capacitors_SMD/C_1812.step
3d/Capacitors_SMD/C_1812_HandSoldering.step
3d/Capacitors_SMD/C_1825.step
3d/Capacitors_SMD/C_1825_HandSoldering.step
3d/Capacitors_SMD/C_2220.step
3d/Capacitors_SMD/C_2220_HandSoldering.step
3d/Capacitors_SMD/C_2225.step
3d/Capacitors_SMD/C_2225_HandSoldering.step
3d/Capacitors_SMD/ELNA_DSK.FCStd
3d/Capacitors_SMD/c_elec_10x10.5.step
3d/Capacitors_SMD/c_elec_10x10.step
3d/Capacitors_SMD/c_elec_10x7.7.step
3d/Capacitors_SMD/c_elec_3x5.3.step
3d/Capacitors_SMD/c_elec_4x4.5.step
3d/Capacitors_SMD/c_elec_4x5.8.step
3d/Capacitors_SMD/c_elec_5x4.5.step
3d/Capacitors_SMD/c_elec_5x5.3.step
3d/Capacitors_SMD/c_elec_5x5.7.step
3d/Capacitors_SMD/c_elec_5x5.8.step
3d/Capacitors_SMD/c_elec_6.3x4.5.step
3d/Capacitors_SMD/c_elec_6.3x5.3.step
3d/Capacitors_SMD/c_elec_6.3x5.7.step
3d/Capacitors_SMD/c_elec_6.3x5.8.step
3d/Capacitors_SMD/c_elec_8x10.5.step
3d/Capacitors_SMD/c_elec_8x10.step
3d/Capacitors_SMD/c_elec_8x5.4.step
3d/Capacitors_SMD/c_elec_8x6.5.step
3d/Capacitors_SMD/c_elec_8x6.7.step
3d/Capacitors_Tantalum_SMD/Tantalum_Case-D_EIA-7343-31.step
3d/Capacitors_Tantalum_SMD/Tantalum_Case-R_EIA-2012-12.step
3d/Capacitors_Tantalum_SMD/Tantalum_Case-S_EIA-3216-12.step
3d/Capacitors_Tantalum_SMD/Tantalum_Case-U_EIA-6032-15.step
3d/Capacitors_wired/CB32021.step
3d/Capacitors_wired/CB32022.step
3d/Capacitors_wired/C_B32021.FCStd
3d/Capacitors_wired/C_B32022.FCStd
3d/Connectors/200241-1122.FCStd
3d/Connectors/200241-1122.step
3d/Connectors/20x2 Female.FCStd
3d/Connectors/43650-0229.step
3d/Connectors/43650-0329.step
3d/Connectors/43650-0429.step
3d/Connectors/4910_rev.C.step
3d/Connectors/5031821852.step
3d/Connectors/5031821852.stp
3d/Connectors/7499111447.FCStd
3d/Connectors/7499111447.step
3d/Connectors/AKL-5-4.step
3d/Connectors/AKL_5_2.fcstd
3d/Connectors/AKL_5_2.step
3d/Connectors/AKL_5_2_508_black.fcstd
3d/Connectors/AKL_5_2_508_black.step
3d/Connectors/AKL_5_2_508_green.fcstd
3d/Connectors/AKL_5_2_508_green.step
3d/Connectors/AKL_5_3.fcstd
3d/Connectors/AKL_5_3.step
3d/Connectors/AKL_5_5.fcstd
3d/Connectors/AKL_5_5.step
3d/Connectors/B2B-PH-K-S.FCStd
3d/Connectors/B2B-PH-K-S.step
3d/Connectors/B2B-PH-SM4-TB(LF)(SN).step
3d/Connectors/BH06B-PASK.FCStd
3d/Connectors/CONN_OLED_128x64.fcstd
3d/Connectors/CONN_OLED_128x64.step
3d/Connectors/CON_4Wire_ER-TP028-1.fcstd
3d/Connectors/CON_4Wire_ER-TP028-1.step
3d/Connectors/DC-033.FCStd
3d/Connectors/DC-033.step
3d/Connectors/DSUB15-Female.step
3d/Connectors/DSUB15-Male.step
3d/Connectors/DSUB9-Female.step
3d/Connectors/DSUB9-Male.fcstd
3d/Connectors/DSUB9-Male.step
3d/Connectors/DSUB9-Male_old.step
3d/Connectors/ER-CON24HT-1.FCStd
3d/Connectors/ER-CON24HT-1.step
3d/Connectors/FT-004B.fcstd
3d/Connectors/FT-004B.step
3d/Connectors/FT-004B_simple.fcstd
3d/Connectors/FT-004B_simple.step
3d/Connectors/JST-PH-3-THT.fcstd
3d/Connectors/JST-PH-3-THT.step
3d/Connectors/JST-PH-6-THT.FCStd
3d/Connectors/JST_GHR_6.fcstd
3d/Connectors/JST_GHR_6.step
3d/Connectors/JST_PH_4_90_THT.FCStd
3d/Connectors/JST_PH_4_90_THT.step
3d/Connectors/JST_PH_4_THT.FCStd
3d/Connectors/JST_PH_4_THT.step
3d/Connectors/JST_PH_5_90_THT.FCStd
3d/Connectors/JST_PH_5_90_THT.step
3d/Connectors/MF_507_6_VERT.FCStd
3d/Connectors/MF_507_6_VERT.step
3d/Connectors/MTJ-88ARX1-FSM-LG.FCStd
3d/Connectors/MicroHDMI_connector.step
3d/Connectors/Mini-PCIE.FCStd
3d/Connectors/Mini-PCIE.step
3d/Connectors/MiniUSB.fcstd
3d/Connectors/MiniUSB.step
3d/Connectors/NanoSIM_693043020611.FCStd
3d/Connectors/NanoSIM_693043020611.step
3d/Connectors/OQ 2P black-5mm vertical.step
3d/Connectors/OQ 2P green-5mm vertical.step
3d/Connectors/OQ 2P green-5mm.step
3d/Connectors/OQ 4P 5mm vertical.step
3d/Connectors/OQ 4P vertical.step
3d/Connectors/OQ_12P_green.fcstd
3d/Connectors/OQ_12P_green.step
3d/Connectors/OQ_14P_2_5.FCStd
3d/Connectors/OQ_14P_2_5.step
3d/Connectors/OQ_2P_5mm_230V.FCStd
3d/Connectors/OQ_2P_black-5mm_vertical.FCStd
3d/Connectors/OQ_2P_black.fcstd
3d/Connectors/OQ_2P_black.step
3d/Connectors/OQ_2P_green-5mm_vertical.FCStd
3d/Connectors/OQ_2P_green.fcstd
3d/Connectors/OQ_2P_green.step
3d/Connectors/OQ_3P_black.fcstd
3d/Connectors/OQ_3P_black.step
3d/Connectors/OQ_3P_green.fcstd
3d/Connectors/OQ_3P_green.step
3d/Connectors/OQ_3P_grey.fcstd
3d/Connectors/OQ_3P_grey.step
3d/Connectors/OQ_3P_vertical.step
3d/Connectors/OQ_4P_5mm_230V.FCStd
3d/Connectors/OQ_4P_5mm_vertical.FCStd
3d/Connectors/OQ_4P_green.fcstd
3d/Connectors/OQ_4P_green.step
3d/Connectors/OQ_4P_vertical.FCStd
3d/Connectors/OQ_6P_green.fcstd
3d/Connectors/OQ_6P_green.step
3d/Connectors/OQ_6P_green.stp
3d/Connectors/OQ_6P_grey.fcstd
3d/Connectors/OQ_6P_grey.step
3d/Connectors/OQ_8P_green.fcstd
3d/Connectors/OQ_8P_green.step
3d/Connectors/PCC-SMP_simple.fcstd
3d/Connectors/PCC-SMP_simple.step
3d/Connectors/PCC_SMP_K.fcstd
3d/Connectors/PCC_SMP_K.step
3d/Connectors/PJ-327C-3.FCStd
3d/Connectors/PJ-327C-3.step
3d/Connectors/S3B-PH-SM4.fcstd
3d/Connectors/S3B-PH-SM4.step
3d/Connectors/SD-DM3CS.step
3d/Connectors/SMA-angled-long.fcstd
3d/Connectors/SMA-angled-long.step
3d/Connectors/SMARC_V21.FCStd
3d/Connectors/TBLH10-350-05.FCStd
3d/Connectors/TBLH10V_350_04.FCStd
3d/Connectors/TBLH10V_350_04.step
3d/Connectors/TBLH10V_350_10.FCStd
3d/Connectors/TBLH10V_350_10.step
3d/Connectors/TBLH10V_500_02.FCStd
3d/Connectors/TBLH10V_500_02.step
3d/Connectors/TBLH10V_500_03.FCStd
3d/Connectors/TBLH10V_500_03.step
3d/Connectors/TBLH10V_500_04.FCStd
3d/Connectors/TBLH10V_500_04.step
3d/Connectors/TBLH10_350_06.FCStd
3d/Connectors/TBLH10_350_06.step
3d/Connectors/TJLC_001LA1.FCStd
3d/Connectors/TSTP_MINI.FCStd
3d/Connectors/TSTP_MINI.step
3d/Connectors/U-FL_CON.fcstd
3d/Connectors/U-FL_CON.step
3d/Connectors/USB4105.step
3d/Connectors/USB_Micro_Vertical.step
3d/Connectors/USB_Type_B_Socket.fcstd
3d/Connectors/USB_Type_B_Socket.step
3d/Connectors/V7-8.step
3d/Connectors/XLR_2x3.fcstd
3d/Connectors/XLR_2x3.step
3d/Connectors/micro-usb-smd.step
3d/Connectors/raspberrypi_hat2.step
3d/Connectors/raspberrypi_zero_hat.step
3d/Connectors/wm_2491620000.FCStd
3d/Connectors/wm_2491620000.step
3d/Connectors_TF/614004185023.stp
3d/Connectors_TF/74991114410.stp
3d/Connectors_TF/BrickletConn_10pin.fcstd
3d/Connectors_TF/BrickletConn_10pin.step
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
