Tinkerforge/kicad-libraries/(threads)

Thread 3 (2016-07-05):

License

spadgenske, 2016-07-05:
Hello,
Just wondering what the footprints are licensed under and (if) I can use them in my own personal projects.

borg42, 2016-07-05:
All of our hardware schematic, design files etc. are licensed under the CERN Open Source Hardware License Version 1.1 (CERN OHL V1.1). I added a license file to the git.

Closed 2016-07-05.

Thread 6 (2025-03-24):

Kicad 8 issues

dizcza, 2025-03-24:
Just letting you know

```
Kicad Version: 8.0.9-8.0.9-0~ubuntu22.04.1, release build

Platform: Ubuntu 22.04.5 LTS, 64 bit, Little endian, wxGTK, X11, ubuntu, x11
OpenGL: NVIDIA Corporation, NVIDIA GeForce GTX 980/PCIe/SSE2, 4.6.0 NVIDIA 550.120

Build Info:
	Date: Feb 19 2025 14:24:54
	wxWidgets: 3.2.1 (wchar_t,wx containers) GTK+ 3.24
	Boost: 1.74.0
	OCC: 7.6.3
	Curl: 7.81.0
	ngspice: 43
	Compiler: GCC 11.4.0 with C++ ABI 1016
```

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
