Tinkerforge/kicad-libraries/(commit log)

2012-09-17 update of libraries, many new symbols and footprints added
2014-02-27 update kicad libraries with new designs
2014-03-19 add new parts to the kicad libraries
2014-09-01 new parts added change silkscreen outlines for standard items to 0.0 (not visible)
2014-09-10 fix pin name of a10s
2014-10-01 add new footprints, e.g. mq sensor
2014-12-03 update silkscreen outlines of some footprints to 0.01 mm thickness and layer front silkscreen
2014-12-04 update silkscreens of some footprints
2015-01-08 filter array, dfn-16
2015-01-26 add testpoint footprint Please enter the commit message for your changes. Lines starting
2015-02-24 fix ssop20 footprint
2015-02-27 add g5q-eu relay symbol and footprint
2015-03-02 change mg socket footprint
2015-03-04 add pin array 5x1
2015-03-09 add bno055 and lga28 footprint
2015-03-12 change rs232 socket footprint
2015-03-24 change to new format, rename folder to kicad-libraries.pretty
2015-03-25 avx 9175 3 pole footprint
2015-04-02 new footprints
2015-04-23 add new footprints
2015-05-07 add usb A footprint with pegs
2015-05-07 change peg diameter: 2mm-> 1.2mm
2015-05-18 fix addAll script, add ICM2824 footprint
2015-05-19 add msh co2 sensor
2015-05-27 add k30 gas sensor
2015-06-19 add oled display footprints and symbols
2015-06-24 add tmc21xx and qfn36 footprint
2015-07-08 add SC70-5 footprint
2015-08-12 add qfn-10 footprint
2015-08-13 therminal block connector added
2015-08-26 add VEML6070 uv sensor, OPLGA6 footprint and extended standard footprints
2015-08-26 add extended 0603 LED footprint
2015-09-11 symbols and footprints for pam2301, jst ph 2pole and aat3681a
2015-10-22 add bme280, mems microphone, pin arrays and so8 power footprints
2015-11-02 new footprints and symbols
2015-11-05 new footprint
2015-11-11 soic18 footprint added
2015-11-16 fix raspberrypi footprint
2015-11-18 wd2812 leds, motorized poti, battery holder
2015-12-01 add mpx sensor, change raspberry footprint
2015-12-08 add standard sized capacitors
2015-12-10 standard resistor symbol added
2015-12-10 change raspberry pi 2 drills to 2.75mm
2015-12-11 add new connectors and smd diode
2015-12-22 fix footprints
2015-12-22 fix footprint
2015-12-30 fix some footprints
2016-02-01 fix battery holder and microphone footprints
2016-03-04 update footprints
2016-03-22 new footprints: gps qfn and smd connector
2016-03-22 increase drill size
2016-03-31 switch to smd
2016-04-19 add new hardware footprints and symbols
2016-04-26 fix some footprints, add new footprints for optocouplers
2016-05-02 fix symbol pin types
2016-05-13 fix diode footprint
2016-05-19 new SO-6 footprint for optocouplers, optocoupler symbol
2016-05-20 footprints nr4040 and sip7 adapted
2016-06-17 oled connector, some wuerth cms added
2016-06-17 new 1.27mm header
2016-06-22 change tmc2130 footprint and symbol
2016-07-05 Add missing license file for kicad-lib repo
2016-07-25 modify led symbols
2016-08-22 add battery holder mockup
2016-09-13 fix battery holder footprint
2016-10-18 drawing xmc1xxx symbols (24pin, 40pin) drawing qfn 24/40 footprints
2016-10-18 add dfn8 footprint, change line width
2016-10-19 fixing some footprints for better solderability
2016-11-04 fix npth of thermocouple footprint
2016-11-28 new footprint, mark pad 1
2017-01-10 add 7pole JST GH connector
2017-01-12 add new 0603 footprint
2017-01-25 new power components added
2017-02-09 add pin array 7x1
2017-02-09 add rs422 drivers
2017-02-10 Add SIP4 package footprint
2017-02-10 fixing footprints
2017-02-13 fixing mounting holes
2017-02-13 Add RGB Switch CIT AD Series
2017-02-13 Fix SIP4 footprint
2017-02-14 Add RGB_SWITCH_AD footprint
2017-02-15 fixing footprint
2017-02-15 Add DMX_IN_OUT_2x3POL footprint
2017-03-03 new pin array
2017-03-07 Fix Pin 2.9 from AIO to AI
2017-03-24 Add 3D .step and .wrl data for 3D models (initial)
    [3225.step, BrickletConn_old.step, C_0201.step, C_0402.step, C_0603.step, C_0603_HandSoldering.step, C_0805.step, C_0805_HandSoldering.step]
2017-03-24 Add kiCAD StepUp Script
    refer to https://sourceforge.net/projects/kicadstepup/
2017-04-18 different footprints for resistors and capacitors
2017-04-19 Add SOT-23-6 housing
    [SOT-23-6.step]
2017-04-19 Add SOT-23 housing
    [SOT-23.step]
2017-04-21 Add different footprints for resistors and capacitors
2017-04-21 Add lots of DFN and QFN housings
    [DFN-10-1EP_2x3mm_Pitch0.5mm.step, DFN-10-1EP_3x3mm_Pitch0.5mm_S-PVSON-N10.step, DFN-6-1EP_2x2mm_Pitch0.65mm.step, DFN-8-1EP_2x3mm_Pitch0.5mm.step, DFN-8-1EP_3x3mm_Pitch0.5mm.step, DFN-8-1EP_3x3mm_Pitch0.65mm.step, DFN-8-1EP_6x5mm_Pitch1.27mm.step, LGA-16_3x3mm_Pitch0.5mm.step]
2017-04-25 add new relay footprint
2017-04-28 Add new *.fcstd components
    [AKL_5_2.fcstd, AKL_5_3.fcstd, BrickletConn_7pin.fcstd, SOIC-14_3.9x8.7mm_Pitch1.27mm.fcstd, SW_DIP_THT_.fcstd, WE_SL_744205.fcstd, battery_retainer.fcstd, btb_btm.fcstd]
2017-04-28 Reorder and rename 3d models
    [AKL_5_2.fcstd, AKL_5_3.fcstd, BrickletConn_10pin.step, BrickletConn_7pin.fcstd, MiniUSB.step, SOIC-14_3.9x8.7mm_Pitch1.27mm.fcstd, SW_DIP_THT_.fcstd, WE-CNSW-0603.step]
2017-04-28 Change 3d paths of footprints
2017-04-28 Center component
    [AKL_5_2.fcstd, AKL_5_3.fcstd, WE_SL_744205.fcstd, battery_retainer.fcstd]
2017-04-28 Add various 3d models *.step and *.wrl for KiCad
    [AKL_5_2.step, AKL_5_3.step, SW_DIP_THT_.step, WE_SL_744205.step, battery_retainer.step]
2017-04-28 Add 3d models to footprint
2017-04-28 Add various capacitor models
    [c_elec_10x10.5.step, c_elec_10x10.step, c_elec_10x7.7.step, c_elec_3x5.3.step, c_elec_4x4.5.step, c_elec_4x5.3.step, c_elec_4x5.7.step, c_elec_4x5.8.step]
2017-04-28 Add new 3d model: QFN-24-4x4mm
    [QFN-24_4x4mm_Pitch0.5mm.step]
2017-04-28 Add various pin headers 01Xxx and 02Xxx
    [Pin_Header_Straight_1x01.step, Pin_Header_Straight_1x02.step, Pin_Header_Straight_1x03.step, Pin_Header_Straight_1x04.step, Pin_Header_Straight_1x05.step, Pin_Header_Straight_1x06.step, Pin_Header_Straight_1x07.step, Pin_Header_Straight_1x08.step]
2017-05-04 change footprint silkscreen layers to f.fab
2017-05-04 add debug pad footprint
2017-05-05 Add new Bricklet connector (3d)
    [BrickletConn_7pin.fcstd, BrickletConn_7pin.step]
2017-05-05 Add more 3d information for existing footprints
2017-05-05 Add more 3d models
    [AKL_5_5.fcstd, AKL_5_5.step, DO-214AC.step, D_0603_yellow.step]
2017-05-05 Change connector pins to passive
2017-05-08 fix led symbol
2017-05-12 Add 3d model for DFN-10-1EP_2x3mm_Pitch0.5mm
2017-05-12 Add 3d information for HTSSOP28
    [HTSSOP-28.step]
2017-05-15 1206 fix layer for silkscreen
2017-05-18 update footprint for better pin1 detection
2017-05-18 remove silkscreen layers, but on f.fab
2017-05-19 Add 3d models: 4 and 8 pin connector green
    [4er_Phoenix_Buchse_grün.fcstd, 8er_Phoenix_Buchse_grün.fcstd]
2017-05-19 Add 3d information: SO-8
    [SO-8.step]
2017-05-19 Add 3d models: OQ_4P & OQ_8P
    [OQ_4P_green.fcstd, OQ_4P_green.step, OQ_8P_green.fcstd, OQ_8P_green.step]
2017-06-02 Add 3d information to footprints SO-8 & SRP7030
2017-06-02 Add 3d models: SRP7030
    [SRP7030.fcstd, SRP7030.step]
2017-06-09 Add new components
    [OQ_2P_black.fcstd, OQ_2P_green.fcstd, OQ_8P_green.fcstd]
2017-06-09 Update components from FCStd file
    [OQ_8P_green.step]
2017-06-09 Add new component: OQ_2P
    [OQ_2P_black.step, OQ_2P_green.step]
2017-06-09 Update component model: MiniUSB
    [MiniUSB.step]
2017-06-09 Add *.FCStd: MiniUSB
    [MiniUSB.fcstd]
2017-06-16 Add new 3d model: D0603_green
    [D_0603_green.step]
2017-06-16 Add 3d model to footprint
2017-06-16 Add 3d model: SMD UFL antenna connector
    [U-FL_CON.step]
2017-06-16 New 3d model for tactile switches
    [brick_button_SMD.step, tact_switch_bricks.fcstd, tact_switch_bricks.step]
2017-06-16 Add footprint for heatsink
2017-06-16 Add 3d model: heatsink
    [heatsink.fcstd, heatsink.step]
2017-06-16 Add 3d model: 4x0402 (resistor)
    [R_4x0402.fcstd, R_4x0402.step, R_4x0402_2.fcstd]
2017-06-23 little change
    [MiniUSB.fcstd]
2017-06-23 New version of this model
    [U-FL_CON.fcstd, U-FL_CON.step]
2017-06-23 FireFlyX1: add 3d model
    [FireFlyX1.fcstd, FireFlyX1.step]
2017-06-23 FT-GPS-001: Add footptrint and 3d model for GPSv2 Bricklet
    [FT-GPS-001.fcstd, FT-GPS-001.step]
2017-06-26 add new picoblade connector
2017-06-30 Add 3d model to footprint; move outline to fab layer
2017-06-30 Add new 3d models
    [MSOP-10.step, MSOP-8.step, VSSOP-8 DGK.step]
2017-06-30 MSSOP10: Add 3d models to existing footprints
2017-06-30 VSSOP-8: Add 3d models to existing footprint
    [SSOP-8-P-0.65.step, VSSOP-8.step]
2017-07-05 fix footprint pitch and dimensions
2017-07-07 Rename components
    [Pin_Header_Angled_3x7.fcstd, Pin_Header_angle_3x7.fcstd, USB.fcstd, USB_Type_B_Socket.fcstd]
2017-07-07 Add *.step and *.wrl files
    [Pin_Header_Angled_3x7.step, USB_Type_B_Socket.step]
2017-07-07 Add lots of new 3d models
    [FBGA-96_14x9mm.fcstd, FBGA-96_14x9mm.step, GPIO_Red-Brick.stp, MicroHDMI_connector.step, QFN-32-7x7mm- EQ-1.step, SOT-363.step, SPM3012.step, microSD_connector.step]
2017-07-11 fix footprints (fab layer), add MCP3425 symbol
2017-07-27 Add 3d models
    [GPIO-RED-502078-2110-C.fcstd, GPIO-RED-502078-2110-C.step, TPD4S010DQA.fcstd, TPD4S010DQA.step]
2017-07-27 Add 3d information to existing footprints
2017-07-27 Add more details to the model
    [TPD4S010DQA.fcstd, TPD4S010DQA.step]
2017-07-27 Add new 3d model: FBGA-336 (14x14mm) (A10s on RED-Brick)
    [TFBGA-336_14x14mm.fcstd, TFBGA-336_14x14mm.step]
2017-07-27 New version of this 3d model
    [FBGA-96_14x9mm.fcstd]
2017-07-27 Add the new 3d model to this footprint
2017-07-28 Add new 3d models: WE_LQ_1210 & _1812
    [WE_LQ_1210.fcstd, WE_LQ_1210.step, WE_LQ_1812.fcstd, WE_LQ_1812.step]
2017-07-28 Add new footprint: SOT-363
2017-07-28 Add 3d models to existing footprints
2017-07-28 Fix offset in 3d models
    [WE_LQ_1210.step, WE_LQ_1812.step]
2017-07-28 Add 3d model to existing footprint
2017-07-28 Add 3d model: TSSOP-24
    [TSSOP-24.fcstd, TSSOP-24.step]
2017-07-28 add power symbols
2017-07-28 Add new 3d models: TSSOP-8;14:16
    [TSSOP-14.fcstd, TSSOP-14.step, TSSOP-16.fcstd, TSSOP-16.step, TSSOP-8.fcstd, TSSOP-8.step]
2017-07-31 Add 3d information to footprint
2017-07-31 Add 3d model
    [R_4x1206.fcstd, R_4x1206.step]
2017-07-31 Add new 3d model
    [F_1206.fcstd, F_1206.step]
2017-07-31 Add 3d information to footprints
2017-07-31 Add new footprint: C1210 & F1206
2017-08-01 Add new 3d model: SC-59
    [SC-59.fcstd, SC-59.step]
2017-08-01 move footprint outlines to f.fab
2017-08-01 WS2812: Add 3d information to footprint
2017-08-01 LTR-329ALS: Add 3d information to footprint
2017-08-01 Add new 3d models: WS2812 (black and white housing)
    [WS2812B_5050.fcstd, WS2812B_5050.step, WS2812W_5050.fcstd, WS2812W_5050.step]
2017-08-01 Add new 3d model: LTR-329ALS (ambient light sensor)
    [LTR-329ALS-simple.fcstd, LTR-329ALS-simple.step]
2017-08-01 Add some new 3d models
    [D_2x3mm_white.fcstd, D_2x3mm_white.step, FN-TCS3472-color.fcstd, FN-TCS3472-color.step, MS5611-barometer.fcstd, MS5611-barometer.step, silde_switch_smd.fcstd, silde_switch_smd.step]
2017-08-03 New footprint with 3d information: R2512
2017-08-03 Add new 3d model and footprint for "Humidity Bricklet v2"-sensor
    [DFN-6-3x3mm_humidity.fcstd, DFN-6-3x3mm_humidity.step]
2017-08-03 Add 3d models for AKL_5_2_508: black and green
    [AKL_5_2_508_black.fcstd, AKL_5_2_508_black.step, AKL_5_2_508_green.fcstd, AKL_5_2_508_green.step]
2017-08-03 Add 3d model: C0805P
    [C_0805P.fcstd, C_0805P.step]
2017-08-03 Move and rename file
    [Atmel_ATSAM34C.fcstd]
2017-08-04 Add new DFN-housing 3d models
    [DFN-12-4x3mm.fcstd, DFN-12-4x3mm.step, DFN-12-4x4mm.fcstd, DFN-12-4x4mm.step, DFN-14-4x3mm.fcstd, DFN-14-4x3mm.step, DFN-16-5x5mm.fcstd, DFN-16-5x5mm.step]
2017-08-04 Add 3d new models
    [DIP-4-AD_SMD.fcstd, DIP-4-AD_SMD.step, SSOT-6.fcstd, SSOT-6.step]
2017-08-04 Add new 3d model: QFN-20 5x5mm
    [QFN-20-5x5mm.fcstd, QFN-20-5x5mm.step]
2017-08-04 Add 3d information and model for TO-39
    [MLX90614-TemperatureIR.fcstd, MLX90614-TemperatureIR.step]
2017-08-10 move silkscreen layers to f.fab
2017-08-11 add shield pins to dmx socket
2017-08-14 fix rgb switch footprint
2017-08-21 Add 3d information to existing footprint; move outline to fab layer
2017-08-24 Fix width of footprint: -0.3mm
2017-08-24 increase mounting hole diameters
2017-08-29 Add 3d information to existing footprint; outlines to f.fab layer
2017-08-29 Add new footprint: HLGA-10L
2017-08-30 new antenna footprint
2017-08-30 new footprint hvqfn40, fix nfc antenna, pn7150 symbol
2017-09-08 remove silkscreen lines from footprints
2017-09-08 mv outer dimensions from silkscreen to fab
2017-09-14 move silkscreen to fab layer
2017-09-15 Add components from kicad to tinkerforge libraries
2017-09-15 Add 3D model OQ_3P_grey
    [OQ_3P_grey.fcstd, OQ_3P_grey.step, OQ_3_grey.fcstd]
2017-09-15 Rename file
    [OLED 128x64.fcstd, OLED_128x64.fcstd]
2017-09-15 Add 3d model: OLED_128x64
    [OLED_128x64.step]
2017-09-20 fix shield footprint
2017-09-20 Add new component 20.11.17
    [Dust Detector.fcstd]
2017-09-27 fix footprint, add pin1 marking
2017-09-27 fix pin counting
2017-09-29 fix pin numbering
2017-10-23 Add 3d models (*.step & *.wrl)
    [SC-70-5.STEP, SC-70-5.step, SC-70-6.STEP, SC-70-6.step, SC-70.step]
2017-11-02 Add new footprint
2017-11-02 LCD 20x4: Add 3d model (*.step & *.wrl)
    [LCD_4X20.step]
2017-11-02 LCD Pot36: Add 3d model (*.step & *.wrl)
    [POT-3306W.step]
2017-11-02 motorized fader module: Add 3d model (*.step & *.wrl)
    [RSA0N11M9A0J.step]
2017-11-06 Add new 3d model: RGB-LEB Button
    [RGB_SWITCH_AD.fcstd, RGB_SWITCH_AD.step]
2017-11-06 add new component
    [Garmin LIDAR-Lite v3.fcstd]
2017-11-06 Reorder components into new category: Sensors_Detectors
    [Dust Detector.fcstd, FN-TCS3472-color.fcstd, FN-TCS3472-color.step, FT-GPS-001.fcstd, FT-GPS-001.step, FireFlyX1.fcstd, FireFlyX1.step, Garmin LIDAR-Lite v3.fcstd]
2017-11-06 Lidar v3: Add 3d information and model (*.step & *.wrl)
    [Garmin_LIDAR-Lite_v3.step]
2017-11-06 Add FLIR 500-0763-01 model
    [FLIR-500-0763-01.fcstd, FLIR-500-0763-01.step]
2017-11-06 Crystal 5032: Add 3d model (*.step & *.wrl)
    [5032.step]
2017-11-06 SOP-20: Add 3d model
    [SOP-20.fcstd, SOP-20.step]
2017-11-06 Segment 4x7: Add 3d model
    [Segment_4x7.fcstd, Segment_4x7.step]
2017-11-06 ufl fab layer update, pin 1 marking
2017-11-08 Change colors to more realistic ones
    [BrickletConn_10pin.fcstd, BrickletConn_10pin.step, BrickletConn_10pin_tooHot.step, BrickletConn_7pin.fcstd, BrickletConn_7pin.step]
2017-11-08 Add 3d model for Distance IR sensor modules: S3B-PH-SM4
    [S3B-PH-SM4.fcstd, S3B-PH-SM4.step]
2017-11-09 Fix rotation offset
    [BrickletConn_10pin.fcstd, BrickletConn_10pin.step]
2017-11-09 XLR 2x3: add 3d files (*.step & *.wrl)
    [XLR_2x3.fcstd, XLR_2x3.step]
2017-11-09 Fix colors to more realistic ones
    [RSA0N11M9A0J.fcstd, RSA0N11M9A0J.step]
2017-11-13 LGA16 3x3mm: Add 3d model (*.step & *.wrl)
    [LGA-16_3x3mm_Pitch0.5mm.step]
2017-11-13 BME680: Add 3d model
    [BME680.fcstd, BME680.step]
2017-11-15 add smaller 0402 footprint
2017-11-15 Add 3d information to new footprint size 0402F
2017-11-15 Add 3d model for PS1420 Buzzer
    [PS1420_Buzzer_14mm.step]
2017-11-20 Rename files
    [FLIR-500-0763-01_socket.fcstd, FLIR-500-0763-01_socket.step]
2017-11-20 Add 3d models (with / without socket)
    [FLIR-500-0763-01_module.step]
2017-11-20 Dust Detector: add *.wrl and *.step
    [GP2Y1010AU0F.step]
2017-11-20 Add footprint
2017-11-23 Add symbol 4Wire touch screen connector
2017-11-23 Add symbols for touch screen connectors
2017-11-23 LCD-ERM320240-2: add footprint
2017-11-27 Add footprint ER-CON24HT-1 for eInk display
2017-11-27 Add correct pin numbers
2017-11-27 Add new footprint: ERC12864-655_128x64
2017-11-27 Add 3d model: VEML6070-UVlight sensor
    [VEML6070-UVlight.fcstd, VEML6070-UVlight.step]
2017-11-27 Rotary Encoder: Add 3d model (final)
    [RotaryEncoder.step]
2017-11-27 AZ943 relay: Add 3d model
    [AZ943-1CH-5DE-Relay.fcstd, AZ943-1CH-5DE-Relay.step]
2017-11-30 Fix holes
2017-12-04 move outline and text from silkscreen to fab layer
2017-12-04 Add 3d information and 3d model for LPS22HB
    [LPS22HB_HLGA-10L.fcstd, LPS22HB_HLGA-10L.step]
2017-12-04 Add ER-CON04HB-2 (touch screen connector for LCD128x64)
2017-12-05 add dual n ch mosfet
2017-12-27 Expand drill holes and pads
2018-01-02 add vssop10 footprint
2018-01-02 add rgb led footprint
2018-01-02 add rgb led symbol
2018-01-03 move silkscreen layers to fab layer
2018-01-03 jst ph 2 pole tht footprint added
2018-01-08 Add new footprint: PMS7003
2018-01-09 change from silkscreen to fab layer
2018-01-15 Move outlines from silkscreen to f.fab
2018-01-16 move outlines from silkscreen to fab layer
2018-01-22 Add 3d model (*.step, *.wrl & *.FCStd): AB26TRQ oscillator
    [AB26TRQ.fcstd, AB26TRQ.step]
2018-01-29 change footprint text to fab layer
2018-01-30 Add 3d model for 2998 battery retainer and attach files so footprint
    [battery_retainer_2998.fcstd, battery_retainer_2998.step]
2018-01-30 Add new 3d model: shield for NFC-Bricklet
    [shield_SHD1_nfc.fcstd, shield_SHD1_nfc.step]
2018-02-01 FT-004B: add 3d information to foot print and 3d model
    [FT-004B.fcstd, FT-004B.step]
2018-02-01 RFM69HW: add 3d information to foot print and 3d model
    [RFM69HW.fcstd, RFM69HW.step]
2018-02-01 Update 3d model
    [RFM69HW.fcstd]
2018-02-05 RFM210LCF-S1: Add 3d model
    [RFM210LCF-S1.fcstd, RFM210LCF-S1.step]
2018-02-12 fix lcd128-64 footprint pin distances
2018-02-15 D1206_INV: Add 3d model
    [D1206_INV_blue.fcstd, D1206_INV_blue.step]
2018-02-15 Fresnel_Lens_S8002: Add 3d model
    [Fresnel_Lens_S8002.fcstd, Fresnel_lens_S8002.step]
2018-02-15 Add 3d model (tbc)
    [OQ_6P_green.fcstd]
2018-02-27 Add new 3D components
    [Antennen Conector.fcstd, Kappe NFC.fcstd, LED 1206.fcstd, MD Kappe.fcstd, OW Modul.fcstd, Remote Modul.fcstd]
2018-02-28 change 3D remote modul
    [Remote Modul.fcstd]
2018-02-28 change one 3D model
    [MD Kappe.fcstd]
2018-02-28 Rename and reorder
    [Antennen Conector.fcstd, D1206_INV_blue.fcstd, FT-004B.fcstd, Fresnel_Lens_S8002.fcstd, Fresnel_lens_S8002.fcstd, Kappe NFC.fcstd, LED 1206.fcstd, MD Kappe.fcstd]
2018-02-28 Rename old models with "_simple" suffix
    [D1206_INV_blue_simple.fcstd, D1206_INV_blue_simple.step, FT-004B_simple.fcstd, FT-004B_simple.step, Fresnel_lens_S8002_simple.fcstd, Fresnel_lens_S8002_simple.step, RFM69HW-simple.fcstd, RFM69HW-simple.step]
2018-02-28 Add *.step and *.wrl files from more sophisticated models
    [D1206_INV_blue.step, FT-004B.step, Fresnel_lens_S8002.step, RFM210LCF-S1.step, RFM69HW.step, shield_SHD1_nfc.step]
2018-03-06 TSSOP24: Add 3d model to footprint
2018-03-06 OQ_3P: add black and green colored models
    [OQ_3P_black.fcstd, OQ_3P_black.step, OQ_3P_green.fcstd, OQ_3P_green.step]
2018-03-06 OQ_6P: Add models in grey and green color
    [OQ_6P_green.fcstd, OQ_6P_green.step, OQ_6P_grey.fcstd, OQ_6P_grey.step]
2018-03-07 change silkscreen to fab layer
2018-03-09 fix footprint pinout
2018-03-14 add new 3D componends 14.03.18
    [CO2 Modul.fcstd]
2018-03-16 add footprints
2018-03-27 Add female pin headers (1x01 - 1x20, straight)
    [Pin_Header_Straight_Female_1x02.step, Pin_Header_Straight_Female_1x03.step, Pin_Header_Straight_Female_1x04.step, Pin_Header_Straight_Female_1x05.step, Pin_Header_Straight_Female_1x06.step, Pin_Header_Straight_Female_1x07.step, Pin_Header_Straight_Female_1x08.step, Pin_Header_Straight_Female_1x09.step]
2018-03-27 Add 3d models to footprints
2018-03-27 Rename and reorder files
    [CO2 Modul.fcstd, SenseAir_K30.fcstd]
2018-03-27 SenseAir K30: Add *.step and *.wrl files
    [SenseAir_K30.step]
2018-03-27 Add specific footprint for distance US module
2018-04-04 LCD126x64: Fix pin positions
2018-04-11 new footprint and symbols added
2018-04-12 new idc header footprint
2018-04-16 Add DSUB-15 female & male connector
    [DSUB15-Female.step, DSUB15-Male.step]
2018-04-16 Add DSUB-9 female & male connector
    [DSUB9-Female.step, DSUB9-Male.step]
2018-04-16 G5LE-1: add 3d model (*.wrl & *.step)
    [G5LE-1-Relay.step]
2018-04-16 ICS43432: add 3d model
    [ICS43432-SoundPressure.fcstd, ICS43432-SoundPressure.step]
2018-04-16 SO-5: add 3d information to footprint
2018-04-16 SO-5: add 3d model (*.step & *.wrl)
    [SO-5.step]
2018-04-16 new footprints added
2018-04-23 PCC-SMP: add 3d model
    [PCC-SMP.fcstd, PCC-SMP.step]
2018-04-23 PMS7003: add 3d information to footprint
2018-04-23 PMS7003: add 3d model
    [PMS7003.fcstd, PMS7003.step]
2018-04-23 stm32f0 symbol drawing
2018-04-23 fix outline of stm32 symbol
2018-04-24 Pin header for Raspberry Pi: add 3d model
    [Pin_Header_Straight_Female_2x20_RaspPi.fcstd, Pin_Header_Straight_Female_2x20_RaspPi.step]
2018-04-24 Raspberry Pi 3b: add simple 3d model
    [raspberryPi3b-simple.step]
2018-04-24 Change color: old green was to aggressive
    [raspberryPi3b-simple.step]
2018-04-27 add 16pin connector
2018-05-02 fix raspberry pi footprint
2018-05-07 add tng connector
2018-05-07 Add 2X3 connector
2018-05-14 Add TNG BTB connectors
2018-05-14 Add specific QFN64 footprint for USB2517
2018-05-16 fix tng connectors and symbols
2018-05-28 OQ_12P_green: add 3d model
    [OQ_12P_green.fcstd, OQ_12P_green.step]
2018-05-28 Add elko 10x10 3d files
    [c_elko_10x10.step]
2018-05-28 Add tact switch angled 3d files
    [TACT-6MM-HOR.step]
2018-05-28 Add micro usb 3d files
    [micro-usb-smd.step]
2018-05-28 Add VSSOP-10 housing
    [VSSOP-10.fcstd, VSSOP-10.step]
2018-05-28 Add WE-SL-2 3d files
    [WE-SL-2.step]
2018-05-28 Add SO-16 housing
    [SO-16.step]
2018-05-28 Add SMA angled 3d files
    [SMA-angled-long.fcstd, SMA-angled-long.step]
2018-05-28 Add 2920 fuse 3d files
    [2920-fuse.step]
2018-05-30 remove solder paste layer
2018-06-07 add some 3d models 07.06.18
    [D-Sub 9 Stecker.fcstd, Microphone MEMS.fcstd, PMS7003.fcstd, Relay.fcstd, Thermocouple K.fcstd, battery_retainer.fcstd]
2018-06-11 add one 3d model
    [CRE1S.fcstd]
2018-06-11 Remove and rename some files
    [CRE1S.fcstd, CRE1S.step, D-Sub 9 Stecker.fcstd, DSUB9-Male.fcstd, DSUB9-Male.step, DSUB9-Male_old.step, G5LE-1-Relay.fcstd, G5LE-1-Relay.step]
2018-06-21 add 20x2 connector symbol
2018-06-22 add the dual button 3d model
    [Dual Button.fcstd]
2018-06-22 Add 3d files (*.wrl & *.step)
    [TACT_SWITCH_12mm.step]
2018-06-22 KX122-1037: Add new component footprint
2018-06-25 LGA12: add 3d model (*.wrl & *.step)
    [LGA-12_2x2mm.step]
2018-06-27 PLCC6: add footprint
2018-06-27 change raspberry pi symbol, add 74ahc244 symbol
2018-06-27 pin_array_6x2: add footprint
2018-06-28 add new footprints and symbols
2018-07-04 QFN-20-3x3: add footprint
2018-07-06 Pin_Header_Angled_2x6: add 3d files (*.wrl & *.step)
    [Pin_Header_Angled_2x6.step]
2018-07-06 Move, rename and merge Joystick files
    [Joystick Taster.fcstd, Joystick.fcstd, Joystick_withButton.fcstd]
2018-07-06 Add 3d files and information to footprint
    [Joystick_withButton.step]
2018-07-06 new qfn16 footprint
2018-07-12 add new 3d data
    [BrickletConn_7pin_180.fcstd, BrickletConn_7pin_180.step, JST-PH-3-THT.fcstd, JST-PH-3-THT.step]
2018-07-13 Optical adjustments
    [BrickletConn_7pin_180.fcstd, BrickletConn_7pin_180.step]
2018-07-13 More optical adjustments
    [BrickletConn_7pin_180.fcstd, BrickletConn_7pin_180.step]
2018-07-13 Fix Z axis alignment
2018-07-13 NRS5030: add 3d models
    [NRS5030.fcstd, NRS5030.step]
2018-07-20 add marking to antenna footprint
2018-07-20 SHT31-DIS-B: add *.FCStd file
    [SHT31-DIS-B.fcstd]
2018-07-20 Add new version of the btb connectors
    [btb_btm.fcstd, btb_btm.step, btb_top.fcstd]
2018-07-31 add some 3d models 31.07.18
    [BME680.fcstd, ER-TP028-1 connector.fcstd, LCD 128x64 Buchse.fcstd, Linear Poti Slider.fcstd, Linear Poti.fcstd, OLED Buchse.fcstd, Rotary Encoder.fcstd, Rotary Knopf.fcstd]
2018-07-31 BME680: rename and reorder
    [BME680_SP.fcstd]
2018-07-31 Add 3d model for new lcd display
    [ER-TP028-1.fcstd, ER-TP028-1.step]
2018-07-31 Add 3d model for new lcd display touchscreen connector
    [CON_4Wire_ER-TP028-1.fcstd, CON_4Wire_ER-TP028-1.step, LCD 128x64 Buchse.fcstd]
2018-07-31 fix footprints female header
2018-07-31 OLED128 Conn: rename and reorder
    [CONN_OLED_128x64.fcstd, CONN_OLED_128x64.step, OLED Buchse.fcstd]
2018-07-31 Add some freecad files
    [RGBLED_Button.fcstd, battery_retainer_small.fcstd]
2018-08-09 add zero hat footprint
2018-08-09 add slide switch symbol and footprint
2018-08-13 update slide switch footprint
2018-08-17 add new piezo speaker footprint and symbol
2018-08-29 add new piezo speaker footprint
2018-08-31 add some icons, bq24195 symbol and DMMT5401 symbol and footprint
2018-09-04 adding 5v symbol
2018-09-07 added SCD30 footprint
2018-09-12 fix tng connector pin descriptions
2018-09-12 add raspberry pi 200 pin socket
2018-09-13 add pads to solder mask
2018-09-13 add mounting holes for compute module
2018-09-13 fix footprint pads
2018-09-13 add 3d data with module
    [Raspberry-Pi-Compute-Socket-Module.step, Raspberry-Pi-Compute-Socket.fcstd]
2018-09-18 Changed PT-4532PLQ footprint (enlarged the thruholes)
2018-09-26 added HRLV-EZ footprint an symbol
2018-09-26 add 3d data
    [HRLV-EZ.fcstd, HRLV-EZ.step]
2018-10-08 add new power supply symbols
2018-10-23 remove silkscreen lines
2018-10-24 add new logo, new pin header
2018-10-24 fix footprint numbering
2018-11-07 fix footprints, symbols
2018-11-27 add FBGA153 footprint
2019-01-14 add micro sd footprint
2019-01-15 add new sd card connectors
    [5031821852.step, SD-DM3CS.step]
2019-01-15 add new micro usb connector
    [USB_Micro_Vertical.step]
2019-02-04 added symbol and footprint for WS2813B
2019-02-05 fix tng connector
2019-02-05 added 3d model ws2813b
    [WS2813B.step]
2019-02-07 changed pin array 8x1 smd
2019-02-13 fix footprints, remove silkscreen layers
2019-03-18 modified connectors
2019-03-19 added footprints and new HAT logos
2019-03-20 added wuerth M3 spacer footprint
2019-03-21 added solder stencil to WA-SMSI-M3-SPACER
2019-04-04 added LGA footprint for compass sensor
2019-04-04 changed pinout for compass sensor
2019-04-08 updated footprint DFN2030 and VQFN20_45x35 (extended pads)
2019-04-08 changed footprintsize for HRLV-EZ
2019-04-15 added new symbols and footprints for powersupply bricklet
2019-04-16 added new connectors for energy monitor bricklet
2019-04-17 changed HRLV footprint. added centerpoint for better placement
2019-04-23 added footprint SARA
2019-04-24 added symbol 2M2_SIM and acording footprint SLM76CF3201P
2019-04-24 fix 3d data
    [btb_btm.step]
2019-04-26 add some 3d models
    [3x3mm WDFN12 PAM 2306.FCStd, 56-QFN LAN7500.FCStd, CAP330mF EDLC.FCStd, DO-214AB 3.0SMI30CATR.FCStd, Temperatur 2.0.fcstd]
2019-04-26 transfer 3d models to kicad
    [CAP330mF EDLC.FCStd, ELNA_DSK.FCStd, ELNA_DSK.step, QFN-56-8x8mm_Pitch0.5mm.FCStd, QFN-56-8x8mm_Pitch0.5mm.step, SMC.FCStd, SMC.step, WDFN-12-3x3.fcstd]
2019-04-26 adding file
    [WE-CMB-XS.step, WE-SL5.step, WE-UCF.step]
2019-04-29 changed footprint dc-033
2019-05-03 added new symbols and footprints for the new gas bricklet
2019-05-09 add 3d models and foodprints
    [F6005N Knop.fcstd, F6005N.fcstd, F6005N.step, JST_GHR_6.fcstd, JST_GHR_6.step, PT-4532PLQ.FCStd, PT-4532PLQ.step, PT_4532PLQ002_cp.step]
2019-05-10 add a 3d model
    [ER-CON24HT-1.FCStd, ER-CON24HT-1.step]
2019-05-13 new footprint added
2019-05-13 add the 3d model for the XMC processors
    [ER-CON24HT-1.FCStd, ER-CON24HT-1.step, XMC 1100.fcstd, XMC 1300.step, XMC 1400.fcstd, XMC 1400.step, XMC_1100.step, XMC_1300.step]
2019-05-13 fix socket footprint
2019-05-13 add the ePaper model
    [ePaper Display.fcstd, ePaper_Display.step]
2019-05-29 added spec sensor footprint and symbol
2019-05-29 added 3d files for spec-sensor
    [spec.-sensor.step]
2019-06-03 renamed spec-sensor.step
    [spec-sensor.step]
2019-06-17 added pin array 6x3
2019-06-18 added components for servo bricklet
2019-07-03 add foodprint for the hat bricklets
    [20x2 Female.FCStd, HRLV-MaxSonar.FCStd, HRLV-MaxSonar.step, raspberrypi_hat2.step, raspberrypi_zero_hat.step]
2019-07-24 add some parts
    [PDQE10.FCStd, PDQE10.step]
2019-08-15 change filename
    [LGA-16_3x3mm_Pitch0_5mm.step]
2019-08-15 new 3d data
    [HRLV.step, rotary_poti.step, rotary_poti_knob.step]
2019-08-30 add new footprint and symols
2019-09-02 add antenna footprint
2019-09-03 fix antenna design, add new 0402 design
2019-09-05 new parts added
    [SDP810.FCStd, SDP810.step]
2019-09-23 add positioning silkscreen
2019-09-27 add missing step file
    [SIM8060-6-0-14-00-A.stp]
2019-10-31 add new parts
    [TEL10.FCStd, TEL10WI.step, WE-CMB-M.FCStd, WE-CMB-M.step, tel10wi_cp.step]
2019-11-05 add new symbols, footprints and 3d data
    [CPC1907B.FCStd, CPC1907B.step, SMB.FCStd, SMB.step, SMC.FCStd, SMC.step, TO263-7.FCStd, TO263-7.step]
2019-11-05 Remove unused 3D models that create a caseless name conflict
    [SC-70-5.STEP, SC-70-6.STEP]
2019-11-07 add new data
    [B2B-PH-K-S.FCStd, B2B-PH-K-S.step, JST_PH_2_Top.FCStd, LFCS8-3x3.FCStd, LFCS8-3x3.step, SIM-CHIP.FCStd, SIM-CHIP.step, SW_06_SMD.FCStd]
2019-11-12 fix antenna bottom openings
2019-11-22 new footprint, fix led lp footprint
2019-12-23 update drill diameter
2019-12-30 fix inductor footprint
2020-01-07 added symbols and footprints
2020-01-16 added SOT669 footprint
2020-01-22 added symbols and footprints for silent stepper bricklet
2020-01-24 added new symbols and footprints for silent stepper and dc bricklet
    [SON_5x6mm.step]
2020-01-27 add 3d libraries, fix footprint
    [DLC-L05D-D4.FCStd, DLC-L05D-D4.step]
2020-01-27 add 3d pin header
    [Pin_Header_Straight_2x05_Pitch1.27mm.FCStd, Pin_Header_Straight_2x05_Pitch1.27mm.step]
2020-01-29 changed pin arrangement from tmc5160
    [SON_5x6mm.fcstd]
2020-01-31 changed pin layout of tmc5160 symbol
2020-02-05 changed SMB footprint layer from silk front to front fab
2020-02-06 added 18mm ELKO footprint
2020-02-07 added symbol, footprint and 3d model for usb c
    [USB4105.step]
2020-02-11 changed pin orientation for usb c
2020-02-11 add 4 3d models
    [OQ_2P_black-5mm_vertical.FCStd, OQ_2P_green-5mm_vertical.FCStd, OQ_4P_5mm_vertical.FCStd, OQ_4P_vertical.FCStd]
2020-02-12 added 3d models to new 5mm pitch connectors
    [OQ 2P black-5mm vertical.step, OQ 2P green-5mm vertical.step, OQ 4P 5mm vertical.step, OQ 4P vertical.step]
2020-02-12 added STMPS2171STR symbol and footprint
2020-02-21 add sata and pcie footprints
2020-03-02 add hook footprint + 3d, fix symbols and footprints
    [PE_Hook.FCStd, PE_Hook.step]
2020-03-11 changed usb c footprint and symbol
2020-03-11 edited bootpad footprint, removed soldermask from the whole pad
2020-03-11 edited footprint 3528-21, changed "+" from Silkscreen to F.Fab
2020-03-13 added paste layer to tht holes
2020-04-02 added footprint for FC107 supercap
2020-04-02 added symbol and footprint for DRV8701
2020-04-08 added MSR-3 Footprint
2020-04-17 add esp32
    [ESP32-WROOM-32.FCStd, ESP32-WROOM-32.step]
2020-06-18 added plated drillhole, added new logo,
2020-06-22 added some footprints
2020-06-22 added 3d models for VL53L1
    [VL53L1.step]
2020-06-23 shrinked pads of TACT-6MM-HOR
2020-07-01 removed silkscreen and added PQFP-44
2020-07-01 added pin arrays with 2mm pad and 1mm drill
2020-07-07 added SMA footprint
2020-07-08 added TMP235 symbol and DNF5 footprint
2020-07-13 added mini pcie full and half footprint, added BL-R8822BU1 footprint, added mini Pcie symbol
2020-07-28 added irm-10 symbol and footprint, added wpmdl symbol and footprint
2020-07-28 added V7-8 footprint
2020-07-29 added 3d models
    [AKL-5-4.step, IRM_10.step, OMNI-BLOK.step, V7-8.step, WPMDL110.step]
2020-08-05 added fuse holders and fuses
    [749118115.step, MRF.step]
2020-08-06 SON_5x6mm: changed pin 1 mark on fab layer
2020-08-14 changed footprint IRM-10 and WPMDL110 wrong pinout
2020-09-11 add 3d stuff
    [B3U-1000P.FCStd, B3U-1000P.step]
2020-10-02 Added Footprints
2020-10-02 added 3d files for OQ_3P_vertical
    [OQ_3P_vertical.step]
2020-10-05 fix footprint types
2020-10-06 fix footprint type
2020-10-14 Added PA1616 footprint, changed all vertical OQ connectors F.Fab layer
2021-01-07 add new stuff
    [CS-4-22YA.FCStd, CS_4_22YA.step]
2021-01-25 new parts
    [BL654.step]
2021-02-02 fix footprints and symbols
2021-02-16 add new symbols and footprints
2021-02-22 added JST_PH-2-SMD
    [B2B-PH-SM4-TB(LF)(SN).step]
2021-02-23 added footprints and 3d data
    [4641-X900.step]
2021-03-04 edited finder34.51 footprint
2021-03-15 added pin-array_3x5 3d files
    [pin-array_3x5.step]
2021-03-16 fix bl654 pin description
2021-04-28 fix 3d models
    [Var_10mm.FCStd, Var_10mm.step, aqh-relay.FCStd, aqh-relay.step]
2021-08-26 -added MasterModul symbol -added B03B-XASK 230V version -added OQ_3P 230v Version
2021-08-26 added Ind. Quad Relay modul
2021-11-02 update drill diameters
2021-12-30 change footprint and symbols
2022-04-01 add 3d model for wrover e
    [ESP32-WROVER-E.FCStd, ESP32-WROVER-E.step]
2022-04-01 add 3d files
    [WPMDL110_side.FCStd, WPMDL110_side.step]
2022-07-28 add kicad6 library version
2022-08-25 added 2.7mm plated drill
2022-08-25 added logo footprints
2022-08-29 added 25mm logo
2022-11-14 Changed hole size VAR_10mm
2022-11-15 remove kicad5 symbol library
2022-11-15 added G5Q-1 Symbol and Footprint
2022-11-21 added 3d model for 36-4910
    [4910_rev.C.step]
2022-11-29 updated G5Q-1 Footprint
2023-01-24 added DRILL_NP_New, New standart drill for bricklets, Works with kicad 6 DRC, changed drill size to 3,2 mm
2023-01-25 Updated the Drill_NP Footprint
2023-01-26 switched text to F.fab layer
2023-01-27 Moved text from silkscreen to f.fab layer
2023-02-14 fix 3d settings for kicad6
2023-02-17 updated 3d data
    [0PTF0078P.step, 742792510.step, HTSSOP28-DRV.step, MOV-10D431KTR.step, OQ 2P green-5mm.step, PDIP-8.step, RPM-6.0.step, WE-PBF.step]
2023-02-17 fixxed 3d data
    [MOV-10D431KTR.step]
2023-05-12 added RPX-4.0 footprint
2023-05-23 changed rpx-4.0 footprint
2023-05-24 Adden RAC03E
    [RAC03E-05SK_277.step]
2023-06-27 updated IRM-10 and IRM-02 Footprint / Bigger through-holes
2023-06-27 added din-rail-mount footprint
    [vertical-rail-mounting-kit PCB v1.step]
2023-07-04 fix footprint, add symbol
2023-07-07 added Mini-Din footprint and s.Quad symbol
2023-07-28 Added LSMTSO-M3 Footprint and 3D model
    [LSMTSO-M3-2-ET.step]
2023-08-08 added C1210P and CRYSTAL_7050 Footprint added HI-3717 Symbol
2023-08-23 make some footprints compatible to kicad7
2023-08-23 kicad7 update
2023-09-26 added 74991114410 Footprint and 3D model
    [74991114410.stp]
2023-09-26 added 614004185023 footprint and 3d Model
    [614004185023.stp]
2023-09-27 add mounting holes
2023-10-25 add pe symbol, fix drill footprint
2023-11-03 add mounting holes to paste layer
2023-12-05 fix mounting hole positions (-1.1mm)
2024-02-01 add testpoint stuff
    [TSTP_MINI.FCStd, TSTP_MINI.step]
2024-02-02 add to-220
    [TO-220AC.FCStd, TO-220AC.step]
2024-04-26 add new connector
    [200241-1122.FCStd, 200241-1122.step]
2024-06-24 add new models
    [AGQ2X0.FCStd, AGQ2X0.step, G5Q-1A.FCStd, G5Q_1A.step, OQ_2P_5mm_230V.FCStd, OQ_2P_5mm_230V.step, OQ_4P_5mm_230V.FCStd, OQ_4P_5mm_230V.step]
2024-09-24 add new rj45 jack
    [MTJ-88ARX1-FSM-LG.FCStd, MTJ_88ARX1_FSM_LG.step]
2024-10-08 fix 3d view
    [MTJ_88ARX1_FSM_LG.step]
2024-10-30 Conn-sensor-2 added pin description back on symbol
2025-06-05 added CMB-L footprint
2025-06-08 Fix quoting in two footprints
2025-06-30 remove broken footprints, fix R1210
2026-03-04 added 331221602040 EMI Contact Finger
2026-03-06 add led 3d model
    [LED-C-XR2S1.FCStd, LED-C-XR2S1.step]
