Tinkerforge/kicad-libraries/(notices)

Notices in the files:
3d/Resistors_SMD/R_1206.step:
Copyright (C) 2017, kicad StepUp
it under the terms of the GNU General Public License as published by
the Free Software Foundation, either version 3 of the License, or
any later version.
itself might be covered by the GNU General Public License.
